ryos17/robosub-ee/research/README.md

# Research

Research work for the RoboSub EE team — exploratory projects that aren't part
of the production vehicle firmware/hardware yet.

- **[`whisper_ivc/`](whisper_ivc/)** — underwater acoustic intervehicle
  communication: streaming hydrophone audio from the vehicle to the Orin and
  transcribing it live with Whisper, as a channel for one sub to "talk" to
  another. Working.

_Last updated: 2026-07-20_
