ryos17/robosub-ee/gen3/PCBs/Battery_Boards/Power_ManagementV3_diode/Power_ManagementV2_side.jpg

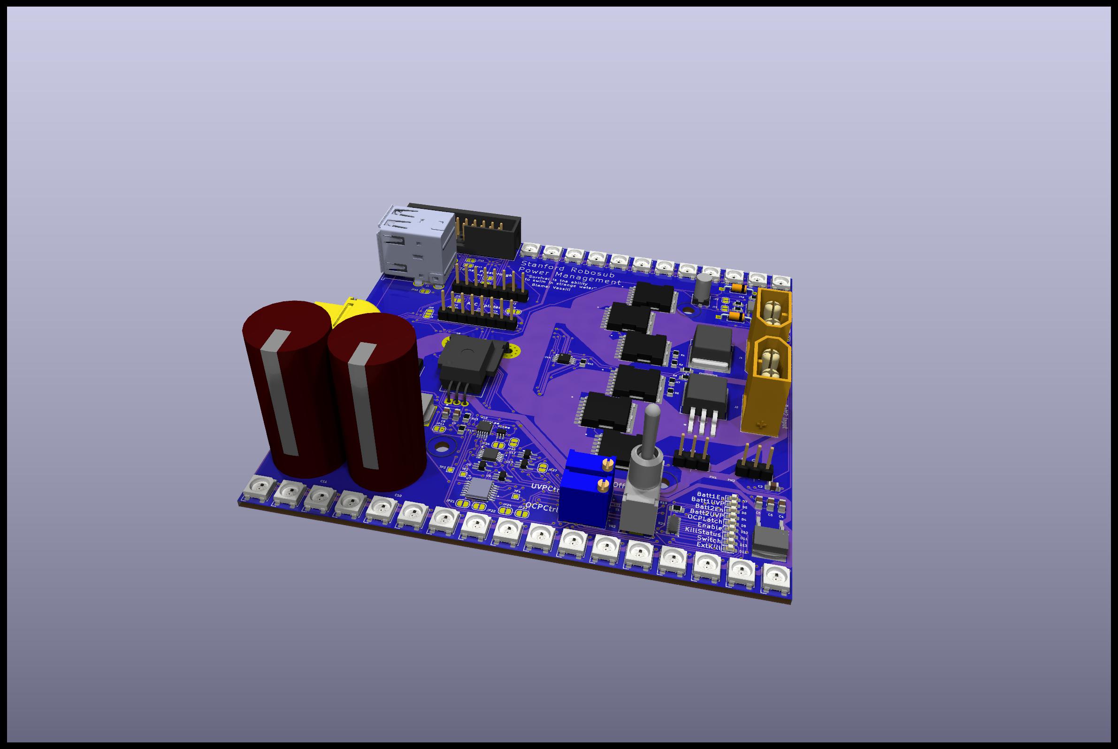
gen3/PCBs/Battery_Boards/Power_ManagementV3_diode/Power_ManagementV2_side.jpg
