ryos17/robosub-ee/misc/current_volatage_reading/current_over_time.png

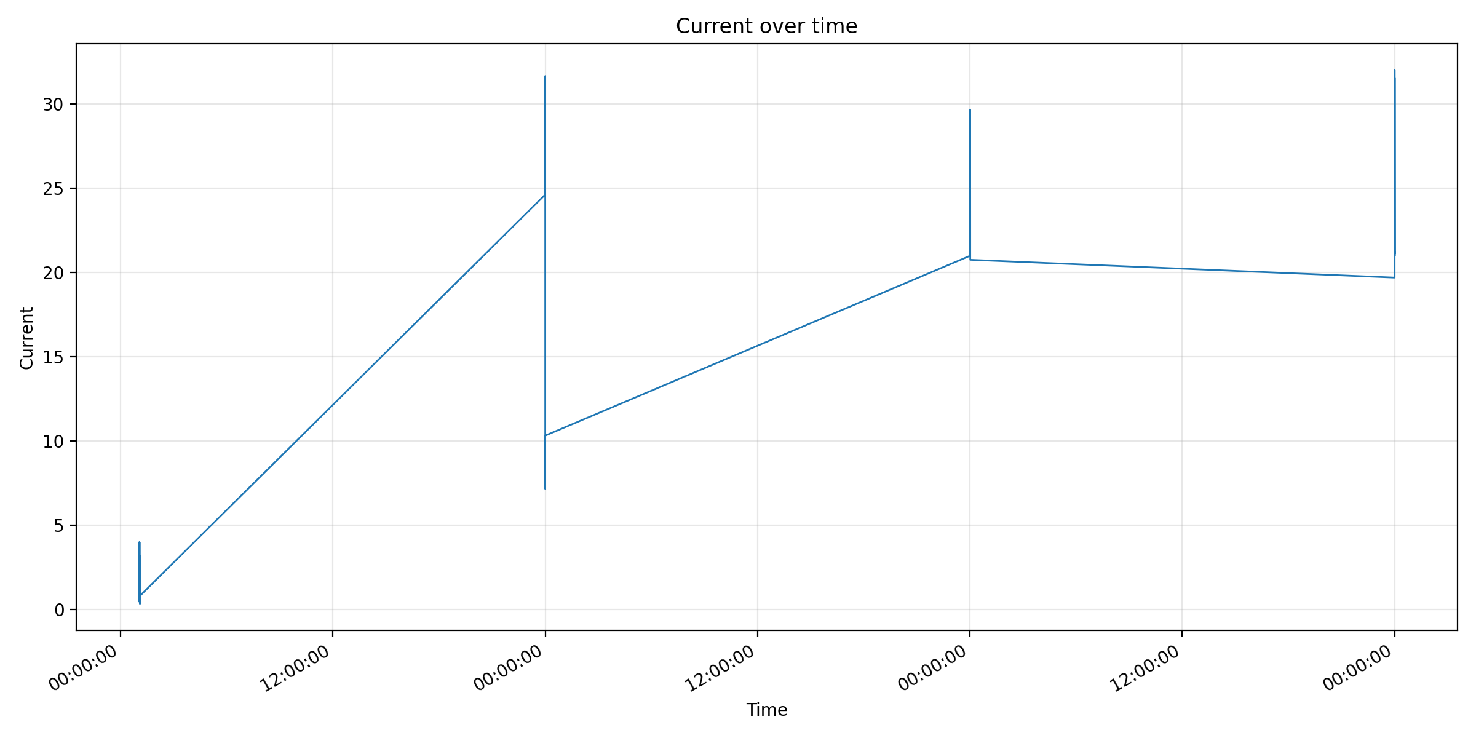
misc/current_volatage_reading/current_over_time.png
