ryos17/robosub-ee/misc/MBARI/MBARI_temperature_profiles.png

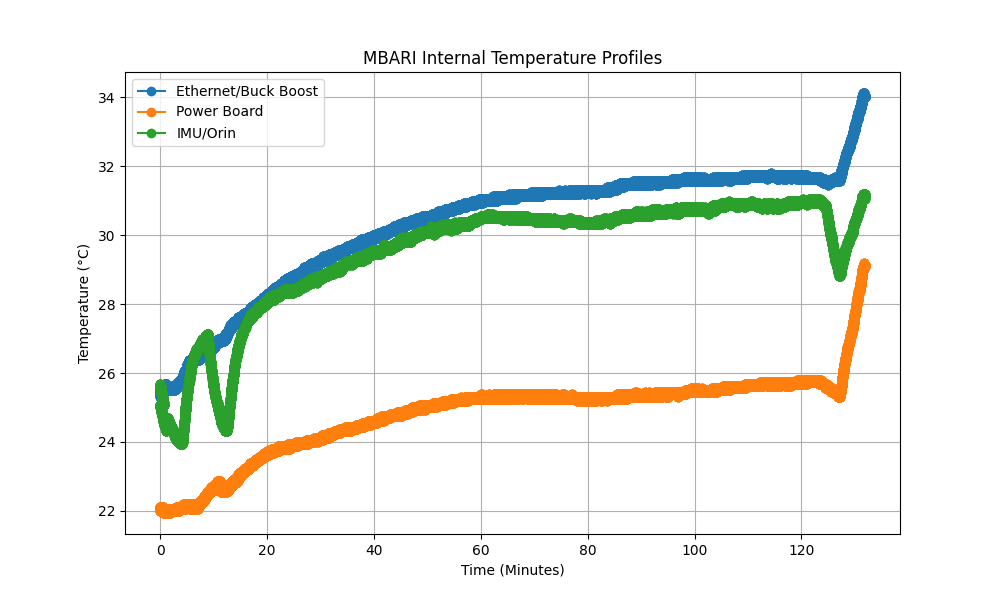
misc/MBARI/MBARI_temperature_profiles.png
