ryos17/robosub-ee/imported_parts/robosub_jlc_parts_log.csv

JLC_Part | Symbol_Name | Footprint | Description
C97627 | MS560702BA03-50 | robosub_footprints:MS560702BA03-50
C80862 | SHT31-DIS-B | robosub_footprints:SHT31-DIS-B
C58069 | L78M05ABDT-TR | robosub_footprints:L78M05ABDT-TR
C5120796 | AMS1117-3_3V_C5120796 | robosub_footprints:AMS1117-3_3V_C5120796
C94847 | MCP9808-E_MS | robosub_footprints:MCP9808-E_MS
C389354 | PMEG2020AEA,115 | robosub_footprints:PMEG2020AEA_115
C112988 | 2SK208-Y(TE85L,F) | robosub_footprints:2SK208-Y(TE85L_F)
C309277 | PJ-609BA | robosub_footprints:PJ-609BA
C5710904 | PTV09A-4015F-B503 | robosub_footprints:PTV09A-4015F-B503
C2876025 | SS-22F22-G060 | robosub_footprints:SS-22F22-G060
C16214 | DC-005_5_5-2_0MM | robosub_footprints:DC-005_5_5-2_0MM
