ryos17/robosub-ee/gen3/PCBs/Battery_Boards/Power_ManagementV3_diode/3D Models/SOS-ASM-LEAK-SENSOR-R1.SLDPRT

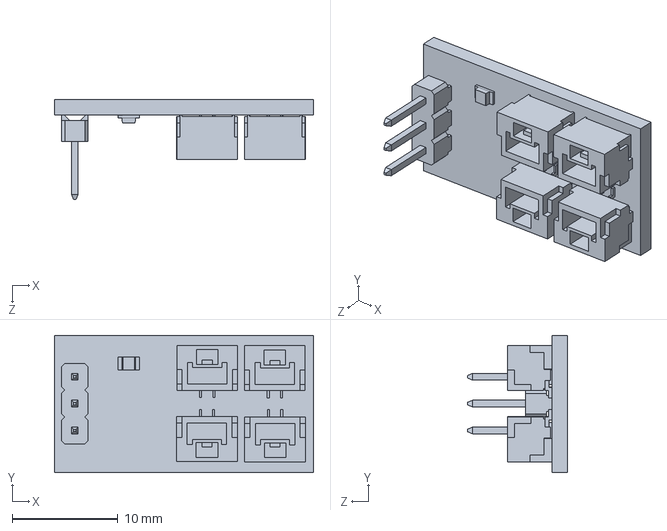
[picture p8: CAD file, 2026-02-21]
gen3/PCBs/Battery_Boards/Power_ManagementV3_diode/3D Models/SOS-ASM-LEAK-SENSOR-R1.SLDPRT
24.5 x 13.0 x 9.50 mm
