ryos17/robosub-ee/gen3/PCBs/Battery_Boards/Power_ManagementV3_diode/3D Models/CAP_UCB_4X7_NCH.step

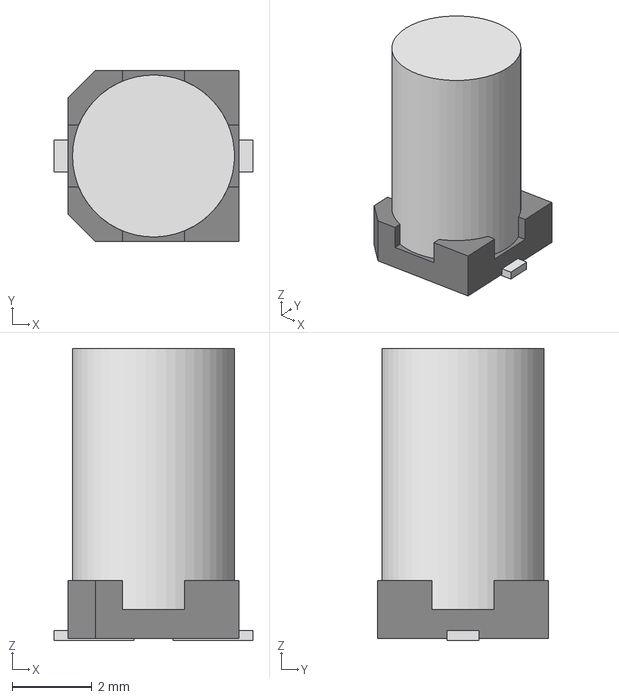
[picture p9: CAD file, 2026-02-21]
gen3/PCBs/Battery_Boards/Power_ManagementV3_diode/3D Models/CAP_UCB_4X7_NCH.step
5.00 x 4.29 x 7.34 mm
