ryos17/robosub-ee/gen3/PCBs/Battery_Boards/Power_ManagementV3_diode/_models/MCP6564_E_ST/TSSOP14_MC_MCH.step

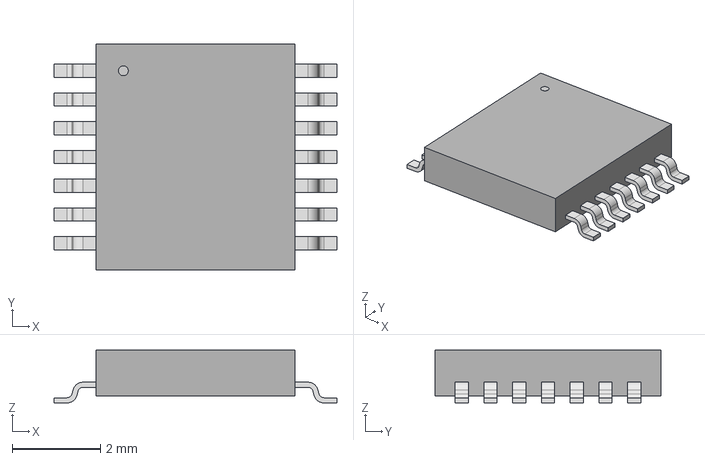
[picture p10: CAD file, 2026-02-21]
gen3/PCBs/Battery_Boards/Power_ManagementV3_diode/_models/MCP6564_E_ST/TSSOP14_MC_MCH.step
6.40 x 5.11 x 1.20 mm
