ryos17/robosub-ee/gen3/PCBs/Battery_Boards/Power_ManagementV3_diode/_models/SN74HC132PWR/SN74HC132PWR.step

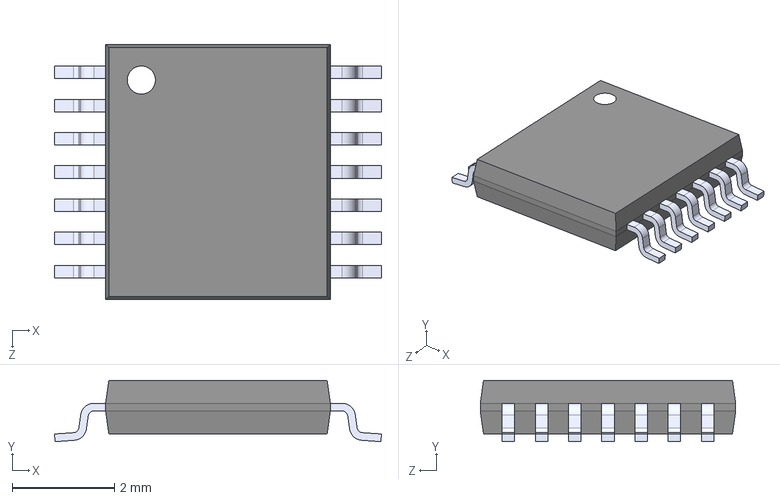
[picture p11: CAD file, 2026-02-21]
gen3/PCBs/Battery_Boards/Power_ManagementV3_diode/_models/SN74HC132PWR/SN74HC132PWR.step
6.40 x 1.20 x 5.00 mm
