ryos17/robosub-ee/gen3/PCBs/Battery_Boards/Power_ManagementV3_diode/_models/TC33X_2_105E/TC33X-2-105E.step

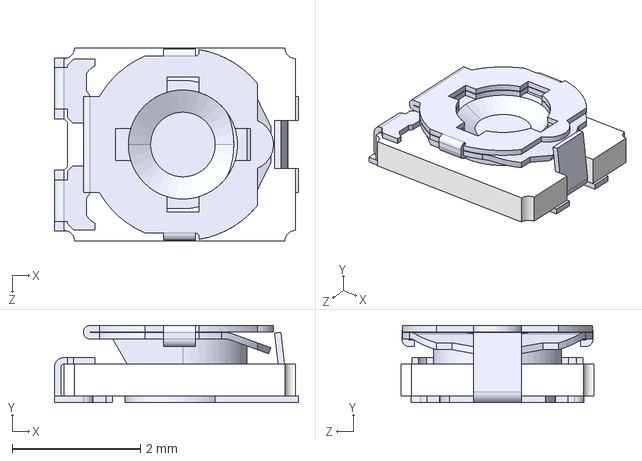
[picture p12: CAD file, 2026-02-21]
gen3/PCBs/Battery_Boards/Power_ManagementV3_diode/_models/TC33X_2_105E/TC33X-2-105E.step
3.80 x 1.20 x 3.00 mm
