ryos17/robosub-ee/gen3/PCBs/Power_Distribution/3D Models/TBL008V-1000-04BE.step

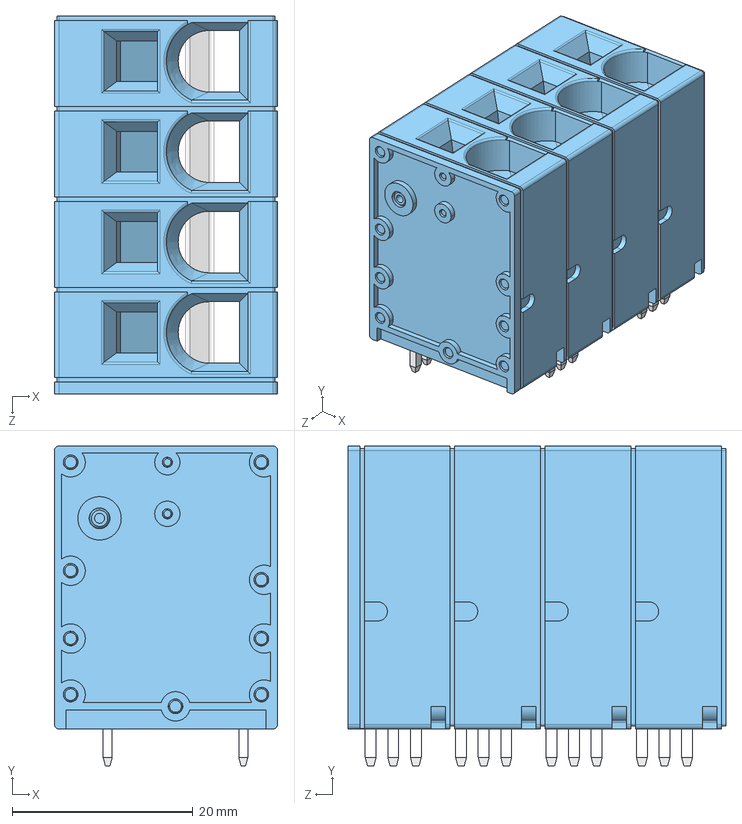
[picture p13: CAD file, 2026-02-25]
gen3/PCBs/Power_Distribution/3D Models/TBL008V-1000-04BE.step
24.7 x 35.4 x 41.8 mm
