ryos17/robosub-ee/imported_parts/robosub_3d_models/DC-005_5_5-2_0MM.step

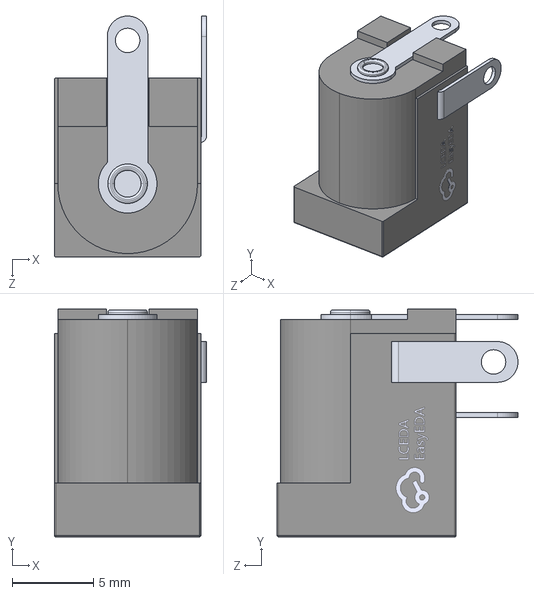
[picture p14: CAD file, 2026-07-27]
imported_parts/robosub_3d_models/DC-005_5_5-2_0MM.step
9.35 x 14.0 x 14.8 mm
