ryos17/robosub-ee/gen3/PCBs/Battery_Boards/Power_ManagementV3_diode/3D Models/URB2405YMD-20WR3.step

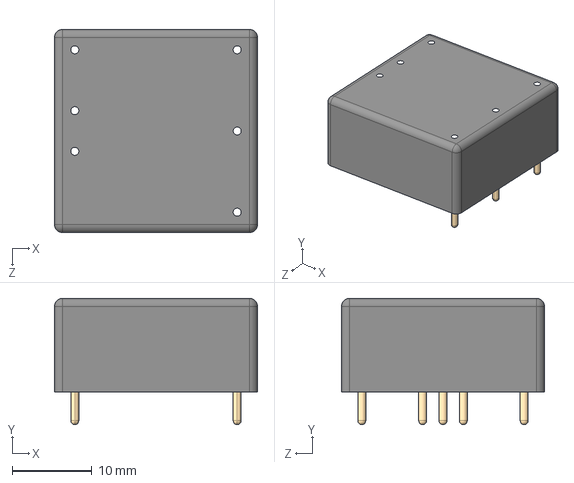
[picture p15: CAD file, 2026-02-21]
gen3/PCBs/Battery_Boards/Power_ManagementV3_diode/3D Models/URB2405YMD-20WR3.step
25.4 x 15.8 x 25.4 mm
