ryos17/robosub-ee/gen3/PCBs/Battery_Boards/Power_ManagementV3_eli/3D Models/ACS713ELCTR-30A-T.stp

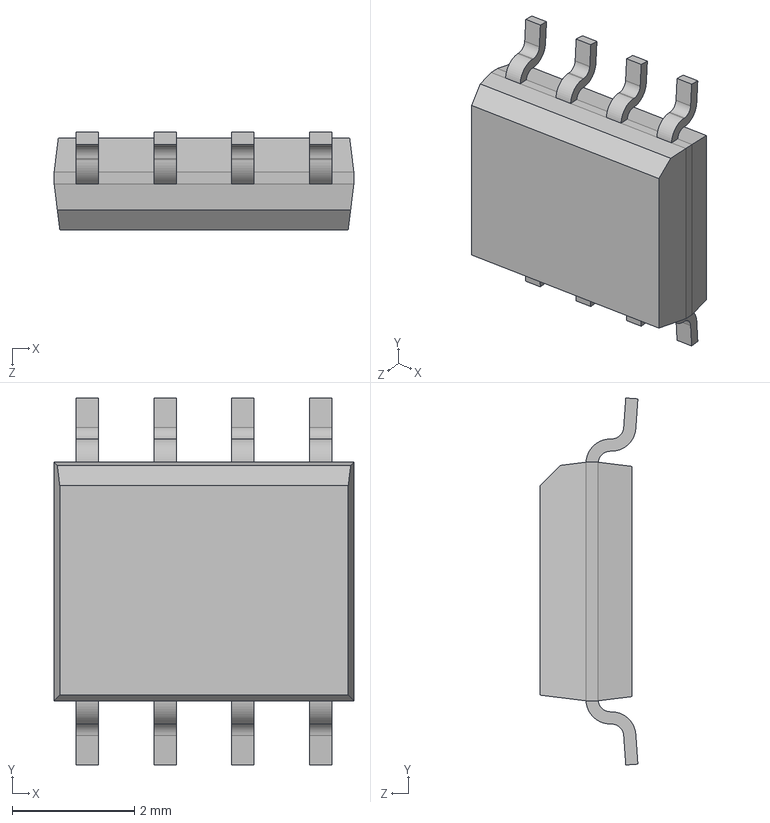
[picture p16: CAD file, 2026-02-21]
gen3/PCBs/Battery_Boards/Power_ManagementV3_eli/3D Models/ACS713ELCTR-30A-T.stp
4.90 x 6.00 x 1.60 mm
