ryos17/robosub-ee/gen3/PCBs/Power_Distribution/3D Models/XT60 FEMALE.STEP

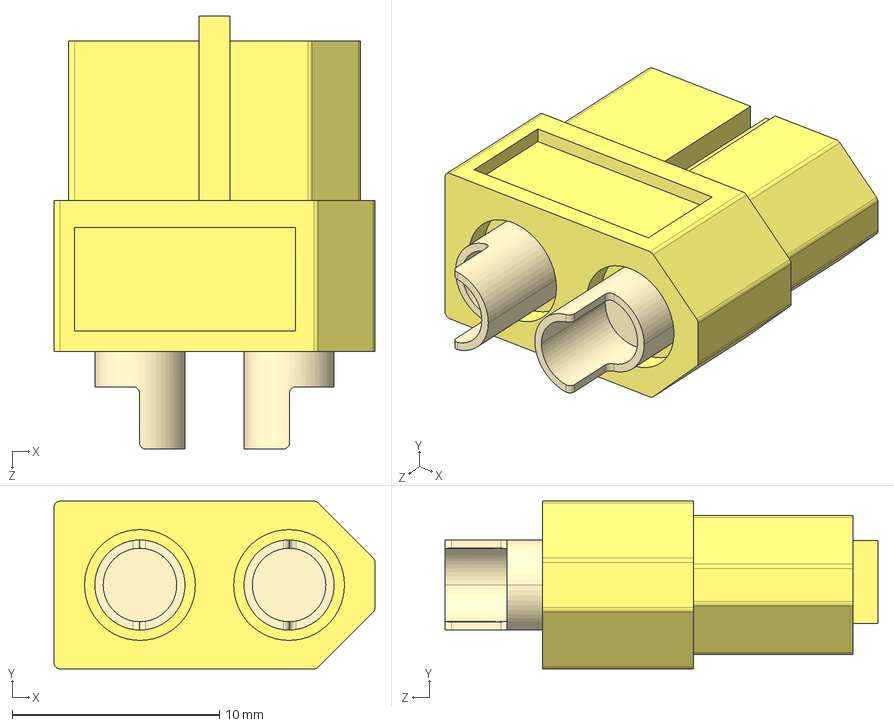
[picture p17: CAD file, 2026-02-21]
gen3/PCBs/Power_Distribution/3D Models/XT60 FEMALE.STEP
15.5 x 8.10 x 20.9 mm
