ryos17/robosub-ee/imported_parts/robosub_3d_models/PTV09A-4015F-B503.step

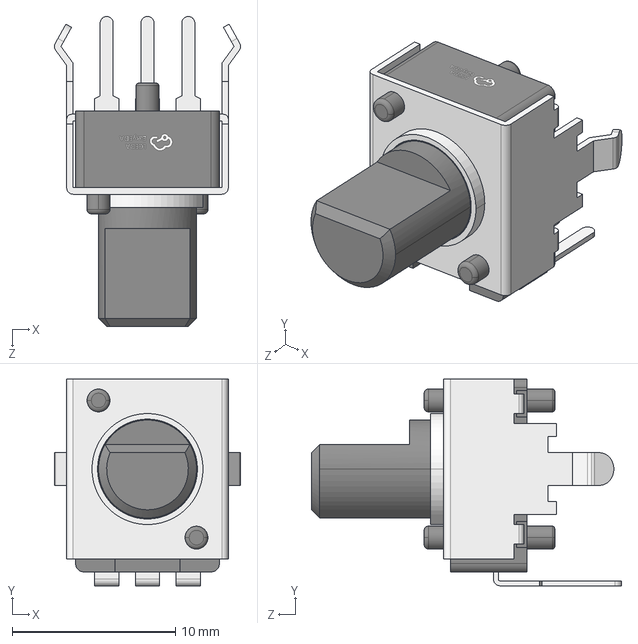
[picture p18: CAD file, 2026-07-27]
imported_parts/robosub_3d_models/PTV09A-4015F-B503.step
11.4 x 12.7 x 19.0 mm
