ryos17/robosub-ee/gen3/PCBs/Battery_Boards/Power_ManagementV3_diode/3D Models/XT60 MALE.STEP

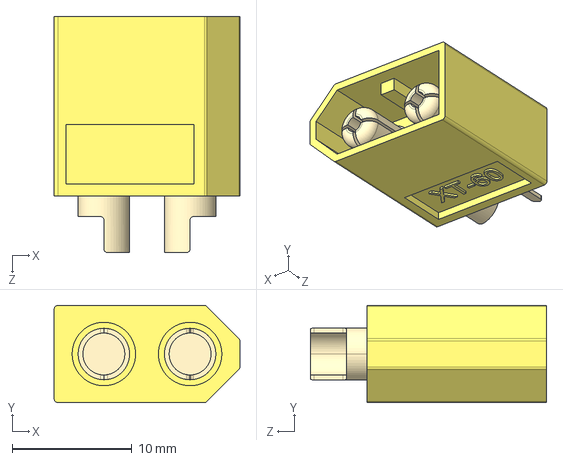
[picture p19: CAD file, 2026-02-21]
gen3/PCBs/Battery_Boards/Power_ManagementV3_diode/3D Models/XT60 MALE.STEP
15.5 x 8.10 x 19.7 mm
