ryos17/robosub-ee/gen3/PCBs/Battery_Boards/Power_ManagementV3_eli/3D Models/CAP_PKPZ_16X31P5_RUB.step

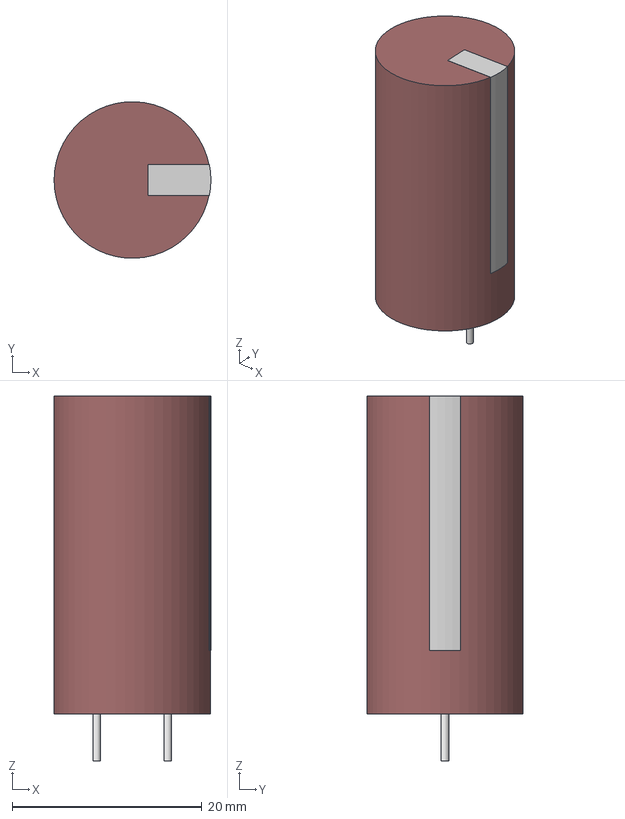
[picture p20: CAD file, 2026-02-21]
gen3/PCBs/Battery_Boards/Power_ManagementV3_eli/3D Models/CAP_PKPZ_16X31P5_RUB.step
16.5 x 16.5 x 38.5 mm
