ryos17/robosub-ee/imported_parts/robosub_3d_models/PJ-609BA.step

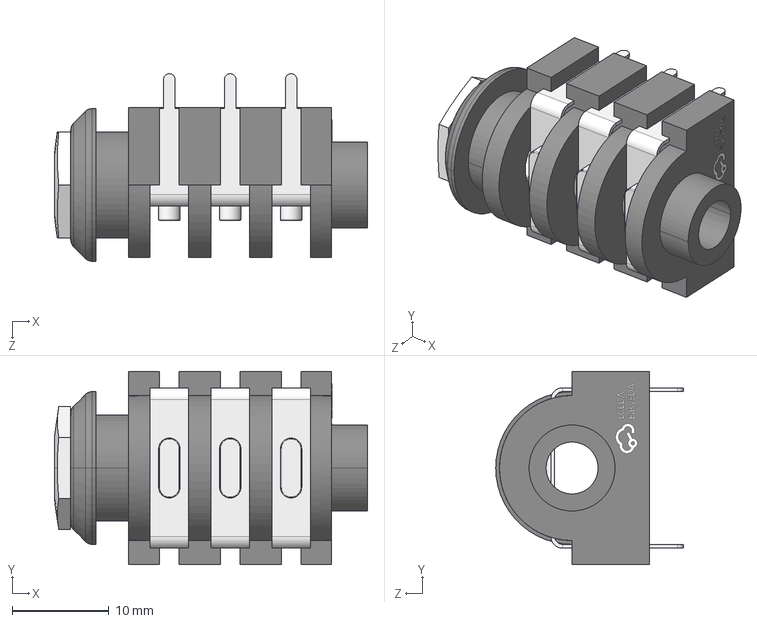
[picture p21: CAD file, 2026-07-27]
imported_parts/robosub_3d_models/PJ-609BA.step
32.4 x 20.0 x 19.4 mm
