ryos17/robosub-ee/gen3/PCBs/Battery_Boards/Power_ManagementV3_diode/3D Models/AU-Y1008-2.STEP

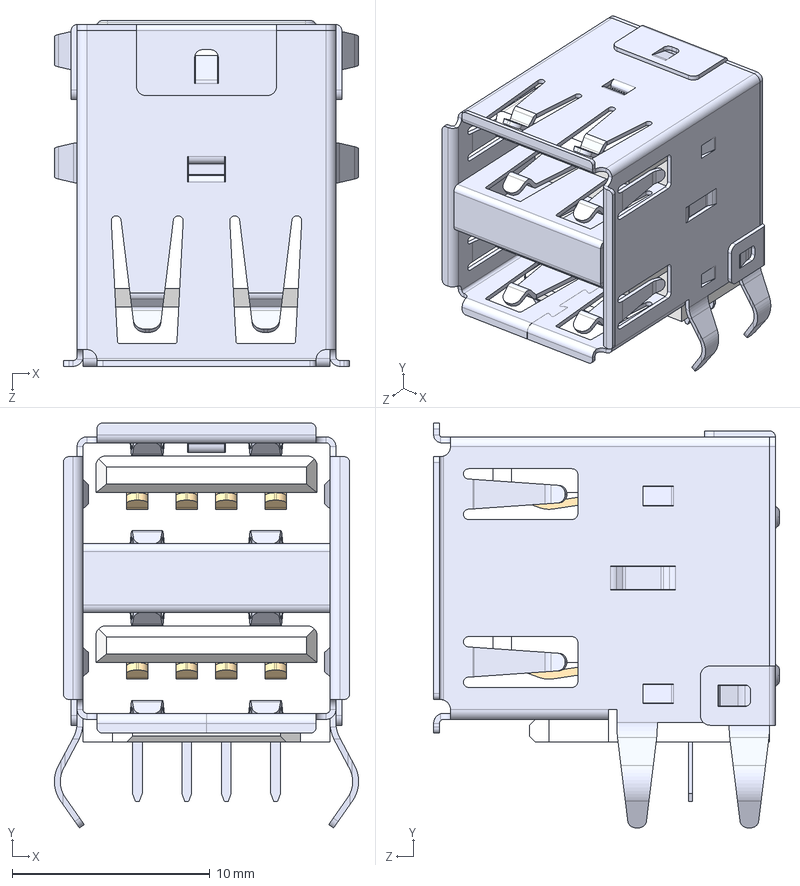
[picture p22: CAD file, 2026-02-21]
gen3/PCBs/Battery_Boards/Power_ManagementV3_diode/3D Models/AU-Y1008-2.STEP
15.4 x 20.5 x 17.5 mm
