ryos17/robosub-ee/gen3/PCBs/Battery_Boards/Power_ManagementV3_eli/3D Models/J1B1211CCD.stp

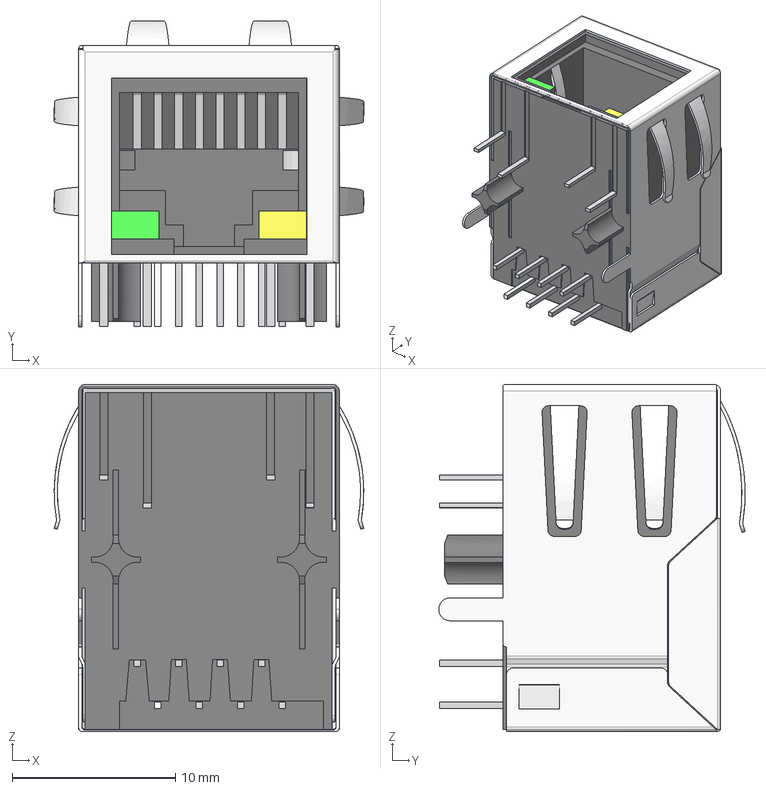
[picture p23: CAD file, 2026-02-21]
gen3/PCBs/Battery_Boards/Power_ManagementV3_eli/3D Models/J1B1211CCD.stp
19.0 x 18.8 x 21.3 mm
