ryos17/robosub-ee/gen3/PCBs/Power_Distribution/3D Models/XT60PW MALE.STEP

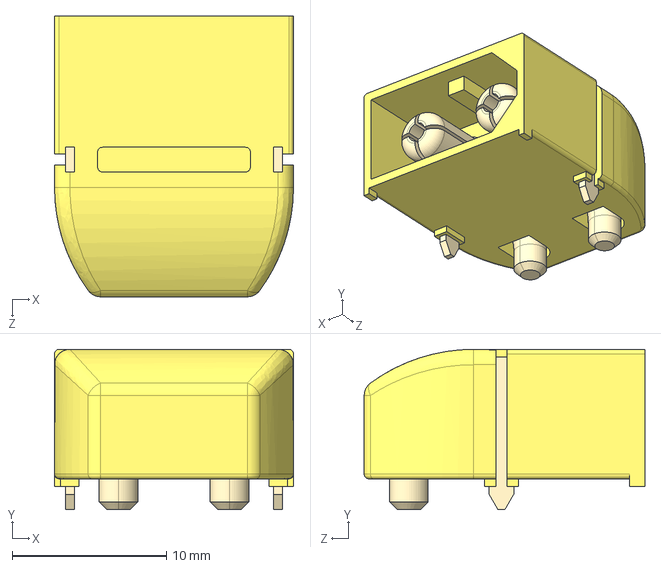
[picture p24: CAD file, 2026-02-21]
gen3/PCBs/Power_Distribution/3D Models/XT60PW MALE.STEP
15.5 x 10.4 x 18.2 mm
