ryos17/robosub-ee/imported_parts/robosub_3d_models/2SK208-Y(TE85L_F).step

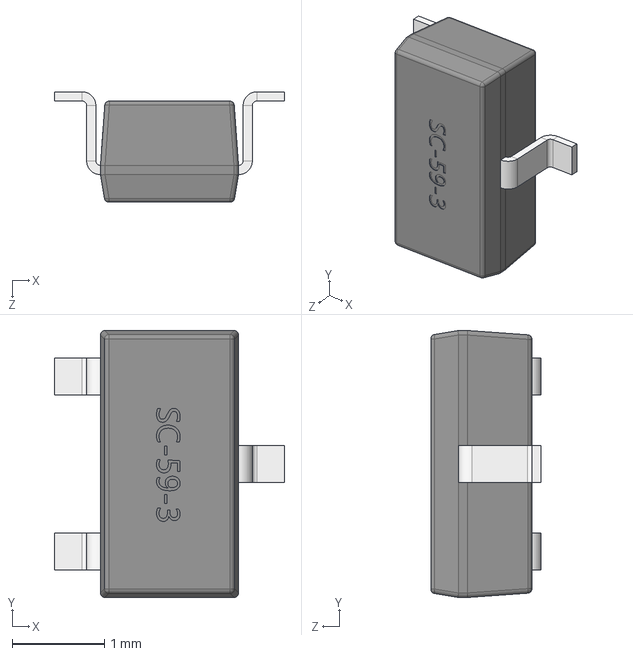
[picture p25: CAD file, 2026-07-26]
imported_parts/robosub_3d_models/2SK208-Y(TE85L_F).step
2.50 x 2.90 x 1.20 mm
