ryos17/robosub-ee/gen3/PCBs/Battery_Boards/Power_ManagementV3_eli/3D Models/pwr163.stp

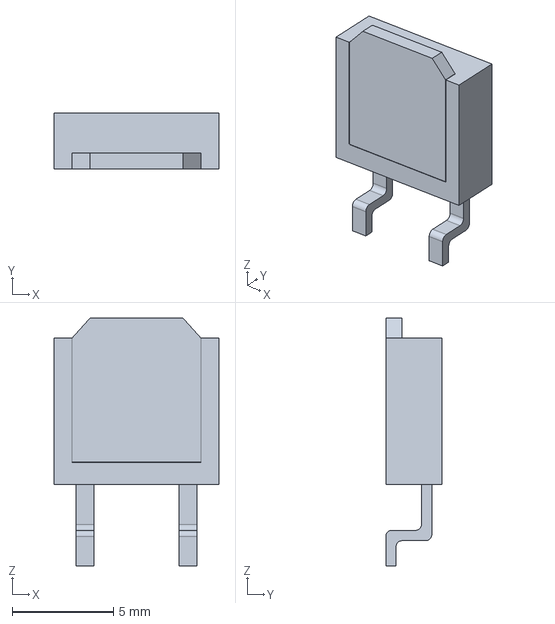
[picture p26: CAD file, 2026-02-21]
gen3/PCBs/Battery_Boards/Power_ManagementV3_eli/3D Models/pwr163.stp
8.13 x 2.79 x 12.2 mm
