ryos17/robosub-ee/imported_parts/robosub_3d_models/BME280.step

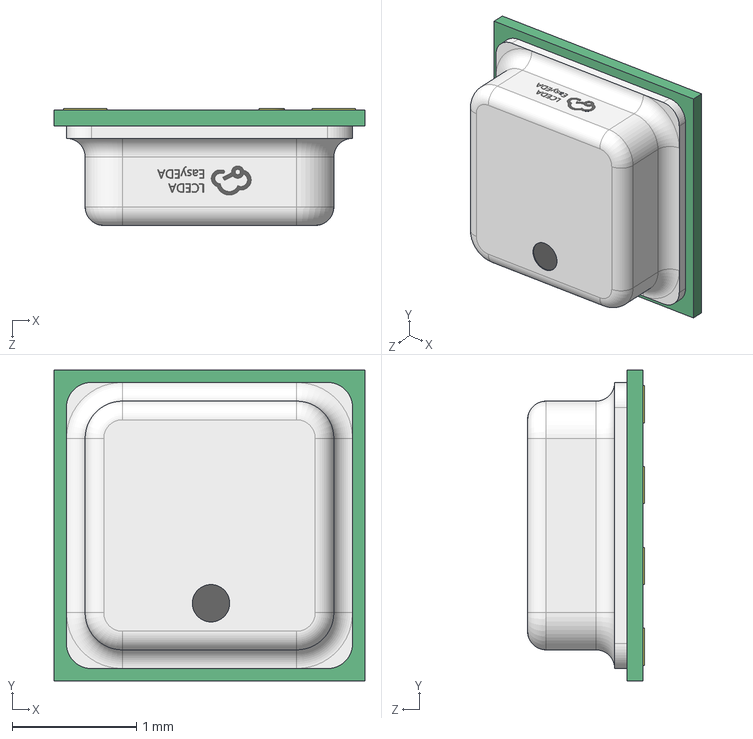
[picture p27: CAD file, 2026-04-22]
imported_parts/robosub_3d_models/BME280.step
2.50 x 2.50 x 0.94 mm
