ryos17/robosub-ee/gen3/PCBs/Battery_Boards/Power_ManagementV3_diode/3D Models/SBH11-PBPC-D10-ST-BK.step

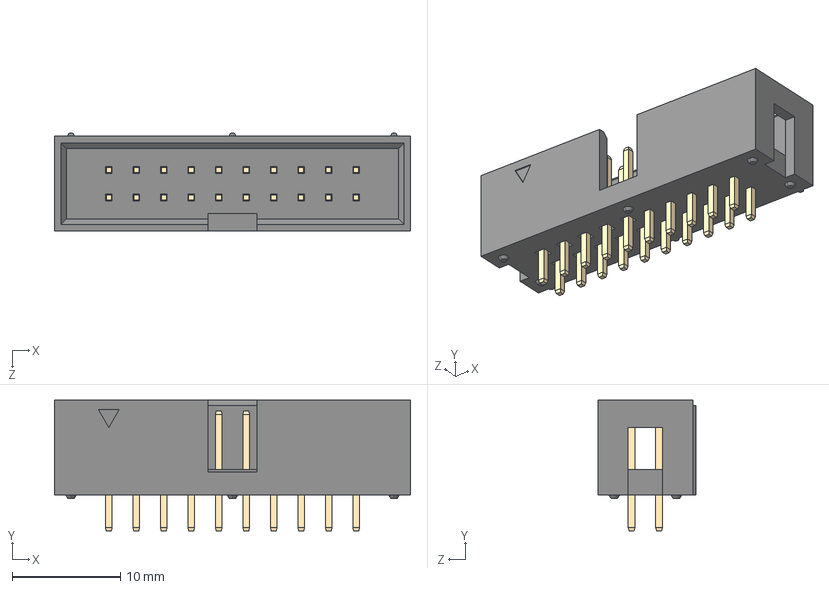
[picture p28: CAD file, 2026-02-21]
gen3/PCBs/Battery_Boards/Power_ManagementV3_diode/3D Models/SBH11-PBPC-D10-ST-BK.step
32.9 x 12.1 x 9.09 mm
