ryos17/robosub-ee/gen3/PCBs/Battery_Boards/Power_ManagementV3_eli/3D Models/ACS758ECB-200B-PFF-T.stp

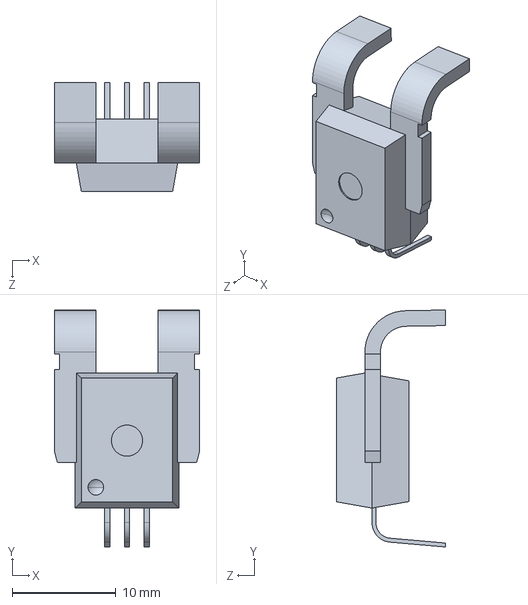
[picture p29: CAD file, 2026-02-21]
gen3/PCBs/Battery_Boards/Power_ManagementV3_eli/3D Models/ACS758ECB-200B-PFF-T.stp
14.0 x 22.8 x 10.5 mm
