ryos17/robosub-ee/imported_parts/robosub_3d_models/SHT31-DIS-B.step

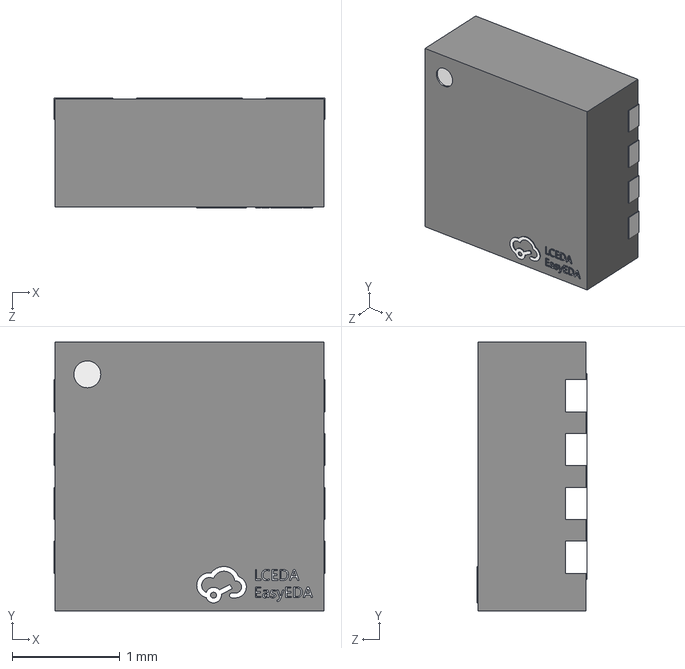
[picture p30: CAD file, 2026-04-22]
imported_parts/robosub_3d_models/SHT31-DIS-B.step
2.52 x 2.50 x 1.02 mm
