ryos17/robosub-ee/gen3/PCBs/Battery_Boards/Power_ManagementV3_eli/3D Models/100SP1T1B4M2QE.step

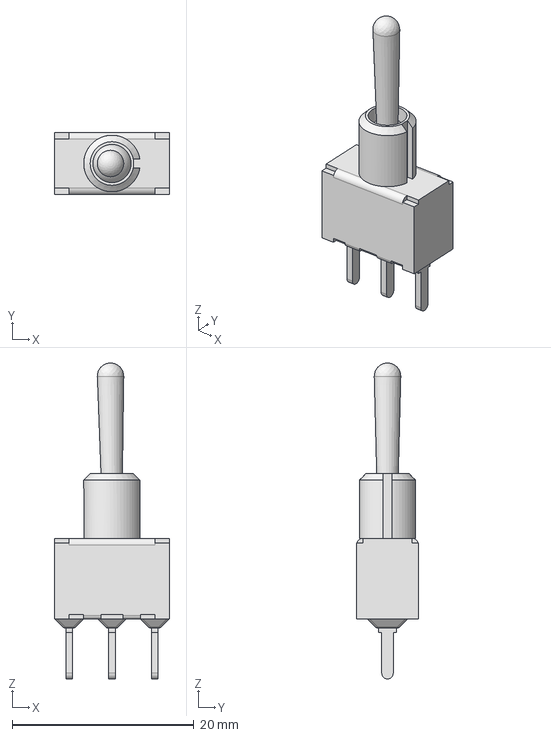
[picture p31: CAD file, 2026-02-21]
gen3/PCBs/Battery_Boards/Power_ManagementV3_eli/3D Models/100SP1T1B4M2QE.step
12.7 x 6.86 x 34.8 mm
