ryos17/robosub-ee/imported_parts/robosub_3d_models/MCP9808-E_MS.step

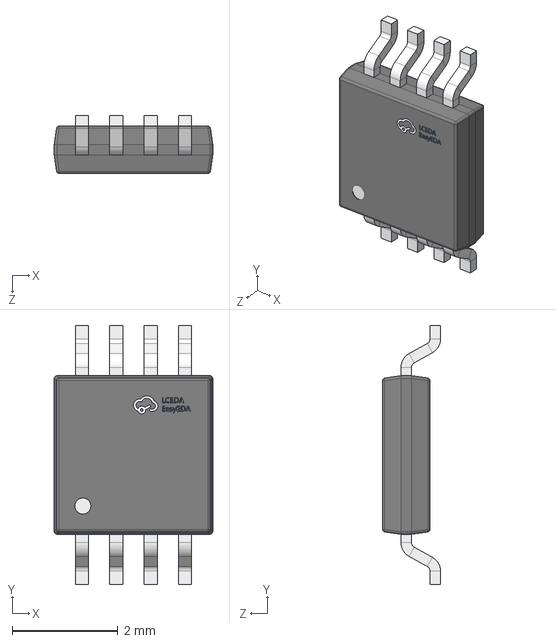
[picture p32: CAD file, 2026-04-22]
imported_parts/robosub_3d_models/MCP9808-E_MS.step
3.00 x 4.90 x 1.10 mm
