ryos17/robosub-ee/gen3/PCBs/Battery_Boards/Power_ManagementV3_eli/3D Models/MCP9808T-E_MS.step

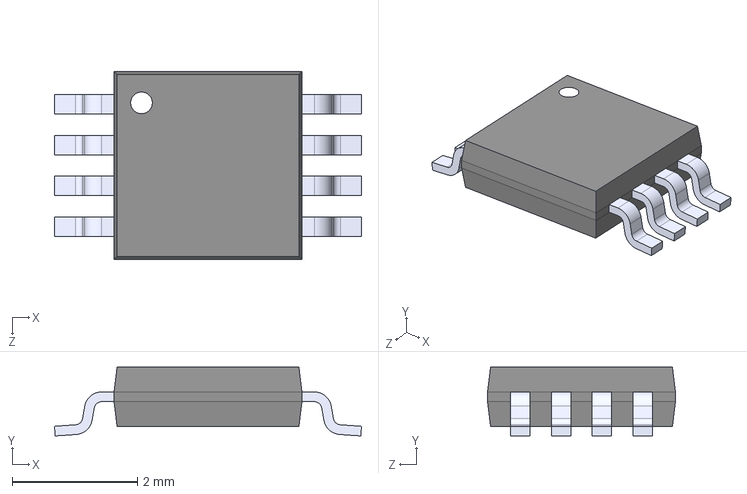
[picture p33: CAD file, 2026-02-21]
gen3/PCBs/Battery_Boards/Power_ManagementV3_eli/3D Models/MCP9808T-E_MS.step
4.90 x 1.10 x 3.00 mm
