ryos17/robosub-ee/imported_parts/robosub_3d_models/AMS1117-3_3V_C5120796.step

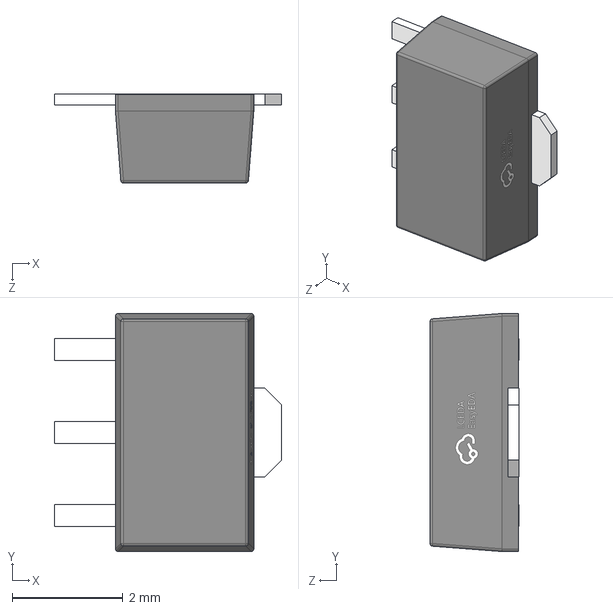
[picture p34: CAD file, 2026-04-22]
imported_parts/robosub_3d_models/AMS1117-3_3V_C5120796.step
4.10 x 4.30 x 1.61 mm
