ryos17/robosub-ee/gen3/PCBs/Battery_Boards/Power_ManagementV3_eli/3D Models/TSSOP14_STM.step

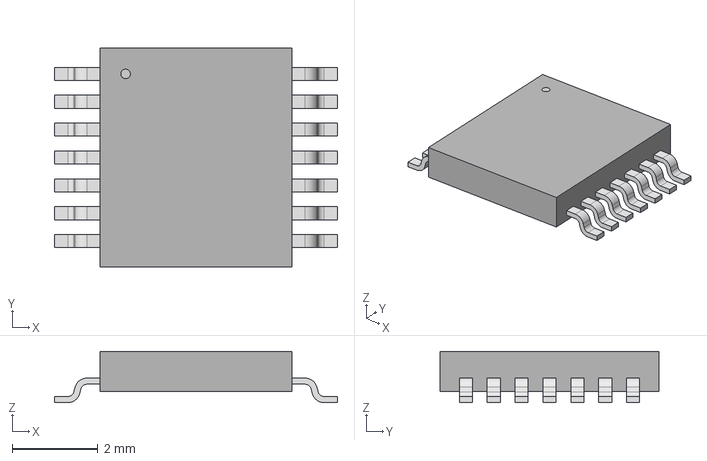
[picture p35: CAD file, 2026-02-21]
gen3/PCBs/Battery_Boards/Power_ManagementV3_eli/3D Models/TSSOP14_STM.step
6.60 x 5.11 x 1.20 mm
