ryos17/robosub-ee/imported_parts/robosub_3d_models/L78M05ABDT-TR.step

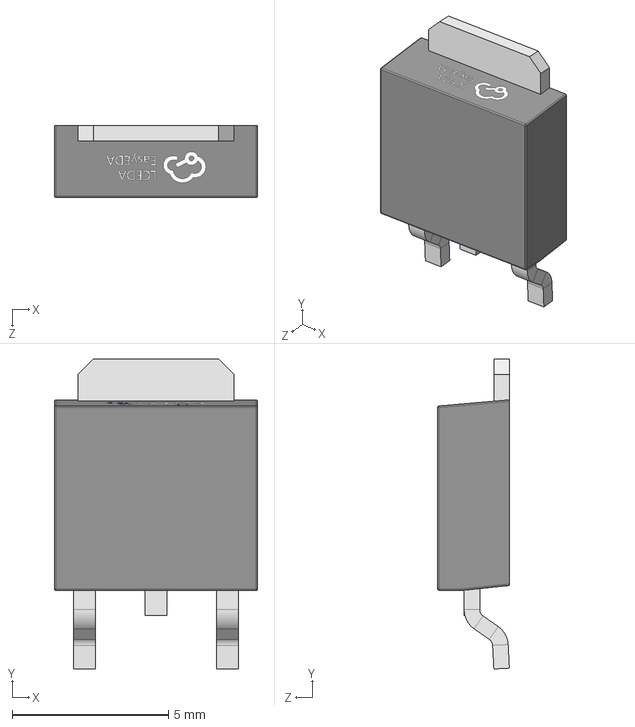
[picture p36: CAD file, 2026-04-22]
imported_parts/robosub_3d_models/L78M05ABDT-TR.step
6.50 x 9.92 x 2.30 mm
