ryos17/robosub-ee/gen3/PCBs/Battery_Boards/Power_ManagementV3_diode/3D Models/3296W-1-103RLF.STEP

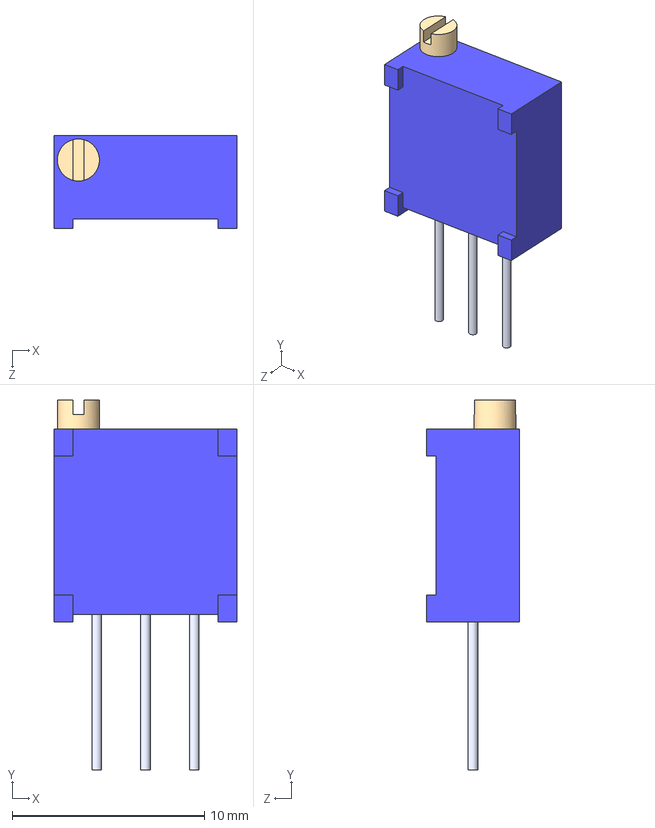
[picture p37: CAD file, 2026-02-21]
gen3/PCBs/Battery_Boards/Power_ManagementV3_diode/3D Models/3296W-1-103RLF.STEP
9.53 x 19.3 x 4.83 mm
