ryos17/robosub-ee/imported_parts/robosub_3d_models/PMEG2020AEA_115.step

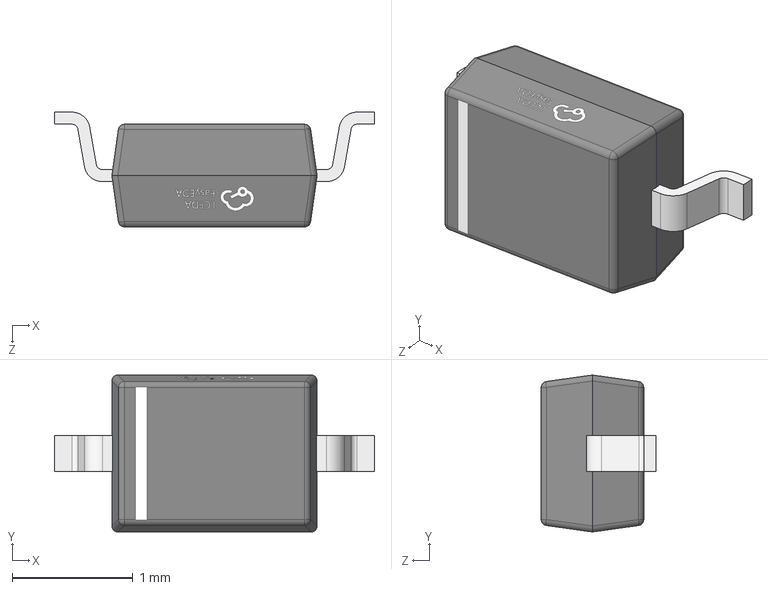
[picture p38: CAD file, 2026-04-22]
imported_parts/robosub_3d_models/PMEG2020AEA_115.step
2.65 x 1.30 x 0.95 mm
