ryos17/robosub-ee/gen3/PCBs/Battery_Boards/Power_ManagementV3_eli/3D Models/XT30PW-F.stp

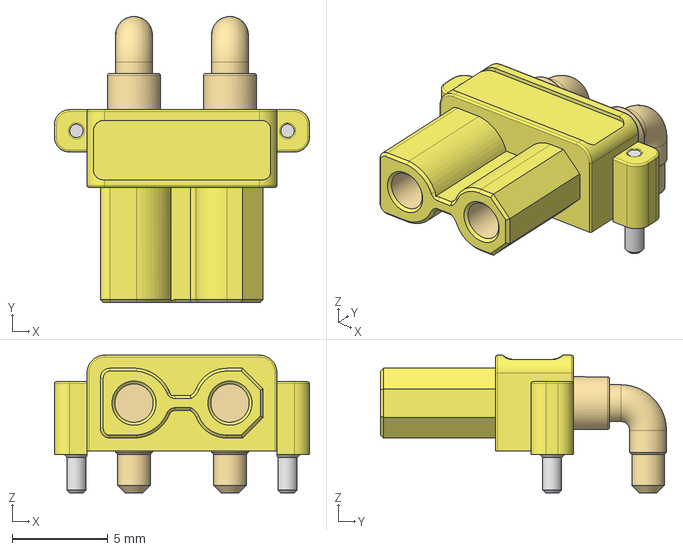
[picture p40: CAD file, 2026-02-21]
gen3/PCBs/Battery_Boards/Power_ManagementV3_eli/3D Models/XT30PW-F.stp
13.3 x 14.9 x 7.18 mm
