ryos17/robosub-ee/gen3/PCBs/Battery_Boards/Power_ManagementV3_diode/3D Models/XT60PW FEMALE.STEP

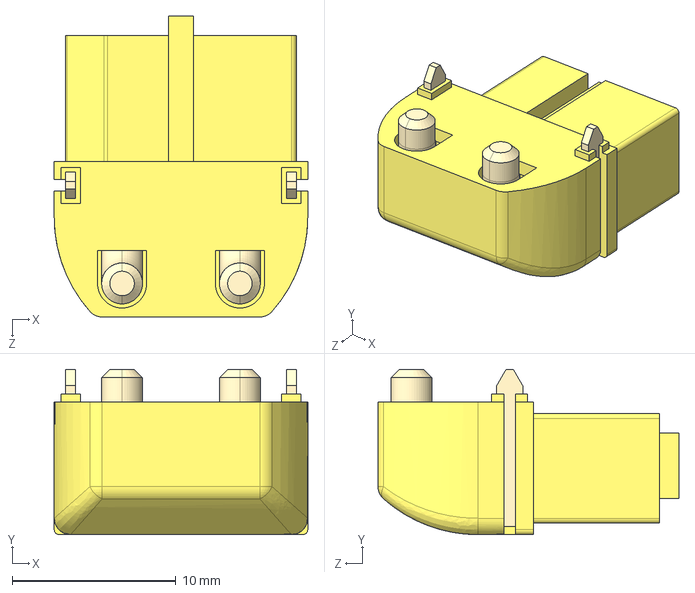
[picture p41: CAD file, 2026-02-21]
gen3/PCBs/Battery_Boards/Power_ManagementV3_diode/3D Models/XT60PW FEMALE.STEP
15.5 x 10.1 x 18.4 mm
