ryos17/robosub-ee/gen3/PCBs/Battery_Boards/Power_ManagementV3_diode/3D Models/MCTL160N15Y-TP.stp

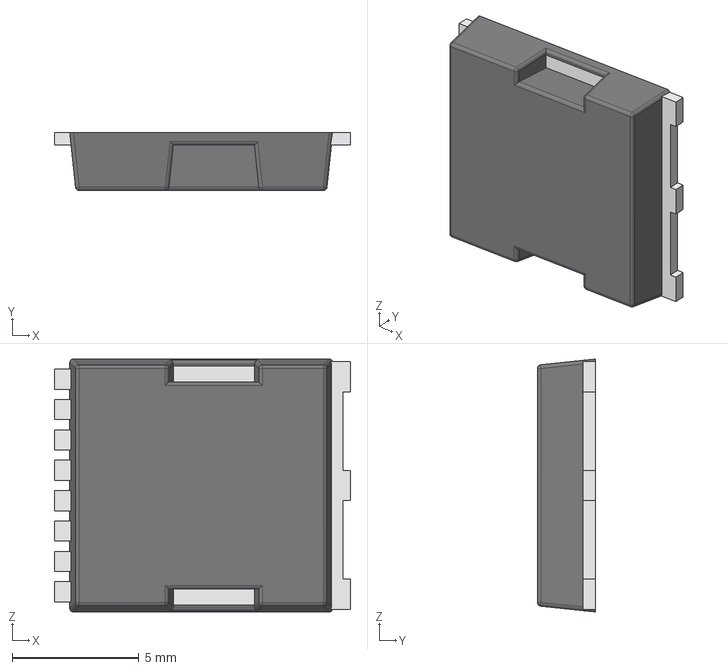
[picture p42: CAD file, 2026-02-21]
gen3/PCBs/Battery_Boards/Power_ManagementV3_diode/3D Models/MCTL160N15Y-TP.stp
11.7 x 2.30 x 10.0 mm
��1
��2
