ryos17/robosub-ee/imported_parts/robosub_3d_models/SBH11-PBPC-D05-ST-BK.step

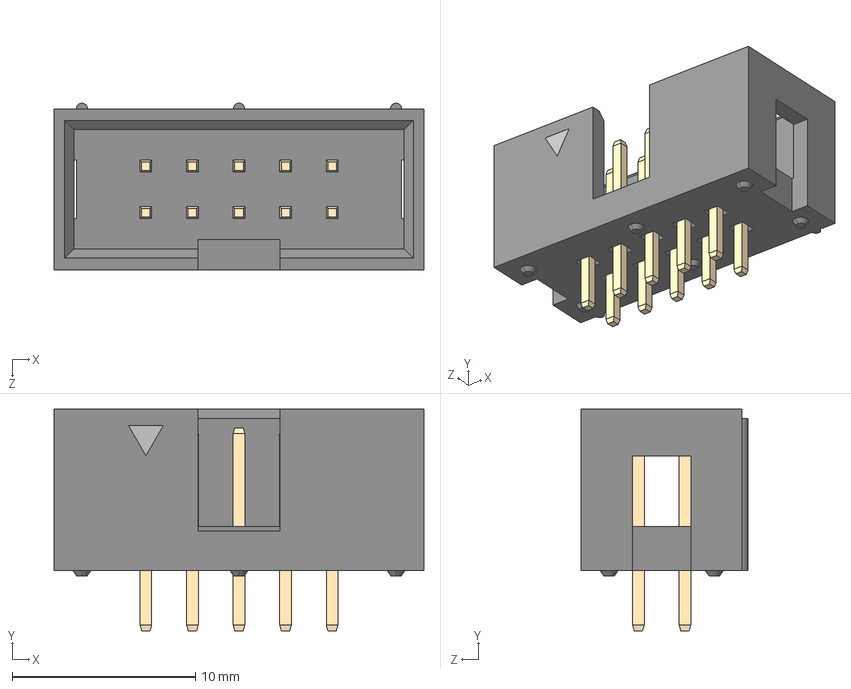
[picture p43: CAD file, 2026-02-22]
imported_parts/robosub_3d_models/SBH11-PBPC-D05-ST-BK.step
20.2 x 12.1 x 9.09 mm
