ryos17/robosub-ee/gen3/PCBs/Battery_Boards/Power_ManagementV3_eli/3D Models/TSSOP14B_z90.stp

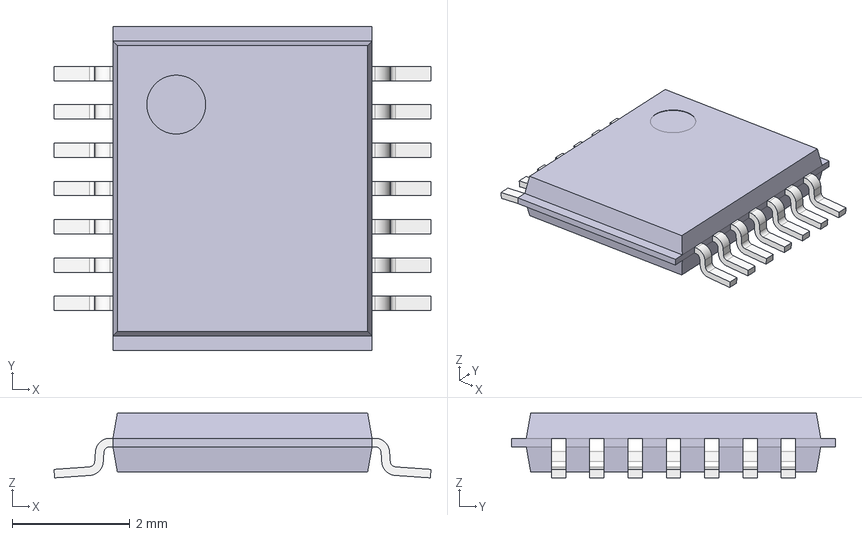
[picture p45: CAD file, 2026-02-21]
gen3/PCBs/Battery_Boards/Power_ManagementV3_eli/3D Models/TSSOP14B_z90.stp
6.40 x 5.50 x 1.10 mm
