ryos17/robosub-ee/gen3/PCBs/Battery_Boards/Power_ManagementV3_eli/3D Models/TO252-3_ROM.step

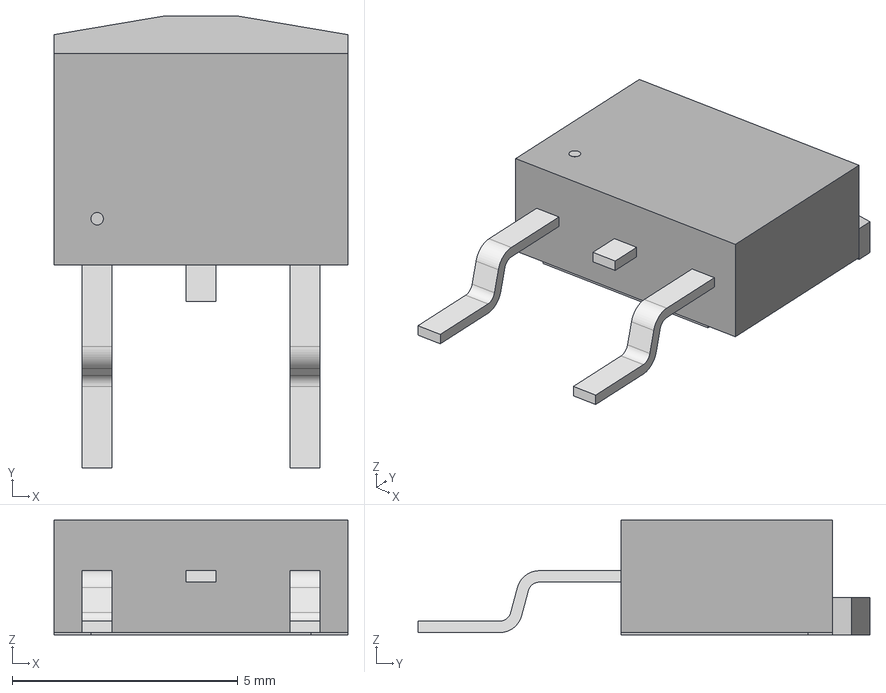
[picture p47: CAD file, 2026-02-21]
gen3/PCBs/Battery_Boards/Power_ManagementV3_eli/3D Models/TO252-3_ROM.step
6.50 x 10.0 x 2.54 mm
