ryos17/robosub-ee/gen3/PCBs/Battery_Boards/Power_ManagementV3_diode/3D Models/K104K15X7RF5TL2_VIS.step

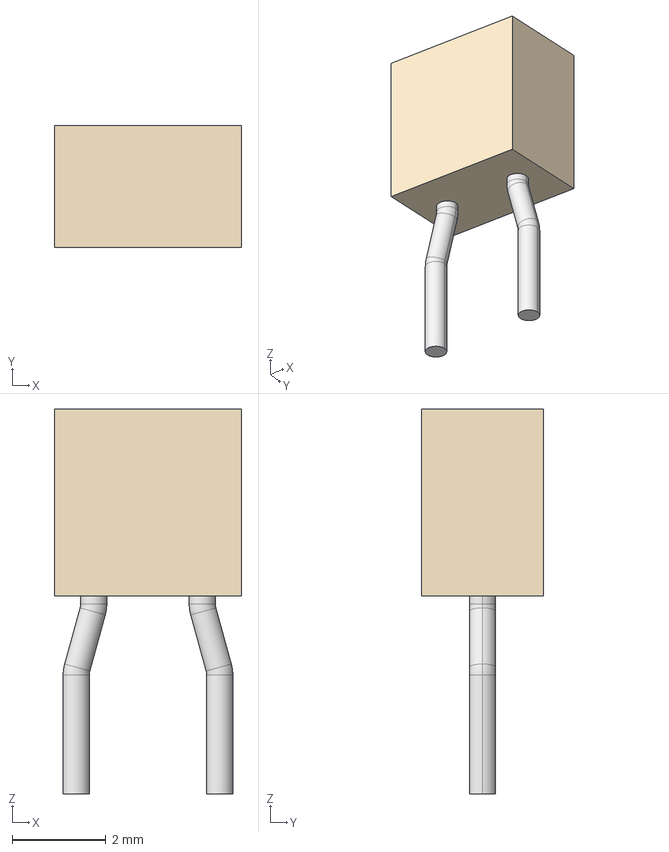
[picture p48: CAD file, 2026-02-21]
gen3/PCBs/Battery_Boards/Power_ManagementV3_diode/3D Models/K104K15X7RF5TL2_VIS.step
3.99 x 2.59 x 8.20 mm
