ryos17/robosub-ee/gen3/PCBs/Battery_Boards/Power_ManagementV3_diode/3D Models/09.03201.02.STEP

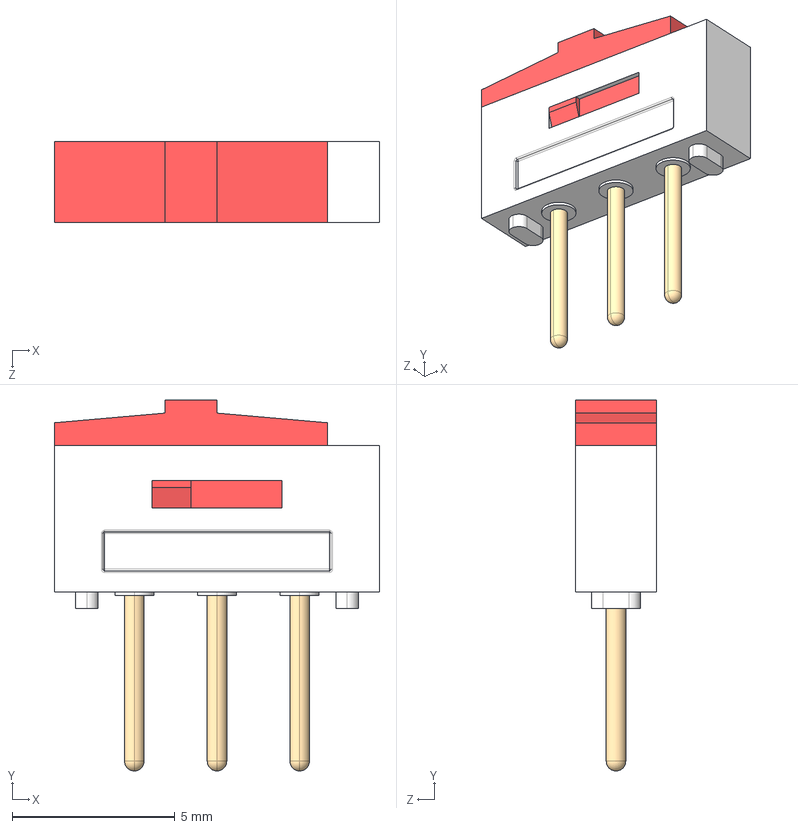
[picture p49: CAD file, 2026-02-21]
gen3/PCBs/Battery_Boards/Power_ManagementV3_diode/3D Models/09.03201.02.STEP
10.0 x 11.4 x 2.50 mm
