ryos17/robosub-ee/gen3/PCBs/Battery_Boards/Power_ManagementV3_diode/3D Models/D2PAK-2 L7805.step

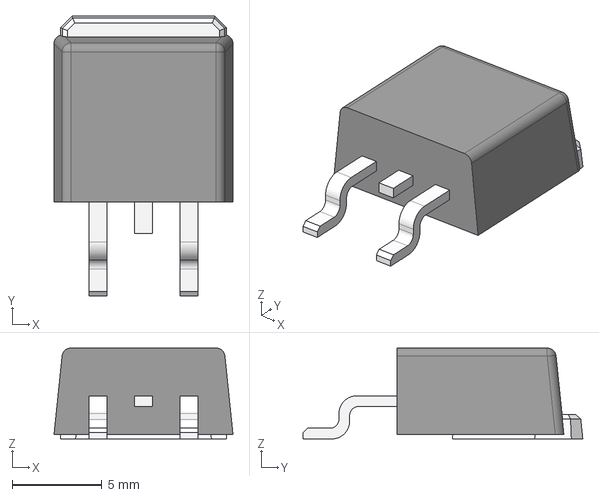
[picture p52: CAD file, 2026-02-21]
gen3/PCBs/Battery_Boards/Power_ManagementV3_diode/3D Models/D2PAK-2 L7805.step
10.0 x 15.6 x 5.08 mm
