ryos17/robosub-ee/gen3/PCBs/Battery_Boards/Power_ManagementV3_eli/3D Models/D2PAK-3.step

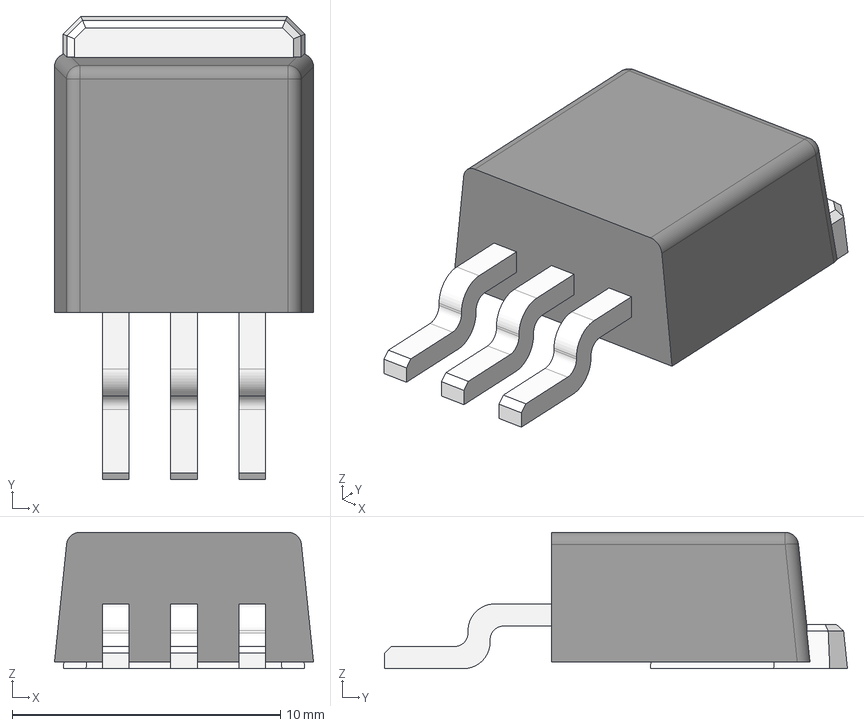
[picture p53: CAD file, 2026-02-21]
gen3/PCBs/Battery_Boards/Power_ManagementV3_eli/3D Models/D2PAK-3.step
9.65 x 17.3 x 5.08 mm
