ryos17/robosub-ee/gen3/PCBs/Battery_Boards/Power_ManagementV3_diode/3D Models/Diode DO-35.step

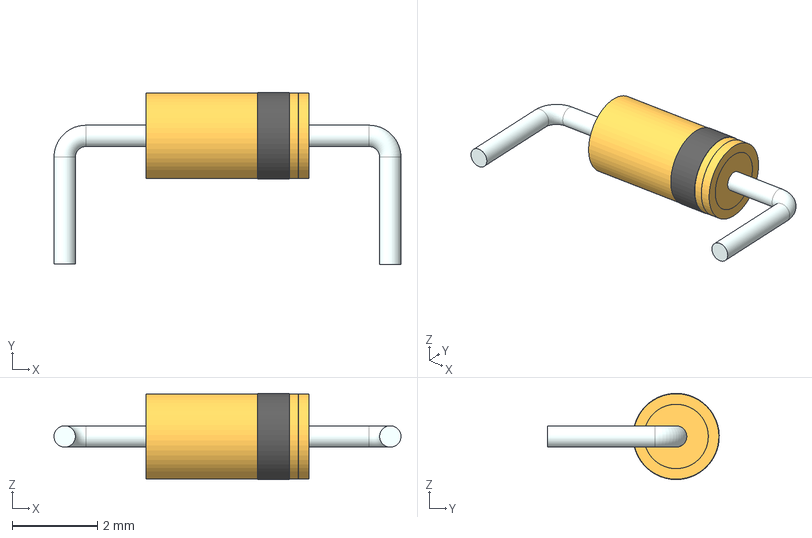
[picture p54: CAD file, 2026-02-21]
gen3/PCBs/Battery_Boards/Power_ManagementV3_diode/3D Models/Diode DO-35.step
8.12 x 4.01 x 2.02 mm
Circle
DWire
