ryos17/robosub-ee/gen3/PCBs/Battery_Boards/Power_ManagementV3_eli/3D Models/YC248-JR-07100RL.stp

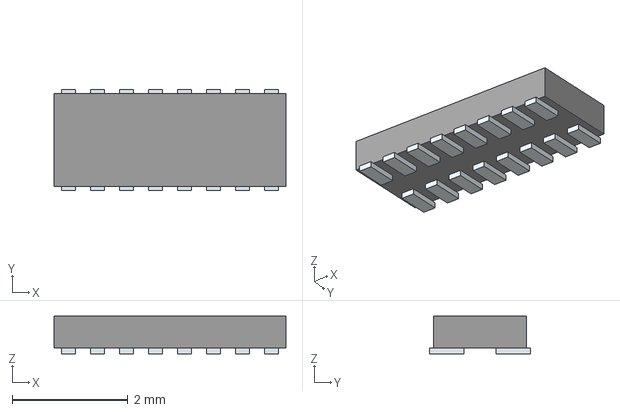
[picture p55: CAD file, 2026-02-21]
gen3/PCBs/Battery_Boards/Power_ManagementV3_eli/3D Models/YC248-JR-07100RL.stp
4.00 x 1.74 x 0.65 mm
Pins
