ryos17/robosub-ee/(list of files, cad)

Other CAD files:
gen3/PCBs/Power_Distribution/3D Models/XT60 MALE.STEP
gen3/PCBs/Battery_Boards/Power_ManagementV3_diode/3D Models/XT60PW MALE.STEP
gen3/PCBs/Battery_Boards/Power_ManagementV3_diode/3D Models/XT60 FEMALE.STEP
gen3/PCBs/Battery_Boards/Power_ManagementV3_eli/3D Models/XT60 FEMALE.STEP
gen3/PCBs/Battery_Boards/Power_ManagementV3_eli/3D Models/XT60PW MALE.STEP
gen1/PCBs/Power_Distribution_Board/EDA/1135333/1135333.step
gen1/PCBs/Power_Distribution_Board/EDA/AUIR3241STR/AUIR3241STR.step
gen1/PCBs/Power_Distribution_Board/EDA/INA300AIDSQT/INA300AIDSQT.step
gen1/PCBs/Power_Distribution_Board/EDA/SN74LVC1G97DBVR/SN74LVC1G97DBVR.step
gen1/PCBs/Power_Distribution_Board/EDA/UMPS_10_05_5_L_V_S_W_TR/UMPS-10-05.5-L-V-S-W-TR.step
gen2/PCBs/Battery_hot_swap/3D_Models/PRT-10474--3DModel-STEP-56544.STEP
gen2/PCBs/Battery_hot_swap/3D_Models/SB5100-T.step
gen2/PCBs/Power_Management/3D Models/ACS758ECB-200B-PFF-T.stp
gen2/PCBs/Power_Management/3D Models/CAP_UCB_4X7_NCH.step
gen2/PCBs/Power_Management/3D Models/G5V_1.step
gen2/PCBs/Power_Management/3D Models/MCTL160N15Y-TP.stp
gen2/PCBs/Power_Management/V1/Gen2_V1_Power_Management.step
gen3/PCBs/Battery_Boards/Power_ManagementV3_diode/3D Models/1017503.step
gen3/PCBs/Battery_Boards/Power_ManagementV3_diode/3D Models/1986660.step
gen3/PCBs/Battery_Boards/Power_ManagementV3_diode/3D Models/430450201.stp
gen3/PCBs/Battery_Boards/Power_ManagementV3_diode/3D Models/430450228.stp
gen3/PCBs/Battery_Boards/Power_ManagementV3_diode/3D Models/430450422.stp
gen3/PCBs/Battery_Boards/Power_ManagementV3_diode/3D Models/430450426.stp
gen3/PCBs/Battery_Boards/Power_ManagementV3_diode/3D Models/430450821.stp
gen3/PCBs/Battery_Boards/Power_ManagementV3_diode/3D Models/430451027.stp
gen3/PCBs/Battery_Boards/Power_ManagementV3_diode/3D Models/Diode DO-35.FCStd
gen3/PCBs/Battery_Boards/Power_ManagementV3_diode/3D Models/Diode DO-35.stl
gen3/PCBs/Battery_Boards/Power_ManagementV3_diode/3D Models/LMV982MM_NOPB.stp
gen3/PCBs/Battery_Boards/Power_ManagementV3_diode/3D Models/MCP23008-E_P.step
gen3/PCBs/Battery_Boards/Power_ManagementV3_diode/3D Models/SOS-ASM-LEAK-SENSOR-R1.STL
gen3/PCBs/Battery_Boards/Power_ManagementV3_eli/3D Models/1017503.step
gen3/PCBs/Battery_Boards/Power_ManagementV3_eli/3D Models/1986660.step
gen3/PCBs/Battery_Boards/Power_ManagementV3_eli/3D Models/430450201.stp
gen3/PCBs/Battery_Boards/Power_ManagementV3_eli/3D Models/430450228.stp
gen3/PCBs/Battery_Boards/Power_ManagementV3_eli/3D Models/430450422.stp
gen3/PCBs/Battery_Boards/Power_ManagementV3_eli/3D Models/430450426.stp
gen3/PCBs/Battery_Boards/Power_ManagementV3_eli/3D Models/430450821.stp
gen3/PCBs/Battery_Boards/Power_ManagementV3_eli/3D Models/430451027.stp
gen3/PCBs/Battery_Boards/Power_ManagementV3_eli/3D Models/Diode DO-35.FCStd
gen3/PCBs/Battery_Boards/Power_ManagementV3_eli/3D Models/Diode DO-35.stl
gen3/PCBs/Battery_Boards/Power_ManagementV3_eli/3D Models/LMV982MM_NOPB.stp
gen3/PCBs/Battery_Boards/Power_ManagementV3_eli/3D Models/MCP23008-E_P.step
gen3/PCBs/Battery_Boards/Power_ManagementV3_eli/3D Models/SOS-ASM-LEAK-SENSOR-R1.STL
imported_parts/robosub_3d_models/430450212.stp
imported_parts/robosub_3d_models/430450412.stp
imported_parts/robosub_3d_models/430450612.stp
imported_parts/robosub_3d_models/MS560702BA03-50.step
