ryos17/robosub-ee/misc/MBARI/Test_Data/pre_water_test1.txt

1472,22.75,21.94,21.94
1541,22.75,21.94,21.94
1592,22.75,21.94,21.94
1642,22.75,21.94,21.94
1693,22.75,21.94,21.94
1743,22.75,21.94,21.94
1794,22.75,21.94,21.94
1844,22.75,21.94,21.94
1895,22.75,21.94,21.94
1945,22.75,21.94,21.94
1996,22.75,21.94,21.94
2046,22.75,21.94,21.94
2097,22.75,21.94,21.94
2147,22.75,21.94,21.94
2198,22.75,22.00,21.94
2248,22.75,22.00,21.94
2299,22.75,22.00,21.94
2349,22.75,22.00,21.94
2400,22.75,22.00,21.94
2450,22.81,21.94,21.94
2500,22.81,21.94,21.94
2551,22.81,21.94,21.94
2601,22.81,21.94,21.94
2652,22.81,21.94,21.94
2701,22.75,22.00,21.94
2752,22.75,22.00,21.94
2807,22.75,22.00,21.94
2858,22.75,22.00,21.94
2908,22.75,22.00,21.94
2958,22.75,21.94,21.94
3008,22.75,21.94,21.94
3058,22.75,21.94,21.94
3108,22.75,21.94,21.94
3159,22.75,21.94,21.94
3209,22.75,21.94,21.94
3259,22.75,21.94,21.94
3309,22.75,21.94,21.94
3359,22.75,21.94,21.94
3410,22.81,21.94,21.94
3460,22.81,22.00,21.94
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
