ryos17/robosub-ee/misc/MBARI/Test_Data/testing.txt

2515,25.31,24.94,25.12
2584,25.31,24.94,25.12
2634,25.31,24.94,25.12
2687,25.31,24.94,25.12
2737,25.31,24.94,25.12
2788,25.31,24.94,25.12
2838,25.31,24.94,25.12
2890,25.31,24.94,25.12
2941,25.31,24.94,25.12
2991,25.31,24.94,25.12
3042,25.31,24.88,25.12
3093,25.31,24.88,25.12
3143,25.31,24.88,25.12
3194,25.31,24.88,25.12
3245,25.31,24.88,25.12
3295,25.25,24.88,25.12
3346,25.25,24.88,25.12
3396,25.25,24.88,25.12
3447,25.25,24.88,25.12
3498,25.25,24.88,25.12
3548,25.31,24.94,25.12
3599,25.31,24.94,25.12
3649,25.31,24.94,25.19
3700,25.31,24.94,25.19
3750,25.31,24.94,25.19
3800,25.31,24.94,25.19
3851,25.31,24.94,25.19
3906,25.31,24.94,25.12
3957,25.31,24.94,25.12
4008,25.25,24.94,25.12
4058,25.25,24.88,25.12
4108,25.25,24.88,25.12
4159,25.25,24.88,25.12
4209,25.25,24.88,25.12
4260,25.25,24.88,25.12
4310,25.25,24.88,25.12
4360,25.25,24.88,25.12
4410,25.25,24.88,25.12
4461,25.25,24.88,25.12
4511,25.31,24.88,25.12
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
