ryos17/robosub-ee/gen1/PCBs/Power_Distribution_Board/Robosub_Power.kicad_pcb

## KiCad design gen1/PCBs/Power_Distribution_Board/Robosub_Power.kicad_pcb (2026-02-21, an earlier design)

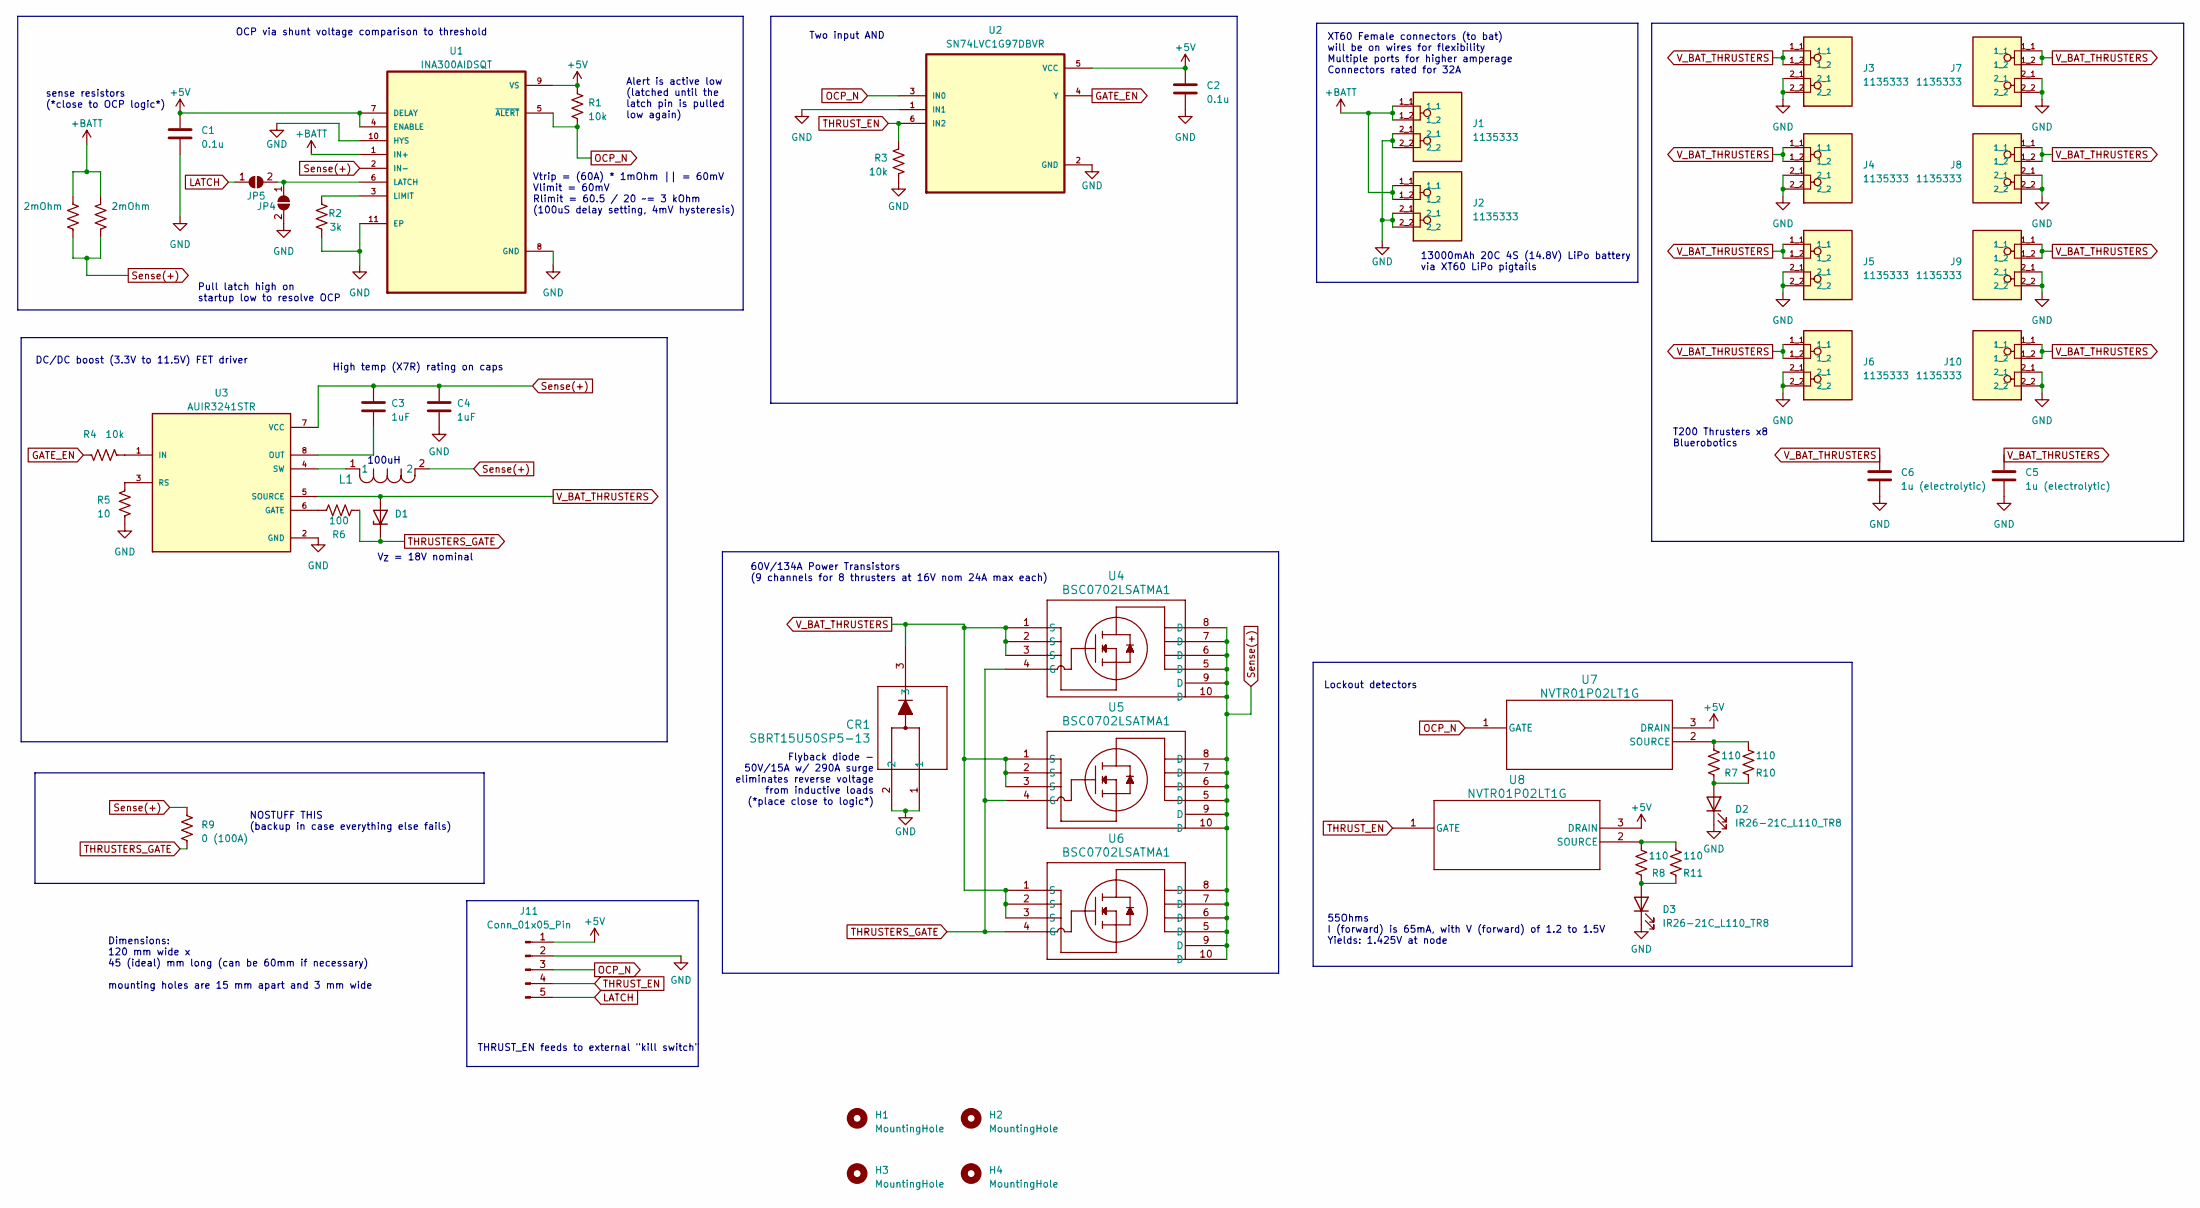
[picture p56: schematic Robosub_Power.kicad_sch, Main]

Parts:
C1, C2: 0.1u; C_0805_2012Metric_Pad1.18x1.45mm_HandSolder
C3, C4: 1uF; C_1812_4532Metric_Pad1.57x3.40mm_HandSolder
C5, C6: 1u (electrolytic); UCB1V0R1MCL1GS
CR1: SBRT15U50SP5-13; POWERDI5_DIO
D1: 1SMA5931BT3; D_SMA
D2, D3: IR26-21C_L110_TR8; LED_1206_3216Metric
H1, H2, H3, H4: MountingHole; MountingHole_3.2mm_M3
J1, J2, J3, J4, J5, J6, J7, J8, J9, J10: 1135333; PHOENIX_1135333
J11: Conn_01x05_Pin; PinHeader_1x05_P2.54mm_Vertical
JP4, JP5: SolderJumper_2_Open; SolderJumper-2_P1.3mm_Open_Pad1.0x1.5mm
L1: 74477420; IND_5848-WE-PD2_WRE
R1, R3, R4: 10k; R_0805_2012Metric_Pad1.20x1.40mm_HandSolder
R2: 3k; R_0805_2012Metric_Pad1.20x1.40mm_HandSolder
R5: 10; R_0805_2012Metric_Pad1.20x1.40mm_HandSolder
R6: 100; R_0805_2012Metric_Pad1.20x1.40mm_HandSolder
R7, R8, R10, R11: 110; R_0805_2012Metric_Pad1.20x1.40mm_HandSolder
R9: 0 (100A); R_2512_6332Metric_Pad1.40x3.35mm_HandSolder
U1: INA300AIDSQT; SON40P200X200X80-11N
U2: SN74LVC1G97DBVR; SOT95P280X145-6N
U3: AUIR3241STR; SOIC127P600X175-8N_AUIR3241STR
U4, U5, U6: BSC0702LSATMA1
U7, U8: NVTR01P02LT1G; SOT-23-3_1P4X3P040_ONS
WSLP59312L000FEA_1, WSLP59312L000FEA_2: 2mOhm; RES_WSLP5931_.002OHM_VIS

Connections:
+5V: C1.1, C2.1, J11.1, R1.1, U1.4 (ENABLE), U1.7 (DELAY), U1.9 (VS), U2.5 (VCC), U7.3 (DRAIN), U8.3 (DRAIN)
+BATT: J1.1_1, J1.1_2, J2.1_1, J2.1_2, U1.1 (IN+), WSLP59312L000FEA_1.2, WSLP59312L000FEA_2.2
GATE_EN: R4.1, U2.4 (Y)
GND: C1.2, C2.2, C4.2, C5.2, C6.2, CR1.1, CR1.2, D2.1 (K), D3.1 (K), J1.2_1, J1.2_2, J2.2_1, J2.2_2, J3.2_1, J3.2_2, J4.2_1, J4.2_2, J5.2_1, J5.2_2, J6.2_1, J6.2_2, J7.2_1, J7.2_2, J8.2_1, J8.2_2, J9.2_1, J9.2_2, J10.2_1, J10.2_2, J11.2, JP4.2 (B), R2.2, R3.2, R5.2, U1.8 (GND), U1.10 (HYS), U1.11 (EP), U2.1 (IN1), U2.2 (GND), U3.2 (GND)
LATCH: J11.5, JP5.1 (A)
unnamed: D2.2 (A), R7.1, R10.1
unnamed: D3.2 (A), R8.1, R11.1
unnamed: JP4.1 (A), JP5.2 (B), U1.6 (LATCH)
unnamed: R2.1, U1.3 (LIMIT)
unnamed: R6.1, U3.6 (GATE)
unnamed: R4.2, U3.1 (IN)
unnamed: C3.2, U3.8 (OUT)
unnamed: R5.1, U3.3 (RS)
unnamed: L1.1, U3.4 (SW)
unnamed: R7.2, R10.2, U7.2 (SOURCE)
unnamed: R8.2, R11.2, U8.2 (SOURCE)
OCP_N: J11.3, R1.2, U1.5 (~ALERT), U2.3 (IN0), U7.1 (GATE)
Sense(+): C3.1, C4.1, L1.2, R9.1, U1.2 (IN-), U3.7 (VCC), U4.5 (D), U4.6 (D), U4.7 (D), U4.8 (D), U4.9 (D), U4.10 (D), U5.5 (D), U5.6 (D), U5.7 (D), U5.8 (D), U5.9 (D), U5.10 (D), U6.5 (D), U6.6 (D), U6.7 (D), U6.8 (D), U6.9 (D), U6.10 (D), WSLP59312L000FEA_1.1, WSLP59312L000FEA_2.1
THRUSTERS_GATE: D1.1 (K), R6.2, R9.2, U4.4 (G), U5.4 (G), U6.4 (G)
THRUST_EN: J11.4, R3.1, U2.6 (IN2), U8.1 (GATE)
V_BAT_THRUSTERS: C5.1, C6.1, CR1.3, D1.2 (A), J3.1_1, J3.1_2, J4.1_1, J4.1_2, J5.1_1, J5.1_2, J6.1_1, J6.1_2, J7.1_1, J7.1_2, J8.1_1, J8.1_2, J9.1_1, J9.1_2, J10.1_1, J10.1_2, U3.5 (SOURCE), U4.1 (S), U4.2 (S), U4.3 (S), U5.1 (S), U5.2 (S), U5.3 (S), U6.1 (S), U6.2 (S), U6.3 (S)

Notes on the sheet:
THRUST_EN feeds to external "kill switch"
Two input AND
Lockout detectors
Dimensions: 120 mm wide x 45 (ideal) mm long (can be 60mm if necessary) mounting holes are 15 mm apart and 3 mm wide
High temp (X7R) rating on caps
13000mAh 20C 4S (14.8V) LiPo battery via XT60 LiPo pigtails
Vtrip = (60A) * 1mOhm || = 60mV Vlimit = 60mV Rlimit = 60.5 / 20 ~= 3 kOhm (100uS delay setting, 4mV hysteresis)
Alert is active low (latched until the latch pin is pulled low again)
DC/DC boost (3.3V to 11.5V) FET driver
55Ohms I (forward) is 65mA, with V (forward) of 1.2 to 1.5V Yields: 1.425V at node
XT60 Female connectors (to bat) will be on wires for flexibility Multiple ports for higher amperage Connectors rated for 32A
Flyback diode - 50V/15A w/ 290A surge eliminates reverse voltage from inductive loads (*place close to logic*)
60V/134A Power Transistors (9 channels for 8 thrusters at 16V nom 24A max each)
V_{Z} = 18V nominal
100uH
NOSTUFF THIS (backup in case everything else fails)
T200 Thrusters x8 Bluerobotics
OCP via shunt voltage comparison to threshold
Pull latch high on startup low to resolve OCP
sense resistors (*close to OCP logic*)

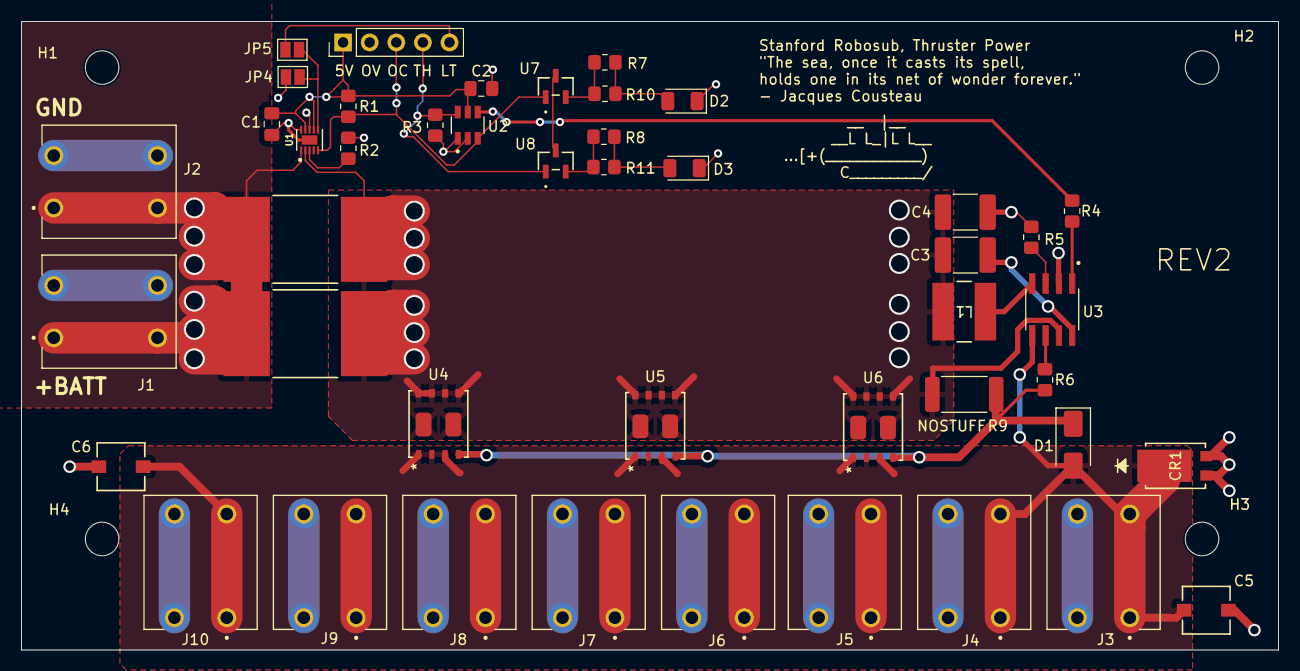
[picture p57: board Robosub_Power.kicad_pcb from above]

Board: 2 copper layers, 120.0 x 60.0 mm, 49 parts (0 on the bottom side), 21 nets.
