ryos17/robosub-ee/gen1/PCBs/Teensy_Board/robosub_teensy.kicad_pcb

## KiCad design gen1/PCBs/Teensy_Board/robosub_teensy.kicad_pcb (2026-02-21, an earlier design)

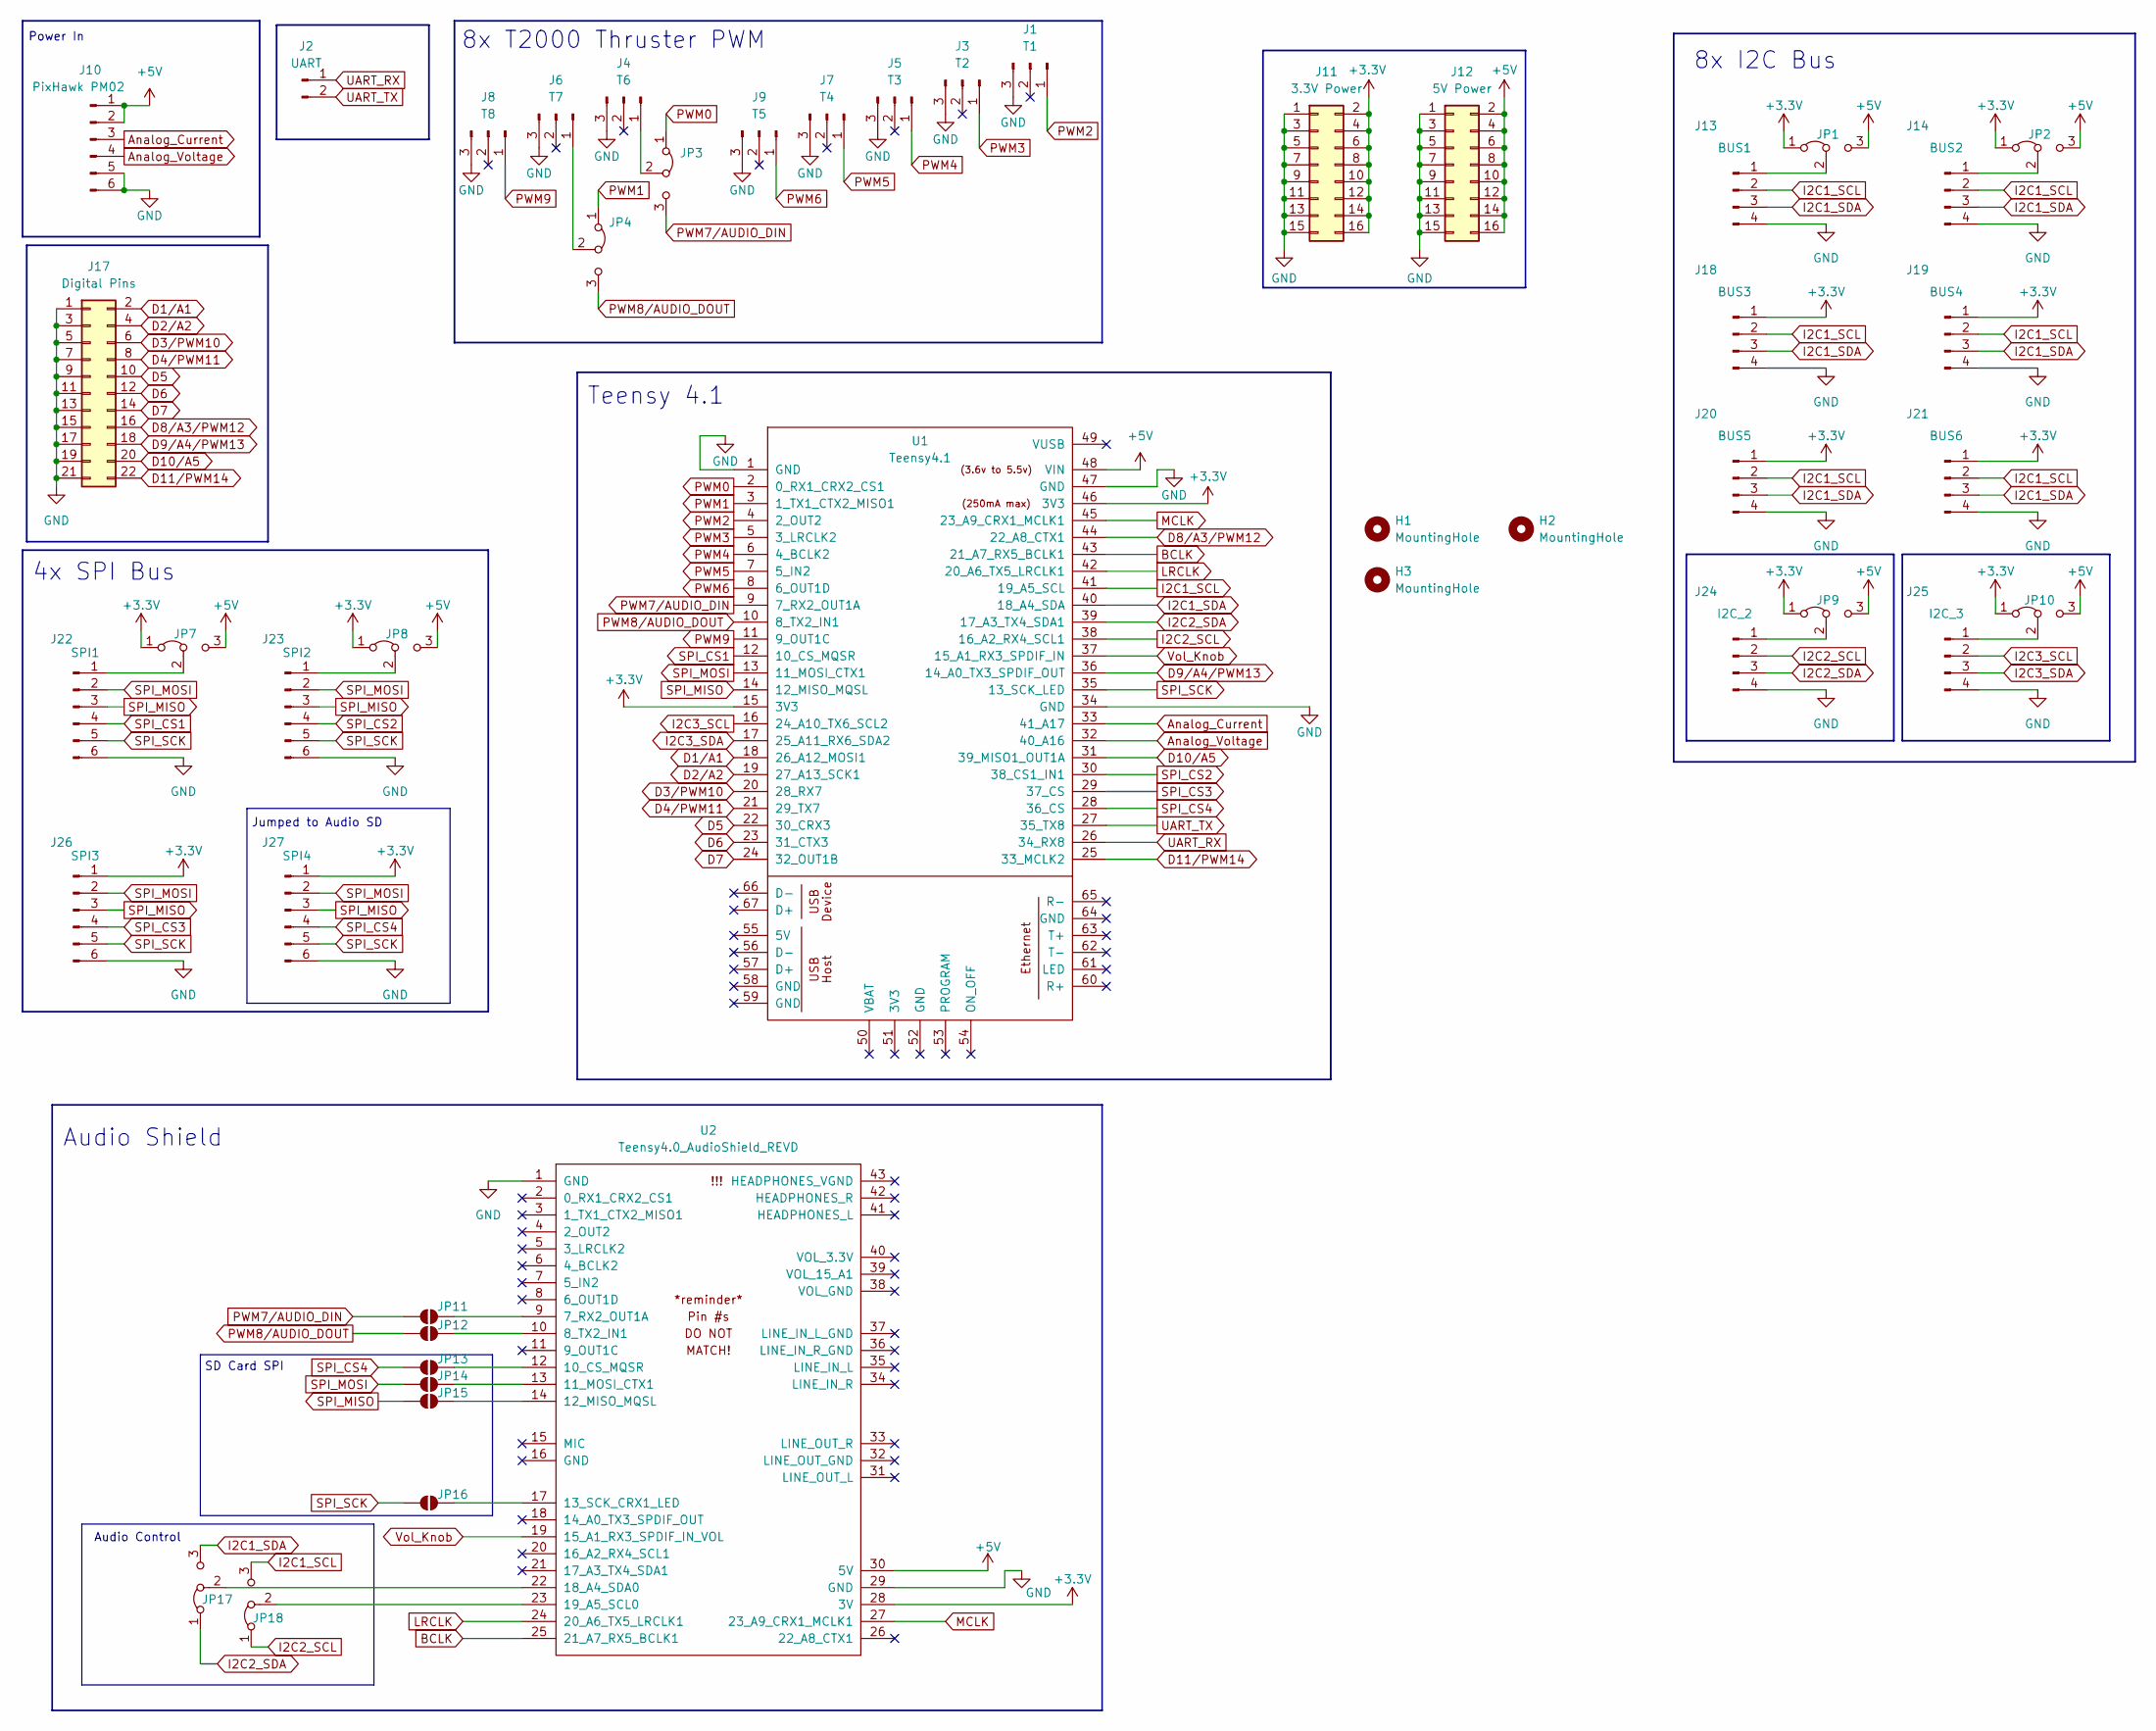
[picture p58: schematic robosub_teensy.kicad_sch, Teensy Adapter Board]

Parts:
H1, H2, H3: MountingHole; MountingHole_3.2mm_M3
J1: T1; PinSocket_1x03_P2.54mm_Vertical
J2: UART; PinSocket_1x02_P2.54mm_Vertical
J3: T2; PinSocket_1x03_P2.54mm_Vertical
J4: T6; PinSocket_1x03_P2.54mm_Vertical
J5: T3; PinSocket_1x03_P2.54mm_Vertical
J6: T7; PinSocket_1x03_P2.54mm_Vertical
J7: T4; PinSocket_1x03_P2.54mm_Vertical
J8: T8; PinSocket_1x03_P2.54mm_Vertical
J9: T5; PinSocket_1x03_P2.54mm_Vertical
J10: PixHawk PM02; PinSocket_1x06_P2.54mm_Vertical
J11: 3.3V Power; PinSocket_2x08_P2.54mm_Vertical
J12: 5V Power; PinSocket_2x08_P2.54mm_Vertical
J13: BUS1; PinSocket_1x04_P2.54mm_Vertical
J14: BUS2; PinSocket_1x04_P2.54mm_Vertical
J17: Digital Pins; PinSocket_2x11_P2.54mm_Vertical
J18: BUS3; PinSocket_1x04_P2.54mm_Vertical
J19: BUS4; PinSocket_1x04_P2.54mm_Vertical
J20: BUS5; PinSocket_1x04_P2.54mm_Vertical
J21: BUS6; PinSocket_1x04_P2.54mm_Vertical
J22: SPI1; PinSocket_1x06_P2.54mm_Vertical
J23: SPI2; PinSocket_1x06_P2.54mm_Vertical
J24: I2C_2; PinSocket_1x04_P2.54mm_Vertical
J25: I2C_3; PinSocket_1x04_P2.54mm_Vertical
J26: SPI3; PinSocket_1x06_P2.54mm_Vertical
J27: SPI4; PinSocket_1x06_P2.54mm_Vertical
JP1: BUS1_PWR; PinSocket_1x03_P2.54mm_Vertical
JP2: BUS2_PWR; PinSocket_1x03_P2.54mm_Vertical
JP3: T6_Sel; PinSocket_1x03_P2.54mm_Vertical
JP4: T7_Sel; PinSocket_1x03_P2.54mm_Vertical
JP7: SPI1_PWR; PinSocket_1x03_P2.54mm_Vertical
JP8: SPI2_PWR; PinSocket_1x03_P2.54mm_Vertical
JP9: I2C2_PWR; PinSocket_1x03_P2.54mm_Vertical
JP10: I2C3_PWR; PinSocket_1x03_P2.54mm_Vertical
JP11: AUDIO_DIN; SolderJumper-2_P1.3mm_Open_Pad1.0x1.5mm
JP12: AUDIO_DOUT; SolderJumper-2_P1.3mm_Open_Pad1.0x1.5mm
JP13: AUDIO_CS; SolderJumper-2_P1.3mm_Open_Pad1.0x1.5mm
JP14: AUDIO_MOSI; SolderJumper-2_P1.3mm_Open_Pad1.0x1.5mm
JP15: AUDIO_MISO; SolderJumper-2_P1.3mm_Open_Pad1.0x1.5mm
JP16: AUDIO_SCK; SolderJumper-2_P1.3mm_Open_Pad1.0x1.5mm
JP17: SDA_Sel; PinSocket_1x03_P2.54mm_Vertical
JP18: SCL_Sel; PinSocket_1x03_P2.54mm_Vertical
U1: Teensy4.1; Teensy41
U2: Teensy4.0_AudioShield_REVD; 4.0audioshield

Connections:
+3.3V: J11.2, J11.4, J11.6, J11.8, J11.10, J11.12, J11.14, J11.16, J18.1, J19.1, J20.1, J21.1, J26.1, J27.1, JP1.1 (A), JP2.1 (A), JP7.1 (A), JP8.1 (A), JP9.1 (A), JP10.1 (A), U1.15 (3V3), U1.46 (3V3), U2.28 (3V)
+5V: J10.1, J10.2, J12.2, J12.4, J12.6, J12.8, J12.10, J12.12, J12.14, J12.16, JP1.3 (B), JP2.3 (B), JP7.3 (B), JP8.3 (B), JP9.3 (B), JP10.3 (B), U1.48 (VIN), U2.30 (5V)
Analog_Current: J10.3, U1.33 (41_A17)
Analog_Voltage: J10.4, U1.32 (40_A16)
BCLK: U1.43 (21_A7_RX5_BCLK1), U2.25 (21_A7_RX5_BCLK1)
D1/A1: J17.2, U1.18 (26_A12_MOSI1)
D2/A2: J17.4, U1.19 (27_A13_SCK1)
D3/PWM10: J17.6, U1.20 (28_RX7)
D4/PWM11: J17.8, U1.21 (29_TX7)
D5: J17.10, U1.22 (30_CRX3)
D6: J17.12, U1.23 (31_CTX3)
D7: J17.14, U1.24 (32_OUT1B)
D8/A3/PWM12: J17.16, U1.44 (22_A8_CTX1)
D9/A4/PWM13: J17.18, U1.36 (14_A0_TX3_SPDIF_OUT)
D10/A5: J17.20, U1.31 (39_MISO1_OUT1A)
D11/PWM14: J17.22, U1.25 (33_MCLK2)
GND: J1.3, J3.3, J4.3, J5.3, J6.3, J7.3, J8.3, J9.3, J10.5, J10.6, J11.1, J11.3, J11.5, J11.7, J11.9, J11.11, J11.13, J11.15, J12.1, J12.3, J12.5, J12.7, J12.9, J12.11, J12.13, J12.15, J13.4, J14.4, J17.1, J17.3, J17.5, J17.7, J17.9, J17.11, J17.13, J17.15, J17.17, J17.19, J17.21, J18.4, J19.4, J20.4, J21.4, J22.6, J23.6, J24.4, J25.4, J26.6, J27.6, U1.1 (GND), U1.34 (GND), U1.47 (GND), U2.1 (GND), U2.29 (GND)
I2C1_SCL: J13.2, J14.2, J18.2, J19.2, J20.2, J21.2, JP18.3 (B), U1.41 (19_A5_SCL)
I2C1_SDA: J13.3, J14.3, J18.3, J19.3, J20.3, J21.3, JP17.3 (B), U1.40 (18_A4_SDA)
I2C2_SCL: J24.2, JP18.1 (A), U1.38 (16_A2_RX4_SCL1)
I2C2_SDA: J24.3, JP17.1 (A), U1.39 (17_A3_TX4_SDA1)
I2C3_SCL: J25.2, U1.16 (24_A10_TX6_SCL2)
I2C3_SDA: J25.3, U1.17 (25_A11_RX6_SDA2)
LRCLK: U1.42 (20_A6_TX5_LRCLK1), U2.24 (20_A6_TX5_LRCLK1)
MCLK: U1.45 (23_A9_CRX1_MCLK1), U2.27 (23_A9_CRX1_MCLK1)
unnamed: J4.1, JP3.2 (C)
unnamed: J6.1, JP4.2 (C)
unnamed: J13.1, JP1.2 (C)
unnamed: J14.1, JP2.2 (C)
unnamed: J22.1, JP7.2 (C)
unnamed: J23.1, JP8.2 (C)
unnamed: J24.1, JP9.2 (C)
unnamed: J25.1, JP10.2 (C)
unnamed: JP11.2 (B), U2.9 (7_RX2_OUT1A)
unnamed: JP12.2 (B), U2.10 (8_TX2_IN1)
unnamed: JP13.2 (B), U2.12 (10_CS_MQSR)
unnamed: JP14.2 (B), U2.13 (11_MOSI_CTX1)
unnamed: JP15.2 (B), U2.14 (12_MISO_MQSL)
unnamed: JP16.2 (B), U2.17 (13_SCK_CRX1_LED)
unnamed: JP17.2 (C), U2.22 (18_A4_SDA0)
unnamed: JP18.2 (C), U2.23 (19_A5_SCL0)
PWM0: JP3.1 (A), U1.2 (0_RX1_CRX2_CS1)
PWM1: JP4.1 (A), U1.3 (1_TX1_CTX2_MISO1)
PWM2: J1.1, U1.4 (2_OUT2)
PWM3: J3.1, U1.5 (3_LRCLK2)
PWM4: J5.1, U1.6 (4_BCLK2)
PWM5: J7.1, U1.7 (5_IN2)
PWM6: J9.1, U1.8 (6_OUT1D)
PWM7/AUDIO_DIN: JP3.3 (B), JP11.1 (A), U1.9 (7_RX2_OUT1A)
PWM8/AUDIO_DOUT: JP4.3 (B), JP12.1 (A), U1.10 (8_TX2_IN1)
PWM9: J8.1, U1.11 (9_OUT1C)
SPI_CS1: J22.4, U1.12 (10_CS_MQSR)
SPI_CS2: J23.4, U1.30 (38_CS1_IN1)
SPI_CS3: J26.4, U1.29 (37_CS)
SPI_CS4: J27.4, JP13.1 (A), U1.28 (36_CS)
SPI_MISO: J22.3, J23.3, J26.3, J27.3, JP15.1 (A), U1.14 (12_MISO_MQSL)
SPI_MOSI: J22.2, J23.2, J26.2, J27.2, JP14.1 (A), U1.13 (11_MOSI_CTX1)
SPI_SCK: J22.5, J23.5, J26.5, J27.5, JP16.1 (A), U1.35 (13_SCK_LED)
UART_RX: J2.1, U1.26 (34_RX8)
UART_TX: J2.2, U1.27 (35_TX8)
Vol_Knob: U1.37 (15_A1_RX3_SPDIF_IN), U2.19 (15_A1_RX3_SPDIF_IN_VOL)

Notes on the sheet:
8x T2000 Thruster PWM
4x SPI Bus
Teensy 4.1
Audio Control
SD Card SPI
Power In
Audio Shield
Jumped to Audio SD
8x I2C Bus

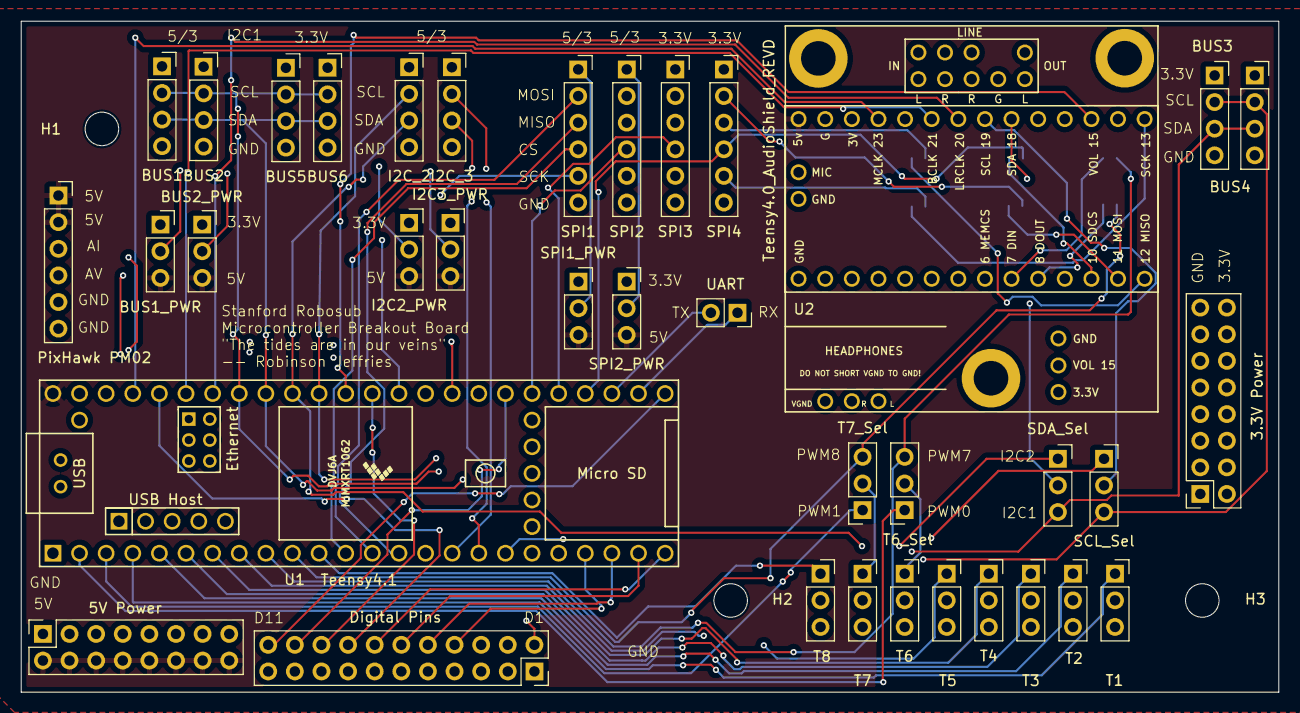
[picture p59: board robosub_teensy.kicad_pcb from above]

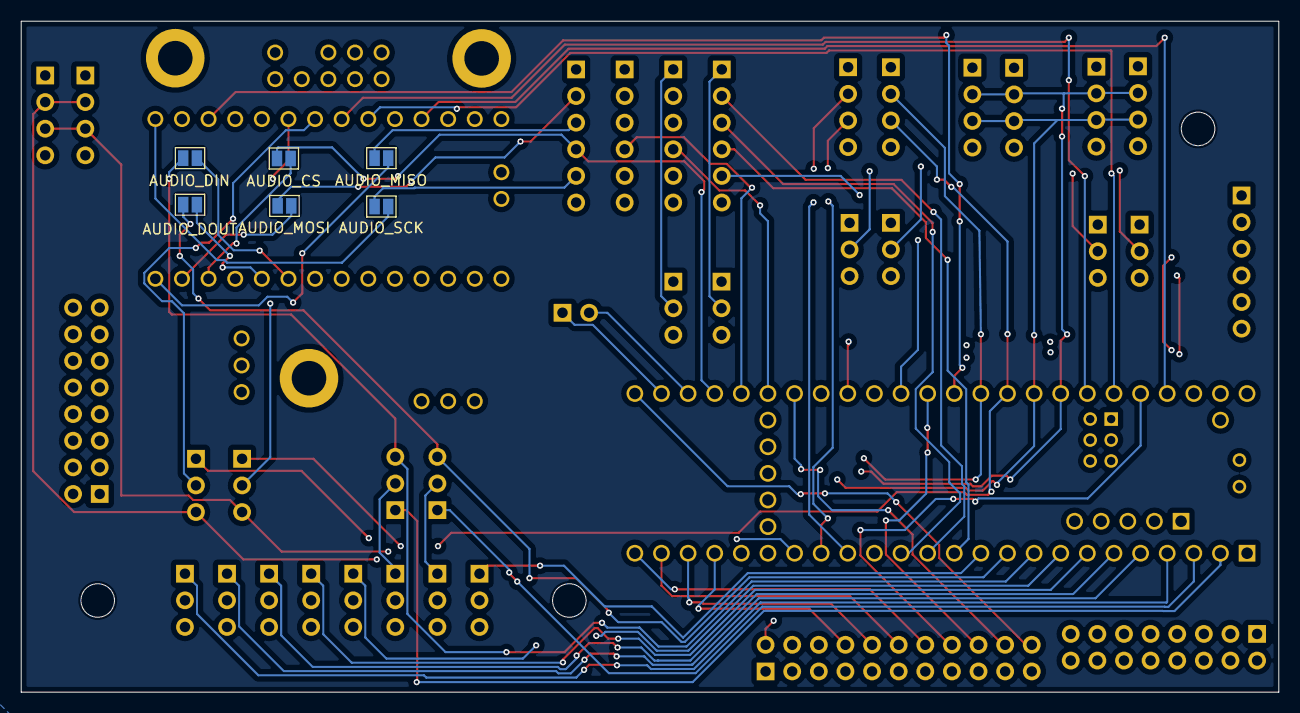
[picture p60: board robosub_teensy.kicad_pcb from below]

Board: 4 copper layers, 120.0 x 64.0 mm, 46 parts (6 on the bottom side), 61 nets.
