ryos17/robosub-ee/gen3/PCBs/Power_Distribution/Power_Distribution.kicad_pcb

## KiCad design gen3/PCBs/Power_Distribution/Power_Distribution.kicad_pcb (2026-05-20)

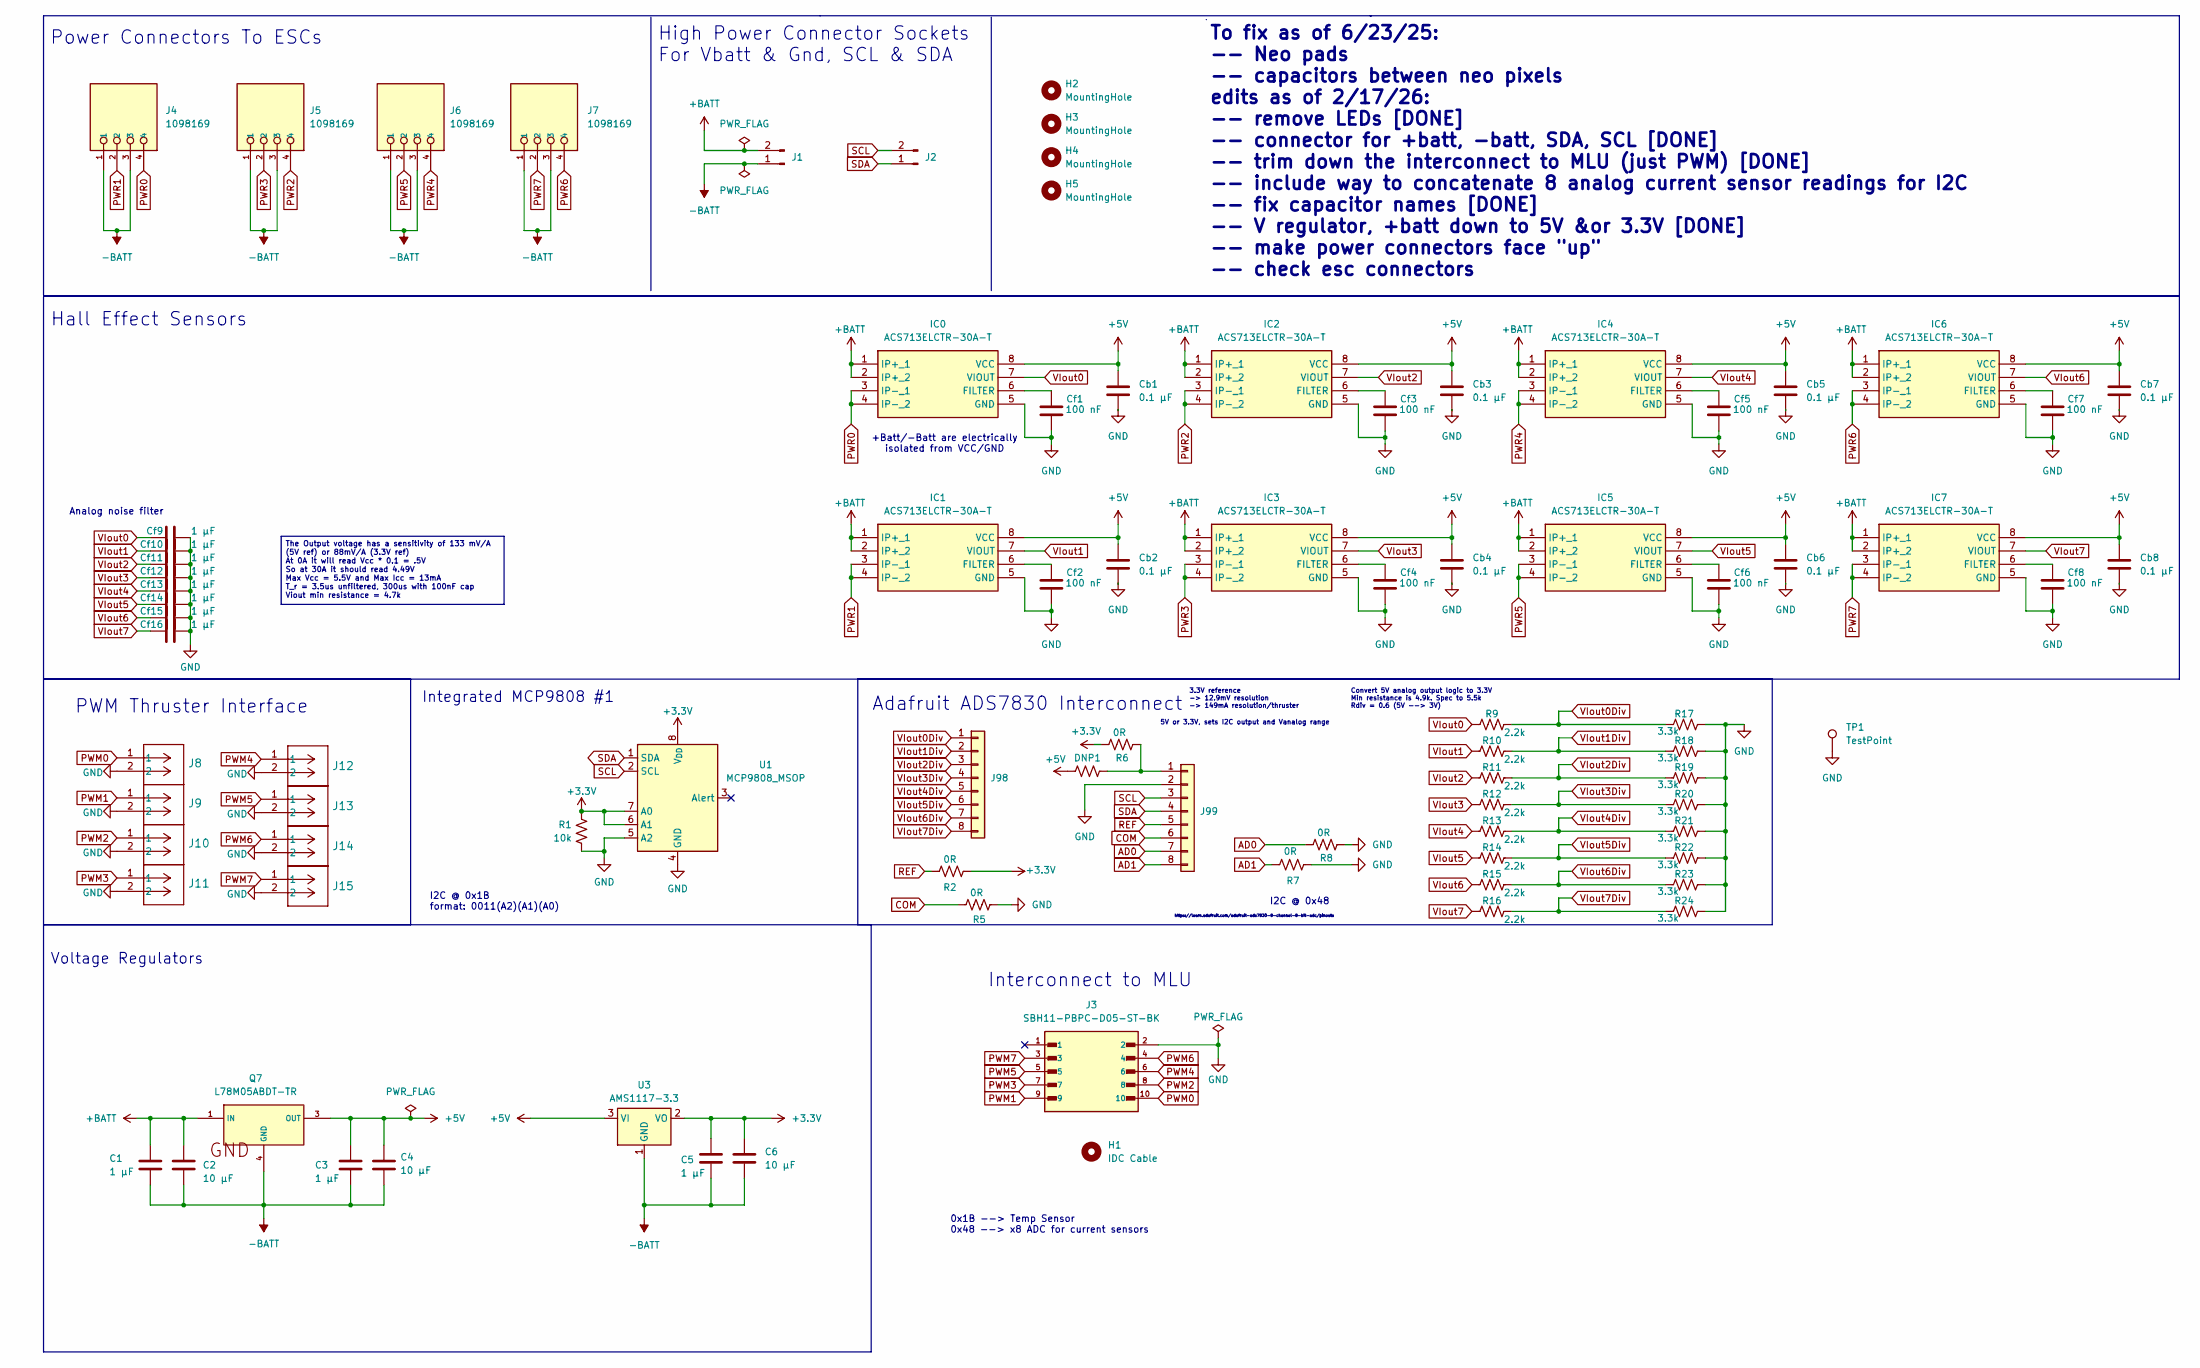
[picture p61: schematic Power_Distribution.kicad_sch, Power distribution board]

Parts:
C1, C3, C5: 1 µF; C_0805_2012Metric
C2, C4, C6: 10 µF; C_0805_2012Metric
Cb1, Cb2, Cb3, Cb4, Cb5, Cb6, Cb7, Cb8: 0.1 µF; C_0805_2012Metric_Pad1.18x1.45mm_HandSolder
Cf1, Cf2, Cf3, Cf4, Cf5, Cf6, Cf7, Cf8: 100 nF; C_0805_2012Metric_Pad1.18x1.45mm_HandSolder
Cf9, Cf10, Cf11, Cf12, Cf13, Cf14, Cf15, Cf16: 1 µF; C_0805_2012Metric_Pad1.18x1.45mm_HandSolder
DNP1: 0; R_0805_2012Metric
H1: IDC Cable
H2, H3, H4, H5: MountingHole; MountingHole_4.3mm_M4
IC0, IC1, IC2, IC3, IC4, IC5, IC6, IC7: ACS713ELCTR-30A-T; ACS711ELCTR25ABT; Manufacturer_Part_Number ACS713ELCTR-30A-T
J1: Conn_01x02_Pin; AMASS_XT60IPW-M_1x03_P7.20mm_Horizontal
J2: Conn_01x02_Pin; AMASS_XT30PW-F_1x02_P2.50mm_Horizontal
J3: SBH11-PBPC-D05-ST-BK; SULLINS_SBH11-PBPC-D05-ST-BK; PARTREV J
J4, J5, J6, J7: 1098169; PHOENIX_1098169
J8, J9, J10, J11, J12, J13, J14, J15: 430450212; Molex_Micro-Fit_3.0_43045-0212_2x01_P3.00mm_Vertical
J98, J99: Conn_01x08; PinHeader_1x08_P2.54mm_Vertical
Q7: L78M05ABDT-TR; TO-252-2_L6.5-W6.1-P4.58-LS10.0-TL; LCSC C58069
R1: 10k; R_0805_2012Metric_Pad1.20x1.40mm_HandSolder
R2, R5, R6, R7, R8: 0R; R_0805_2012Metric_Pad1.20x1.40mm_HandSolder
R9, R10, R11, R12, R13, R14, R15, R16: 2.2k; R_0805_2012Metric
R17, R18, R19, R20, R21, R22, R23, R24: 3.3k; R_0805_2012Metric
TP1: TestPoint; TestPoint_Keystone_5019_Miniature
U1: MCP9808_MSOP; MSOP-8_3x3mm_P0.65mm
U3: AMS1117-3.3; SOT-223-3_TabPin2

Connections:
+3.3V: C5.1, C6.1, R1.1, R2.2, R6.1, U1.6 (A1), U1.7 (A0), U1.8 (V_{DD}), U3.2 (VO)
+5V: C3.1, C4.1, Cb1.1, Cb2.1, Cb3.1, Cb4.1, Cb5.1, Cb6.1, Cb7.1, Cb8.1, DNP1.1, IC0.8 (VCC), IC1.8 (VCC), IC2.8 (VCC), IC3.8 (VCC), IC4.8 (VCC), IC5.8 (VCC), IC6.8 (VCC), IC7.8 (VCC), Q7.3 (OUT), U3.3 (VI)
+BATT: C1.1, C2.1, IC0.1 (IP+_1), IC0.2 (IP+_2), IC1.1 (IP+_1), IC1.2 (IP+_2), IC2.1 (IP+_1), IC2.2 (IP+_2), IC3.1 (IP+_1), IC3.2 (IP+_2), IC4.1 (IP+_1), IC4.2 (IP+_2), IC5.1 (IP+_1), IC5.2 (IP+_2), IC6.1 (IP+_1), IC6.2 (IP+_2), IC7.1 (IP+_1), IC7.2 (IP+_2), J1.2, Q7.1 (IN)
-BATT: C1.2, C2.2, C3.2, C4.2, C5.2, C6.2, J1.1, J4.1, J4.3, J5.1, J5.3, J6.1, J6.3, J7.1, J7.3, Q7.4 (GND), U3.1 (GND)
AD0: J99.7, R8.1
AD1: J99.8, R7.1
COM: J99.6, R5.1
GND: Cb1.2, Cb2.2, Cb3.2, Cb4.2, Cb5.2, Cb6.2, Cb7.2, Cb8.2, Cf1.2, Cf2.2, Cf3.2, Cf4.2, Cf5.2, Cf6.2, Cf7.2, Cf8.2, Cf9.2, Cf10.2, Cf11.2, Cf12.2, Cf13.2, Cf14.2, Cf15.2, Cf16.2, IC0.5 (GND), IC1.5 (GND), IC2.5 (GND), IC3.5 (GND), IC4.5 (GND), IC5.5 (GND), IC6.5 (GND), IC7.5 (GND), J3.2, J8.2, J9.2, J10.2, J11.2, J12.2, J13.2, J14.2, J15.2, J99.2, R1.2, R5.2, R7.2, R8.2, R17.2, R18.2, R19.2, R20.2, R21.2, R22.2, R23.2, R24.2, TP1.1, U1.4 (GND), U1.5 (A2)
unnamed: Cf1.1, IC0.6 (FILTER)
unnamed: Cf2.1, IC1.6 (FILTER)
unnamed: Cf3.1, IC2.6 (FILTER)
unnamed: Cf4.1, IC3.6 (FILTER)
unnamed: Cf5.1, IC4.6 (FILTER)
unnamed: Cf6.1, IC5.6 (FILTER)
unnamed: Cf7.1, IC6.6 (FILTER)
unnamed: Cf8.1, IC7.6 (FILTER)
unnamed: DNP1.2, J99.1, R6.2
PWM0: J3.10, J8.1
PWM1: J3.9, J9.1
PWM2: J3.8, J10.1
PWM3: J3.7, J11.1
PWM4: J3.6, J12.1
PWM5: J3.5, J13.1
PWM6: J3.4, J14.1
PWM7: J3.3, J15.1
PWR0: IC0.3 (IP-_1), IC0.4 (IP-_2), J4.4
PWR1: IC1.3 (IP-_1), IC1.4 (IP-_2), J4.2
PWR2: IC2.3 (IP-_1), IC2.4 (IP-_2), J5.4
PWR3: IC3.3 (IP-_1), IC3.4 (IP-_2), J5.2
PWR4: IC4.3 (IP-_1), IC4.4 (IP-_2), J6.4
PWR5: IC5.3 (IP-_1), IC5.4 (IP-_2), J6.2
PWR6: IC6.3 (IP-_1), IC6.4 (IP-_2), J7.4
PWR7: IC7.3 (IP-_1), IC7.4 (IP-_2), J7.2
REF: J99.5, R2.1
SCL: J2.2, J99.3, U1.2 (SCL)
SDA: J2.1, J99.4, U1.1 (SDA)
VIout0: Cf9.1, IC0.7 (VIOUT), R9.1
VIout0Div: J98.1, R9.2, R17.1
VIout1: Cf10.1, IC1.7 (VIOUT), R10.1
VIout1Div: J98.2, R10.2, R18.1
VIout2: Cf11.1, IC2.7 (VIOUT), R11.1
VIout2Div: J98.3, R11.2, R19.1
VIout3: Cf12.1, IC3.7 (VIOUT), R12.1
VIout3Div: J98.4, R12.2, R20.1
VIout4: Cf13.1, IC4.7 (VIOUT), R13.1
VIout4Div: J98.5, R13.2, R21.1
VIout5: Cf14.1, IC5.7 (VIOUT), R14.1
VIout5Div: J98.6, R14.2, R22.1
VIout6: Cf15.1, IC6.7 (VIOUT), R15.1
VIout6Div: J98.7, R15.2, R23.1
VIout7: Cf16.1, IC7.7 (VIOUT), R16.1
VIout7Div: J98.8, R16.2, R24.1

Notes on the sheet:
Interconnect to MLU
Convert 5V analog output logic to 3.3V Min resistance is 4.9k. Spec to 5.5k Rdiv = 0.6 (5V --> 3V)
Analog noise filter
+Batt/-Batt are electrically isolated from VCC/GND
https://learn.adafruit.com/adafruit-ads7830-8-channel-8-bit-adc/pinouts
To fix as of 6/23/25: -- Neo pads -- capacitors between neo pixels edits as of 2/17/26: -- remove LEDs [DONE] -- connector for +batt, -batt, SDA, SCL [DONE] -- trim down the interconnect to MLU (just PWM) [DONE] -- include way to concatenate 8 analog current sensor readings for I2C -- fix capacitor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
I2C @ 0x48
Adafruit ADS7830 Interconnect
5V or 3.3V, sets I2C output and Vanalog range
0x1B --> Temp Sensor 0x48 --> x8 ADC for current sensors
High Power Connector Sockets For Vbatt & Gnd, SCL & SDA
Voltage Regulators
Integrated MCP9808 #1
Power Connectors To ESCs
3.3V reference -> 12.9mV resolution -> 149mA resolution/thruster
PWM Thruster Interface
I2C @ 0x1B format: 0011(A2)(A1)(A0)
Hall Effect Sensors
The Output voltage has a sensitivity of 133 mV/A (5V ref) or 88mV/A (3.3V ref) At 0A it will read Vcc * 0.1 = .5V So at 30A it should read 4.49V Max Vcc = 5.5V and Max Icc = 13mA T_r = 3.5us unfiltered, 300us with 100nF cap Viout min resistance = 4.7k

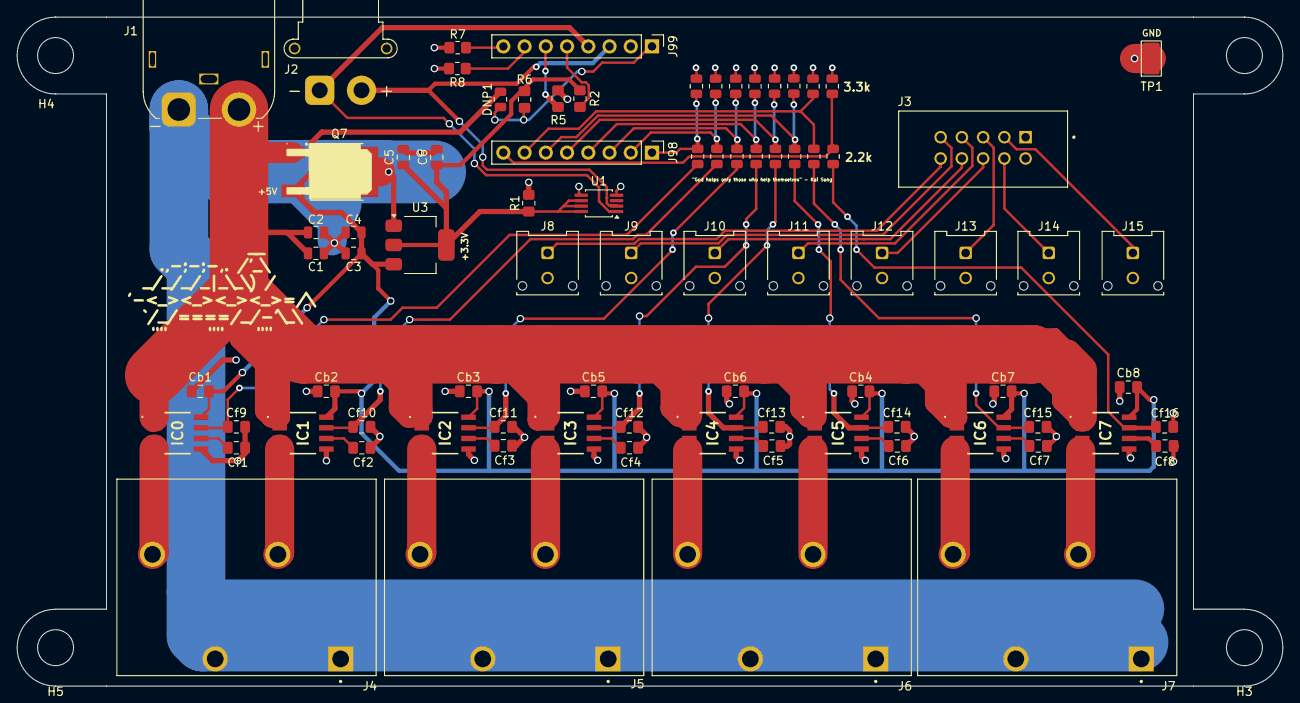
[picture p62: board Power_Distribution.kicad_pcb from above]

Board: 2 copper layers, 151.4 x 80.0 mm, 86 parts (0 on the bottom side), 52 nets.
