ryos17/robosub-ee/gen3/PCBs/Micro_Breakout/Micro_Breakout.kicad_pcb

## KiCad design gen3/PCBs/Micro_Breakout/Micro_Breakout.kicad_pcb (2026-04-29)

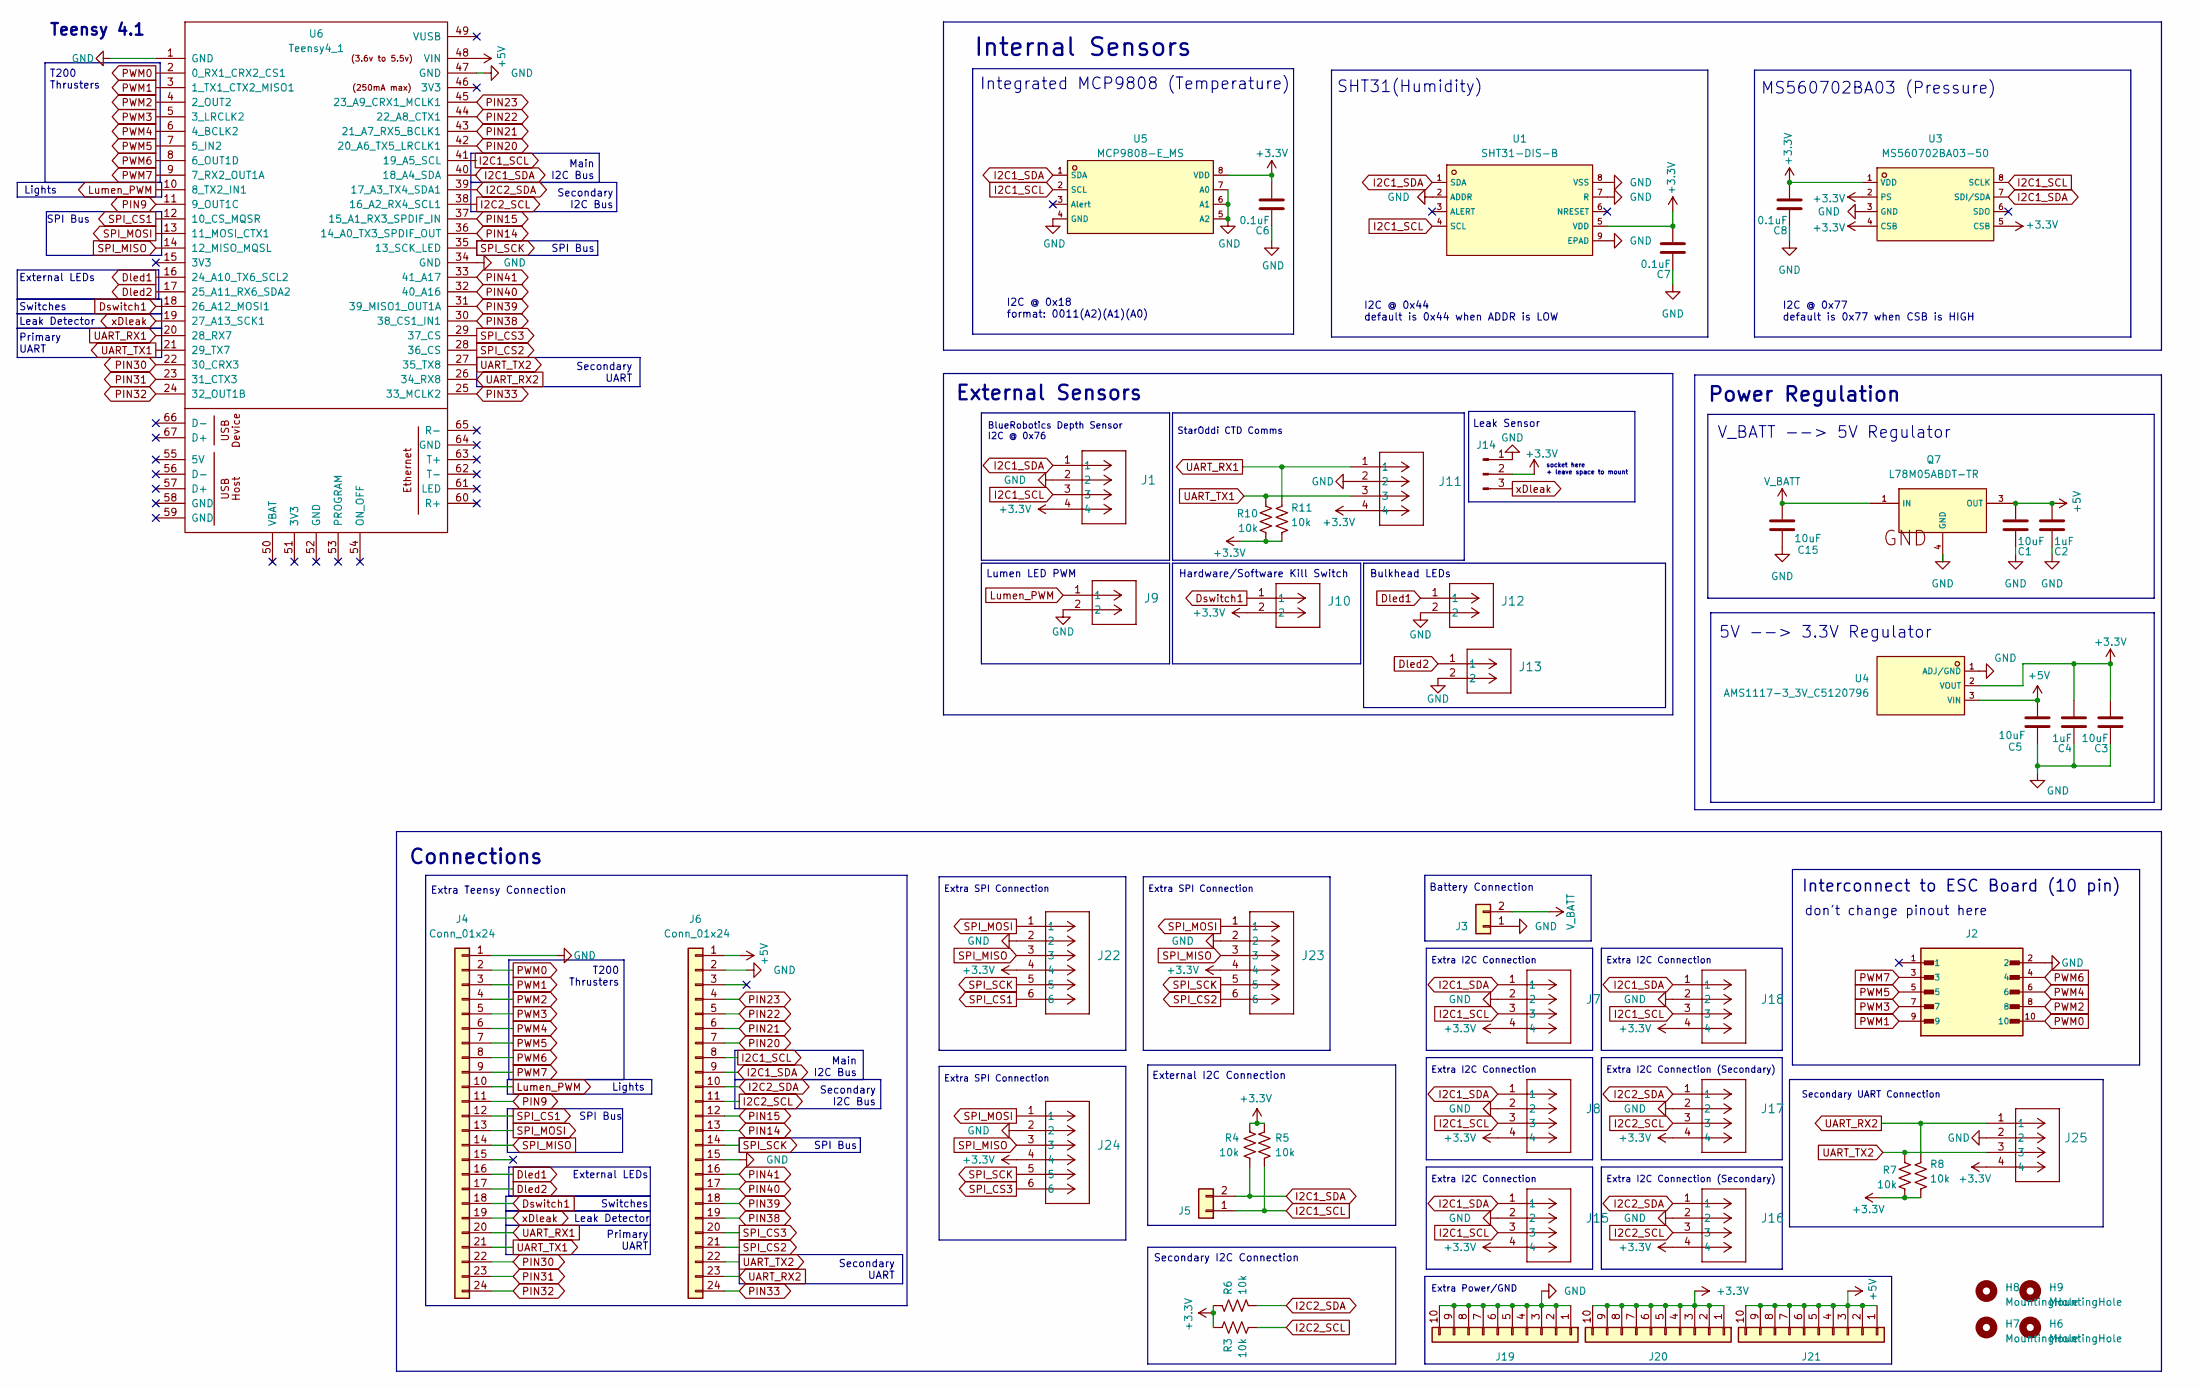
[picture p63: schematic Micro_Breakout.kicad_sch, Main Microcontroller Breakout Board]

Parts:
C1, C3, C5, C15: 10uF; C_0805_2012Metric_Pad1.18x1.45mm_HandSolder
C2, C4: 1uF; C_0805_2012Metric_Pad1.18x1.45mm_HandSolder
C6, C7, C8: 0.1uF; C_0805_2012Metric_Pad1.18x1.45mm_HandSolder
H6, H7, H8, H9: MountingHole; MountingHole_4.3mm_M4
J1: BlueRobotics Depth Sensor; 430450412
J2: Interconnect; SBH11-PBPC-D05-ST-BK; PARTREV J
J3: External Battery; AMASS_XT60PW-F_1x02_P7.20mm_Horizontal
J4, J6: Conn_01x24; PinHeader_1x24_P2.54mm_Vertical
J5: External I2C; AMASS_XT30PW-F_1x02_P2.50mm_Horizontal
J7: Extra I2C #1; 430450412
J8: Extra I2C #2; 430450412
J9: Lumen PWM; 430450212
J10: Kill Switch; 430450212
J11: StarOddi CTD Comms; 430450412
J12: LED1; 430450212
J13: LED2; 430450212
J14: Leak Sensor; PinHeader_1x03_P2.54mm_Vertical
J15: Extra I2C #3; 430450412
J16: Extra I2C #6; 430450412
J17: Extra I2C #5; 430450412
J18: Extra I2C #4; 430450412
J19: GND Line; PinHeader_1x10_P2.54mm_Vertical
J20: 3.3V Line; PinHeader_1x10_P2.54mm_Vertical
J21: 5V Line; PinHeader_1x10_P2.54mm_Vertical
J22: Extra SPI #1; 430450612
J23: Extra SPI #2; 430450612
J24: Extra SPI #3; 430450612
J25: Secondary UART; 430450412
Q7: L78M05ABDT-TR; LCSC C58069
R3, R4, R5, R6, R7, R8, R10, R11: 10k; R_0805_2012Metric_Pad1.20x1.40mm_HandSolder
U1: SHT31-DIS-B; LCSC C80862
U3: MS560702BA03-50; LCSC C97627
U4: AMS1117-3_3V_C5120796; LCSC C5120796
U5: MCP9808-E_MS; LCSC C94847
U6: Teensy4_1

Connections:
+3.3V: C3.1, C4.1, C6.1, C7.1, C8.1, J1.4, J7.4, J8.4, J10.2, J11.4, J14.2, J15.4, J16.4, J17.4, J18.4, J20.1, J20.2, J20.3, J20.4, J20.5, J20.6, J20.7, J20.8, J20.9, J20.10, J22.4, J23.4, J24.4, J25.4, R3.1, R4.1, R5.1, R6.1, R7.2, R8.2, R10.2, R11.2, U1.5 (VDD), U3.1 (VDD), U3.2 (PS), U3.4 (CSB), U3.5 (CSB), U4.2 (VOUT), U5.8 (VDD)
+5V: C1.1, C2.1, C5.1, J6.1, J21.1, J21.2, J21.3, J21.4, J21.5, J21.6, J21.7, J21.8, J21.9, J21.10, Q7.3 (OUT), U4.3 (VIN), U6.48 (VIN)
Dled1: J4.16, J12.1, U6.16 (24_A10_TX6_SCL2)
Dled2: J4.17, J13.1, U6.17 (25_A11_RX6_SDA2)
Dswitch1: J4.18, J10.1, U6.18 (26_A12_MOSI1)
GND: C1.2, C2.2, C3.2, C4.2, C5.2, C6.2, C7.2, C8.2, C15.2, J1.2, J2.2, J3.1, J4.1, J6.2, J6.15, J7.2, J8.2, J9.2, J11.2, J12.2, J13.2, J14.1, J15.2, J16.2, J17.2, J18.2, J19.1, J19.2, J19.3, J19.4, J19.5, J19.6, J19.7, J19.8, J19.9, J19.10, J22.2, J23.2, J24.2, J25.2, Q7.4 (GND), U1.2 (ADDR), U1.7 (R), U1.8 (VSS), U1.9 (EPAD), U3.3 (GND), U4.1 (ADJ/GND), U5.4 (GND), U5.5 (A2), U5.6 (A1), U5.7 (A0), U6.1 (GND), U6.34 (GND), U6.47 (GND)
I2C1_SCL: J1.3, J5.1, J6.8, J7.3, J8.3, J15.3, J18.3, R5.2, U1.4 (SCL), U3.8 (SCLK), U5.2 (SCL), U6.41 (19_A5_SCL)
I2C1_SDA: J1.1, J5.2, J6.9, J7.1, J8.1, J15.1, J18.1, R4.2, U1.1 (SDA), U3.7 (SDI/SDA), U5.1 (SDA), U6.40 (18_A4_SDA)
I2C2_SCL: J6.11, J16.3, J17.3, R3.2, U6.38 (16_A2_RX4_SCL1)
I2C2_SDA: J6.10, J16.1, J17.1, R6.2, U6.39 (17_A3_TX4_SDA1)
Lumen_PWM: J4.10, J9.1, U6.10 (8_TX2_IN1)
PIN9: J4.11, U6.11 (9_OUT1C)
PIN14: J6.13, U6.36 (14_A0_TX3_SPDIF_OUT)
PIN15: J6.12, U6.37 (15_A1_RX3_SPDIF_IN)
PIN20: J6.7, U6.42 (20_A6_TX5_LRCLK1)
PIN21: J6.6, U6.43 (21_A7_RX5_BCLK1)
PIN22: J6.5, U6.44 (22_A8_CTX1)
PIN23: J6.4, U6.45 (23_A9_CRX1_MCLK1)
PIN30: J4.22, U6.22 (30_CRX3)
PIN31: J4.23, U6.23 (31_CTX3)
PIN32: J4.24, U6.24 (32_OUT1B)
PIN33: J6.24, U6.25 (33_MCLK2)
PIN38: J6.19, U6.30 (38_CS1_IN1)
PIN39: J6.18, U6.31 (39_MISO1_OUT1A)
PIN40: J6.17, U6.32 (40_A16)
PIN41: J6.16, U6.33 (41_A17)
PWM0: J2.10, J4.2, U6.2 (0_RX1_CRX2_CS1)
PWM1: J2.9, J4.3, U6.3 (1_TX1_CTX2_MISO1)
PWM2: J2.8, J4.4, U6.4 (2_OUT2)
PWM3: J2.7, J4.5, U6.5 (3_LRCLK2)
PWM4: J2.6, J4.6, U6.6 (4_BCLK2)
PWM5: J2.5, J4.7, U6.7 (5_IN2)
PWM6: J2.4, J4.8, U6.8 (6_OUT1D)
PWM7: J2.3, J4.9, U6.9 (7_RX2_OUT1A)
SPI_CS1: J4.12, J22.6, U6.12 (10_CS_MQSR)
SPI_CS2: J6.21, J23.6, U6.28 (36_CS)
SPI_CS3: J6.20, J24.6, U6.29 (37_CS)
SPI_MISO: J4.14, J22.3, J23.3, J24.3, U6.14 (12_MISO_MQSL)
SPI_MOSI: J4.13, J22.1, J23.1, J24.1, U6.13 (11_MOSI_CTX1)
SPI_SCK: J6.14, J22.5, J23.5, J24.5, U6.35 (13_SCK_LED)
UART_RX1: J4.20, J11.1, R11.1, U6.20 (28_RX7)
UART_RX2: J6.23, J25.1, R8.1, U6.26 (34_RX8)
UART_TX1: J4.21, J11.3, R10.1, U6.21 (29_TX7)
UART_TX2: J6.22, J25.3, R7.1, U6.27 (35_TX8)
V_BATT: C15.1, J3.2, Q7.1 (IN)
xDleak: J4.19, J14.3, U6.19 (27_A13_SCK1)

Notes on the sheet:
Secondary I2C Bus
Hardware/Software Kill Switch
don't change pinout here
Primary UART
External I2C Connection
Power Regulation
Extra SPI Connection
Extra I2C Connection
I2C @ 0x44 default is 0x44 when ADDR is LOW
I2C @ 0x77 default is 0x77 when CSB is HIGH
Switches
Battery Connection
Lumen LED PWM
StarOddi CTD Comms
T200 Thrusters
SHT31(Humidity)
Extra I2C Connection (Secondary)
External LEDs
5V --> 3.3V Regulator
Leak Detector
Secondary UART
Internal Sensors
BlueRobotics Depth Sensor I2C @ 0x76
Bulkhead LEDs
Lights
Main I2C Bus
I2C @ 0x18 format: 0011(A2)(A1)(A0)
socket here + leave space to mount
Interconnect to ESC Board (10 pin)
Secondary I2C Connection
Extra Power/GND
Connections
Teensy 4.1
Leak Sensor
SPI Bus
Secondary UART Connection
External Sensors
Extra Teensy Connection
MS560702BA03 (Pressure)
V_BATT --> 5V Regulator
Integrated MCP9808 (Temperature)

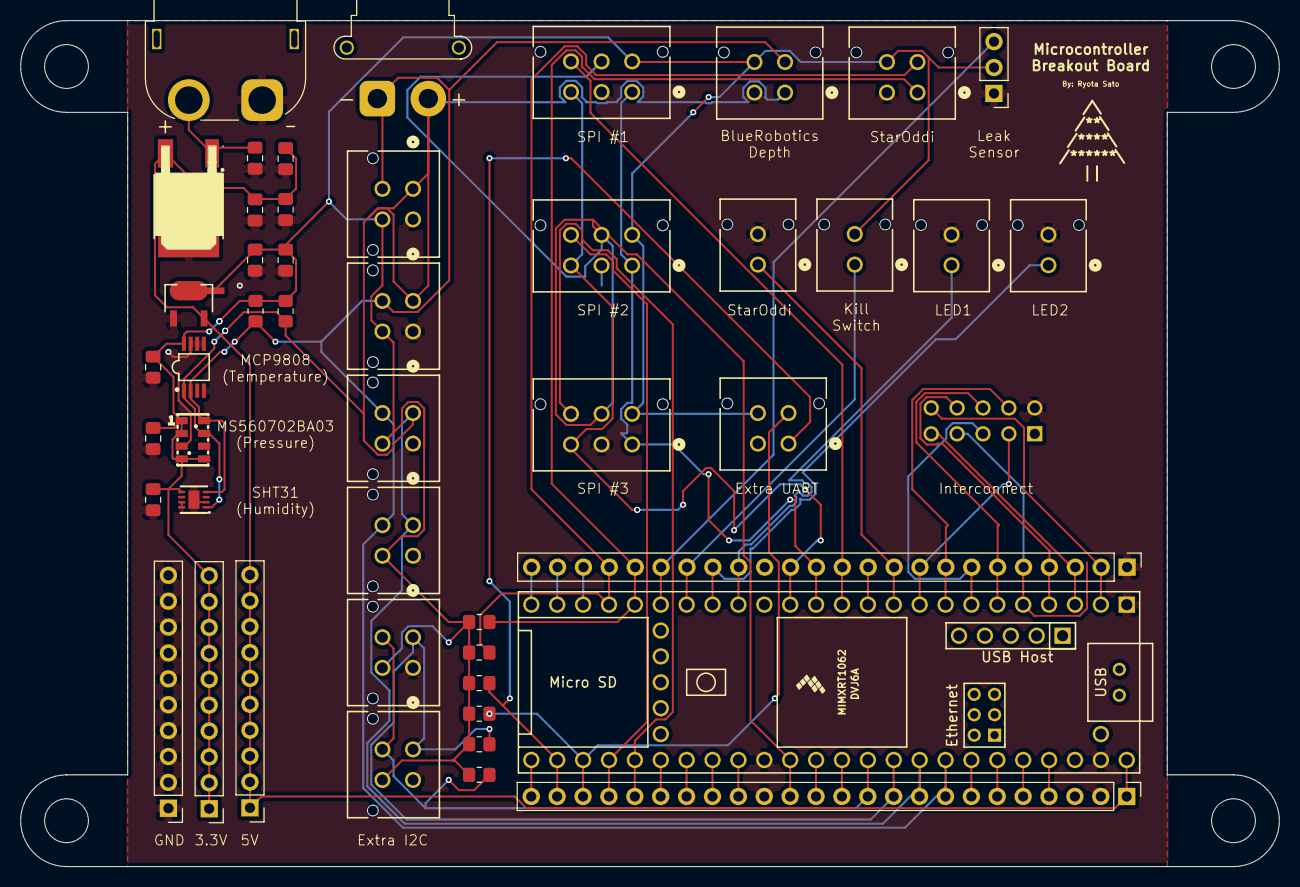
[picture p64: board Micro_Breakout.kicad_pcb from above]

Board: 2 copper layers, 123.5 x 83.0 mm, 52 parts (1 on the bottom side), 46 nets.
