ryos17/robosub-ee/gen3/PCBs/Battery_Boards/Power_ManagementV3_eli/Power_ManagementV3_eli.kicad_pcb

## KiCad design gen3/PCBs/Battery_Boards/Power_ManagementV3_eli/Power_ManagementV3_eli.kicad_pcb (2026-02-27)

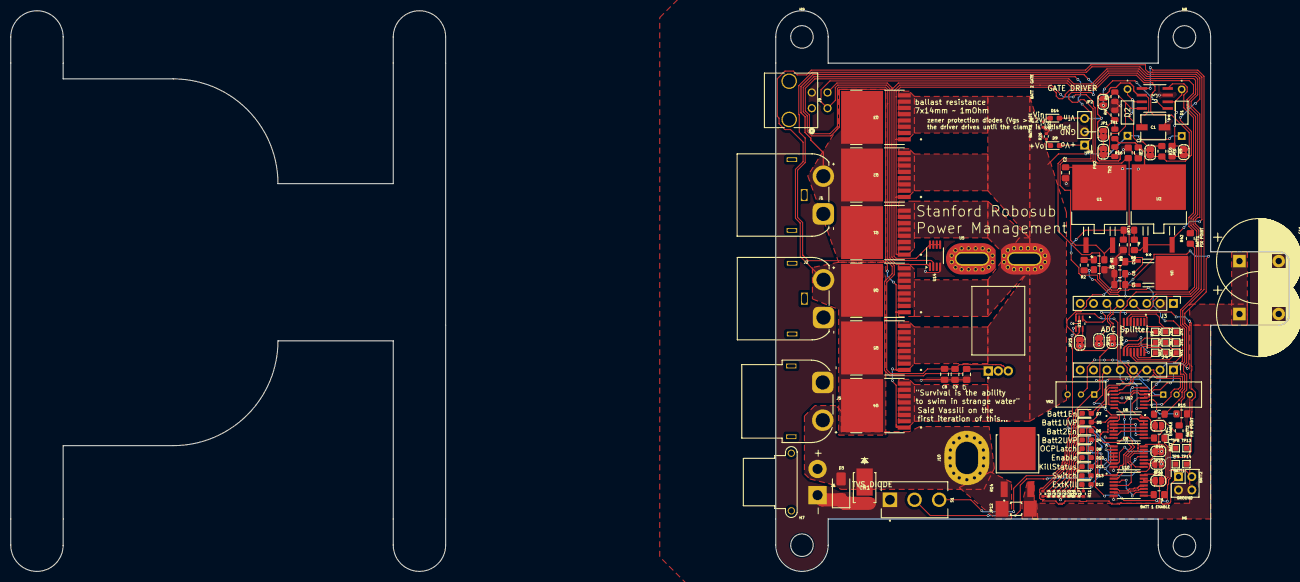
[picture p65: board Power_ManagementV3_eli.kicad_pcb from above]

Board: 2 copper layers, 98.0 x 107.0 mm, 118 parts (0 on the bottom side), 73 nets.

Parts:
2A2, 2B2, 2Y1, 3A2, 3B2, 3Y1, 4A1, 4B1, 4Y1: TestPoint; TestPoint_Pad_1.0x1.0mm
C1: 10uF; CAP_EEE-1CA100SR_PAN
C2, C3, C4, C5: 10uF; C_0805_2012Metric_Pad1.18x1.45mm_HandSolder
C6: 1uF; C_0805_2012Metric_Pad1.18x1.45mm_HandSolder
C7: 0.1u; C_0805_2012Metric_Pad1.18x1.45mm_HandSolder
C8: 100nF; C_0805_2012Metric_Pad1.18x1.45mm_HandSolder
C9: 1µF; C_0805_2012Metric_Pad1.18x1.45mm_HandSolder
C10, C11: 10,000uF; CP_Radial_D16.0mm_P7.50mm
CR1: SBRT15U50SP5-13; POWERDI5_DIO
D1, D2: D_Zener; 1N5242B
D3: TVS; D_SMA
D4, D5, D6, D7, D8, D9, D10, D11, D12, D13, D14: GreenLED; LED_0603_1608Metric_Pad1.05x0.95mm_HandSolder
H6, H7, H8, H9: MountingHole; MountingHole_4.3mm_M4
J1, J2: Conn_01x02_Pin; AMASS_XT60IPW-M_1x03_P7.20mm_Horizontal
J3, J4: Conn_01x08; PinHeader_1x08_P2.54mm_Vertical
J5: Conn_01x02_Pin; AMASS_XT60PW-F_1x02_P7.20mm_Horizontal
J6: Conn_01x02_Pin; AMASS_XT30PW-F_1x02_P2.50mm_Horizontal
J9: Conn_01x04_Pin; CONN_SD-43045-008_04_MOL
J10: via; MountingHole_4.3x6.2mm_M4_Pad_Via
J17: FPGA MOUNT; PinHeader_2x02_P2.54mm_Vertical
JP1, JP3: SolderJumper_2_Bridged; SolderJumper-2_P1.3mm_Bridged2Bar_RoundedPad1.0x1.5mm
JP2: SolderJumper_2_Open; SolderJumper-2_P1.3mm_Open_RoundedPad1.0x1.5mm
JP6, JP7: SolderJumper-2_P1.3mm_Bridged2Bar_RoundedPad1.0x1.5mm
JP10, JP11, JP25, JP27: Jumper_2_Bridged; SolderJumper-2_P1.3mm_Bridged2Bar_RoundedPad1.0x1.5mm
JP12: Jumper_2_Open; KEYSTONE_5102
JP21, JP23, JP26: Jumper_2_Open; SolderJumper-2_P1.3mm_Open_RoundedPad1.0x1.5mm
PM2: LMS78
Q1, Q2, Q3, Q4, Q5, Q6: MCTL160N15Y-TP; TOLL-8L_MCC
R1, R6: 50k; R_0805_2012Metric_Pad1.20x1.40mm_HandSolder
R2, R3, R7, R8, R16: 10k; R_0805_2012Metric_Pad1.20x1.40mm_HandSolder
R4, R5: 100k; R_0805_2012Metric
R9, R10, R42, R43, R44, R45: 0R; R_0805_2012Metric_Pad1.20x1.40mm_HandSolder
R11, R12, R17, R18, R19, R20, R22, R23, R24: 100; R_0402_1005Metric
R13: 2.2k; R_0805_2012Metric_Pad1.20x1.40mm_HandSolder
R14: 0.5 Ohm 25W; TO508P1229X317-3N
R15: 3.9k; R_0805_2012Metric_Pad1.20x1.40mm_HandSolder
R25: 15k; R_0402_1005Metric
R26: 1.5k; R_0402_1005Metric
S1: 100SP1T1B4M2QE; SW_100SP1T1B4M2QE
TH1, TH2: Thermistor_US; R_0805_2012Metric
TP8, TP9, TP13, TP14: TestPoint; TestPoint_Pad_1.0x1.0mm
U1, U2: STPS5045SG-TR; D2PAK_STM
U3: LTC1255CS8-PBF; LTC1255
U4: BA033CC0FP-E2; TO252-3_ROM
U5: ACS758LCB-100U-PFF-T; Allegro_MicroSystems,_LLC-CB-5-PFF-0-0-MFG
U6, U8, U9, U10: SN74HC132PWR; SOP65P640X120-14N
U11: SN74LVC1G373DCKR; SN74LVC
U12: MCP6564-E/ST; TSSOP14_MC_MCH
U14: MCP9808_MSOP; MSOP-8_3x3mm_P0.65mm
VR1, VR2: 3296W-1-103RLF; TRIM_3296W-1-103RLF

Connections:
+3.3V: C5.1, C6.1, JP10.2 (B), JP21.2 (B), JP23.2 (B), R16.1, S1.3, U4.3 (OUT), U6.14 (VCC), U8.14 (VCC), U9.14 (VCC), U10.14 (VCC), U11.5 (VCC), U12.4 (VDD), U14.5 (A2), U14.6 (A1), U14.7 (A0), U14.8 (V_{DD}), VR1.1, VR2.1
+5V: C4.1, C7.2, D9.2 (A), PM2.3, U4.1 (Vcc), U5.1 (VCC)
+BATT: CR1.3, D3.2 (A), J5.2, J6.2, J10.1, JP12.2 (B), R14.1, U5.5 (IP-)
+BATT1: J1.2, Q1.9 (D), Q2.9 (D), Q3.9 (D), R1.2, U1.1 (Input), U1.3 (Input)
+BATT2: J2.2, Q4.9 (D), Q5.9 (D), Q6.9 (D), R6.1, U2.1 (Input), U2.3 (Input)
+BATTHall: D1.2 (A), D2.2 (A), Q1.2 (S), Q1.3 (S), Q1.4 (S), Q1.5 (S), Q1.6 (S), Q1.7 (S), Q1.8 (S), Q2.2 (S), Q2.3 (S), Q2.4 (S), Q2.5 (S), Q2.6 (S), Q2.7 (S), Q2.8 (S), Q3.2 (S), Q3.3 (S), Q3.4 (S), Q3.5 (S), Q3.6 (S), Q3.7 (S), Q3.8 (S), Q4.2 (S), Q4.3 (S), Q4.4 (S), Q4.5 (S), Q4.6 (S), Q4.7 (S), Q4.8 (S), Q5.2 (S), Q5.3 (S), Q5.4 (S), Q5.5 (S), Q5.6 (S), Q5.7 (S), Q5.8 (S), Q6.2 (S), Q6.3 (S), Q6.4 (S), Q6.5 (S), Q6.6 (S), Q6.7 (S), Q6.8 (S), U5.4 (IP+)
+VregDiode: C1.1, C2.1, C3.1, D14.2 (A), JP1.2 (B), JP3.2 (B), PM2.1, TH1.1, TH2.1, U1.2 (Output), U2.2 (Output), U3.6 (VS)
-BATT1: C1.2, C2.2, C3.2, C4.2, C5.2, C6.2, C7.1, C8.2, C9.2, C10.2, C11.2, CR1.1, CR1.2, D3.1 (K), J1.1, J2.1, J3.2, J5.1, J6.1, J9.2, J17.3, J17.4, JP11.2 (B), JP25.1 (A), PM2.2, R3.1, R4.1, R5.1, R8.1, R11.2, R12.1, R15.2, R16.2, R17.2, R18.2, R19.2, R20.2, R22.2, R23.2, R24.2, R25.2, R26.2, S1.1, U3.3 (GND), U4.2 (GND), U5.2 (GND), U6.7 (GND), U8.7 (GND), U9.7 (GND), U10.7 (GND), U11.2 (GND), U12.11 (VSS), U14.4 (GND), VR1.3, VR2.3
/Battery Control Logic/Batt1>UVP: D5.2 (A), U6.1 (1A), U12.8 (OUTC)
/Battery Control Logic/Batt1Disable: U10.5 (2B), U10.11 (4Y)
/Battery Control Logic/Batt2>UVP: D4.2 (A), U10.1 (1A), U12.14 (OUTD)
/Battery Control Logic/OCPReference: J4.4, U12.2 (-INA), VR2.2
/Battery Control Logic/OnboardKillSwitch: D13.2 (A), S1.2, U8.1 (1A)
/Battery Control Logic/UVPReference: J4.3, U12.9 (-INC), U12.13 (-IND), VR1.2
/Battery Control Logic/VBatt1 > VBatt2: U6.4 (2A), U6.5 (2B), U6.11 (4Y)
/Battery Control Logic/VBatt1<VBatt2: U6.12 (4A), U6.13 (4B), U10.4 (2A), U12.7 (OUTB)
/Battery Control Logic/pre_enable1: R44.2, U6.8 (3Y)
/Battery Control Logic/pre_enable2: R45.2, U10.8 (3Y)
/Battery Control Logic/~GateDisable: D10.2 (A), J4.6, U6.2 (1B), U8.11 (4Y), U10.2 (1B)
/Battery Control Logic/~OCP: J4.5, U11.3 (D), U12.1 (OUTA)
/Battery Control Logic/~SystemKill post: JP27.2 (B), U8.10 (3B)
/ENABLE_BATT1: R42.2, U3.4 (IN1)
/ENABLE_BATT2: R43.2, U3.5 (IN2)
Batt1Enable: D7.2 (A), J17.1, JP21.1 (A), R42.1, R44.1, U10.12 (4A), U10.13 (4B)
Batt1Gate: JP6.1 (A), Q1.1 (G), Q2.1 (G), Q3.1 (G), R9.2
Batt1GatePreDiv: D1.1 (K), JP6.2 (B), R9.1, U3.2 (GATE1)
Batt2Enable: D6.2 (A), J17.2, JP23.1 (A), R43.1, R45.1
Batt2Gate: JP7.1 (A), Q4.1 (G), Q5.1 (G), Q6.1 (G), R10.2
Batt2GatePreDiv: D2.1 (K), JP7.2 (B), R10.1, U3.7 (GATE2)
COM: J3.6, JP11.1 (A)
Capacitors: C10.1, C11.1, JP12.1 (A), R14.2
I2C1_SCL: J3.3, J9.4, U14.2 (SCL)
I2C1_SDA: J3.4, J9.3, U14.1 (SDA)
ISample3.3V: R13.2, R15.1, U12.3 (+INA)
ISample5V: C8.1, C9.1, R13.1, U5.3 (VIOUT)
KillSwitch: D12.2 (A), U8.2 (1B)
LETeensy: JP26.1 (A), U11.1 (LE)
unnamed: D7.1 (K), R19.1
unnamed: D9.1 (K), R26.1
unnamed: D14.1 (K), R25.1
unnamed: JP1.1 (A), JP2.1 (A), R4.2, TH1.2, U3.1 (DS1)
unnamed: JP2.2 (B), JP3.1 (A), R5.2, TH2.2, U3.8 (DS2)
unnamed: JP25.2 (B), U11.6 (*OE)
unnamed: R1.1, R2.1
unnamed: R6.2, R7.2
unnamed: U6.3 (1Y), U6.9 (3A)
unnamed: U6.6 (2Y), U6.10 (3B)
unnamed: U8.3 (1Y), U8.4 (2A), U8.5 (2B)
unnamed: U8.8 (3Y), U8.12 (4A), U8.13 (4B)
unnamed: 2A2.1, U9.4 (2A)
unnamed: 2B2.1, U9.5 (2B)
unnamed: 2Y1.1, U9.6 (2Y)
unnamed: 3A2.1, U9.9 (3A)
unnamed: 3B2.1, U9.10 (3B)
unnamed: 3Y1.1, U9.8 (3Y)
unnamed: 4A1.1, U9.12 (4A)
unnamed: 4B1.1, U9.13 (4B)
unnamed: 4Y1.1, U9.11 (4Y)
unnamed: U10.3 (1Y), U10.9 (3A)
unnamed: U10.6 (2Y), U10.10 (3B)
RArray1: D12.1 (K), R11.1
RArray2: D13.1 (K), R12.2
RArray3: D11.1 (K), R17.1
RArray4: D10.1 (K), R18.1
RArray5: D8.1 (K), R20.1
RArray6: D4.1 (K), R22.1
RArray7: D6.1 (K), R23.1
RArray8: D5.1 (K), R24.1
REF: J3.5, JP10.1 (A)
VSampleBatt1: J4.2, R2.2, R3.2, U12.6 (-INB), U12.10 (+INC)
VSampleBatt2: J4.1, R7.1, R8.2, U12.5 (+INB), U12.12 (+IND)
~OCPLatch: D8.2 (A), JP26.2 (B), U8.9 (3A), U11.4 (Q)
~SystemKill: D11.2 (A), JP27.1 (A), U8.6 (2Y)
