ryos17/robosub-ee/gen3/PCBs/to_order/to_order/to_order.kicad_pcb

## KiCad design gen3/PCBs/to_order/to_order/to_order.kicad_pcb (2026-02-27)

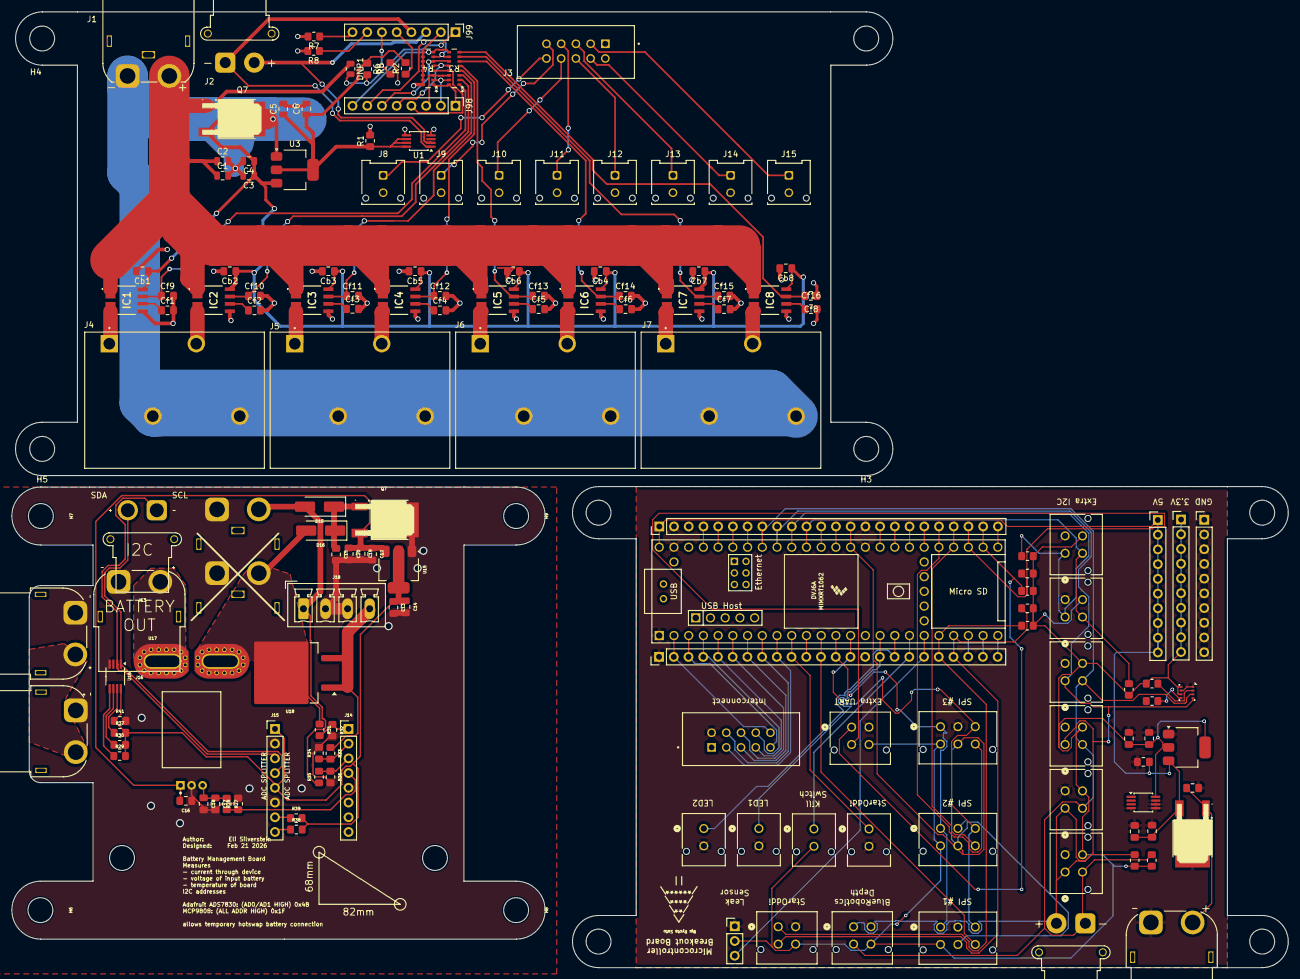
[picture p66: board to_order.kicad_pcb from above]

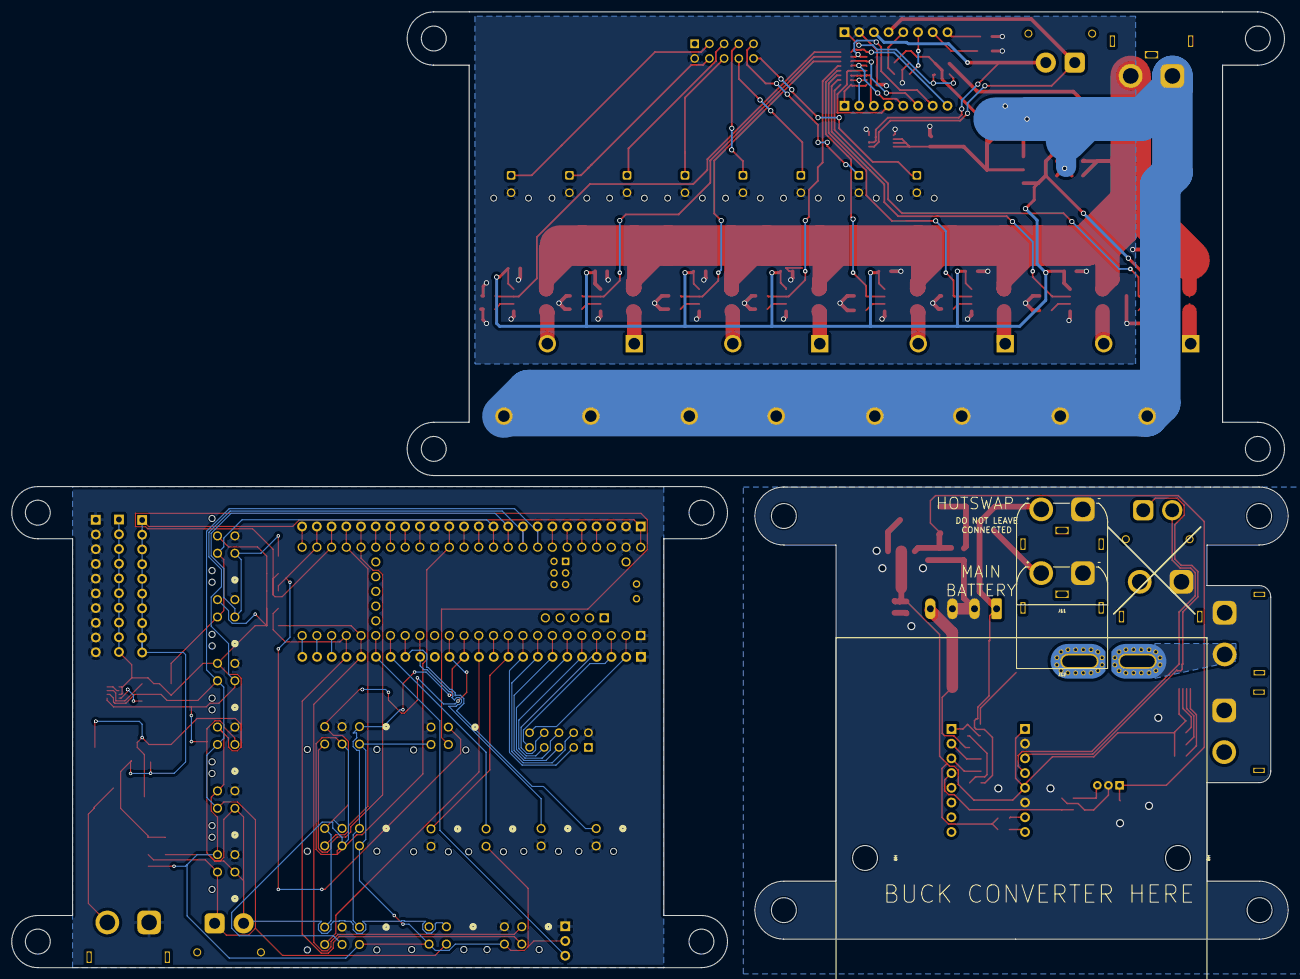
[picture p67: board to_order.kicad_pcb from below]

Board: 2 copper layers, 220.2 x 164.9 mm, 166 parts (4 on the bottom side), 109 nets.

Parts:
C1, C12, C12#2, C13, C13#2, C15, C15#2, C19: 10uF; C_0805_2012Metric_Pad1.18x1.45mm_HandSolder
C1#2, C3, C5: 1 µF; C_0805_2012Metric
C2, C14, C14#2, C20: 1uF; C_0805_2012Metric_Pad1.18x1.45mm_HandSolder
C2#2, C4, C6: 10 µF; C_0805_2012Metric
C16: 0.1uF; C_0805_2012Metric_Pad1.18x1.45mm_HandSolder
C17: 100nF; C_0805_2012Metric_Pad1.18x1.45mm_HandSolder
C18: 1µF; C_0805_2012Metric_Pad1.18x1.45mm_HandSolder
Cb1, Cb2, Cb3, Cb4, Cb5, Cb6, Cb7, Cb8: 0.1 µF; C_0805_2012Metric_Pad1.18x1.45mm_HandSolder
Cf1, Cf2, Cf3, Cf4, Cf5, Cf6, Cf7, Cf8: 100 nF; C_0805_2012Metric_Pad1.18x1.45mm_HandSolder
Cf9, Cf10, Cf11, Cf12, Cf13, Cf14, Cf15, Cf16: 1 µF; C_0805_2012Metric_Pad1.18x1.45mm_HandSolder
D15, D16: SS54; D_SMA_Handsoldering
DNP1: 0; R_0805_2012Metric
H2, H3, H4, H5, H6, H6#2, H7, H7#2, H8, H8#2, H8#3, H8#4, H9, H9#2: MountingHole; MountingHole_4.3mm_M4
IC1, IC2, IC3, IC4, IC5, IC6, IC7, IC8: ACS713ELCTR-30A-T; ACS711ELCTR25ABT
J1, J11#3, J12#3: Conn_01x02_Pin; AMASS_XT60IPW-M_1x03_P7.20mm_Horizontal
J1#2: BlueRobotics Depth Sensor; CONN_SD-43045-005_04_MOL
J2, J13#2: Conn_01x02_Pin; AMASS_XT30PW-F_1x02_P2.50mm_Horizontal
J2#2: Interconnect; SULLINS_SBH11-PBPC-D05-ST-BK
J3: External Battery; AMASS_XT60PW-F_1x02_P7.20mm_Horizontal
J3#2: SBH11-PBPC-D05-ST-BK; SULLINS_SBH11-PBPC-D05-ST-BK
J4, J5#2, J6, J7#2: 1098169; PHOENIX_1098169
J4#2, J6#2: Conn_01x24; PinHeader_1x24_P2.54mm_Vertical
J5: External I2C; AMASS_XT30PW-F_1x02_P2.50mm_Horizontal
J7: Extra I2C #1; CONN_SD-43045-005_04_MOL
J8: 0430450212; Molex_Micro-Fit_3.0_43045-0212_2x01_P3.00mm_Vertical
J8#2: Extra I2C #2; CONN_SD-43045-005_04_MOL
J9: Lumen PWM; CONN_SD-43045-005_02_MOL
J9#2, J10, J11#2, J12#2, J13#3, J14#2, J15: 430450228; Molex_Micro-Fit_3.0_43045-0212_2x01_P3.00mm_Vertical
J10#2: Kill Switch; CONN_SD-43045-005_02_MOL
J11: StarOddi CTD Comms; CONN_SD-43045-005_04_MOL
J12: LED1; CONN_SD-43045-005_02_MOL
J13: LED2; CONN_SD-43045-005_02_MOL
J14: Leak Sensor; PinHeader_1x03_P2.54mm_Vertical
J14#3, J15#2, J98, J99: Conn_01x08; PinHeader_1x08_P2.54mm_Vertical
J15#3: Extra I2C #3; CONN_SD-43045-005_04_MOL
J16: Extra I2C #6; CONN_SD-43045-005_04_MOL
J16#2, J21#2, J22: Conn_01x02_Pin; AMASS_XT60PW-F_1x02_P7.20mm_Horizontal
J17: Extra I2C #5; CONN_SD-43045-005_04_MOL
J18: Extra I2C #4; CONN_SD-43045-005_04_MOL
J18#2: Conn_01x04_Socket; PhoenixContact_MCV_1,5_4-G-3.81_1x04_P3.81mm_Vertical
J19: GND Line; PinHeader_1x10_P2.54mm_Vertical
J20: 3.3V Line; PinHeader_1x10_P2.54mm_Vertical
J21: 5V Line; PinHeader_1x10_P2.54mm_Vertical
J22#2: Extra SPI #1; CONN_SD-43045-005_06_MOL
J23: Extra SPI #2; CONN_SD-43045-005_06_MOL
J24: Extra SPI #3; CONN_SD-43045-005_06_MOL
J25: Secondary UART; CONN_SD-43045-005_04_MOL
Q7, Q7#2, Q7#3: L78M05ABDT-TR; TO-252-2_L6.5-W6.1-P4.58-LS10.0-TL
R1, R2, R3#2, R4#2, R5#2, R6#2, R7, R8, R10, R11, R27, R32, R34, R36, R41: 10k; R_0805_2012Metric_Pad1.20x1.40mm_HandSolder
R1#2, R2#2, R5, R6, R7#2, R8#2, R29, R30, R37, R38, R39: 0R; R_0805_2012Metric_Pad1.20x1.40mm_HandSolder
R3: 2.2k Array; 2506_8x_Resistor_Array
R4: 3.3k Array; 2506_8x_Resistor_Array
R28: 20k; R_0805_2012Metric_Pad1.20x1.40mm_HandSolder
R31, R33, R35: 47k; R_0805_2012Metric_Pad1.20x1.40mm_HandSolder
U1, U2, U16: MCP9808_MSOP; MSOP-8_3x3mm_P0.65mm
U3, U15, U15#2: AMS1117-3.3; SOT-223-3_TabPin2
U4: BME280; Bosch_LGA-8_2.5x2.5mm_P0.65mm_ClockwisePinNumbering
U6: Teensy4.1; Teensy41
U17: ACS758LCB-100U-PFF-T; Allegro_MicroSystems,_LLC-CB-5-PFF-0-0-MFG
U18: SRT60L100DC-R; TO-263-2

Connections:
+3.3V: C5.1, C6.1, C13#2.1, C14#2.1, J1#2.4, J7.4, J8#2.4, J10#2.2, J11.4, J14.2, J15#3.4, J16.4, J17.4, J18.4, J20.1, J20.2, J20.3, J20.4, J20.5, J20.6, J20.7, J20.8, J20.9, J20.10, J22#2.4, J23.4, J24.4, J25.4, R1.1, R2.1, R2#2.2, R3#2.1, R4#2.1, R5#2.1, R6.1, R6#2.1, R7.2, R8.2, R10.2, R11.2, U1.6 (A1), U1.7 (A0), U1.8 (V_{DD}), U2.8 (V_{DD}), U3.2 (VO), U4.6 (VDDIO), U4.8 (VDD), U15.2 (VO)
+3.3V_: C13.1, C14.1, J15#2.1, J15#2.5, R29.2, R30.2, R37.2, R38.2, R39.2, R41.1, U15#2.2 (VO), U16.8 (V_{DD})
+5V: C1.1, C2.1, C3.1, C4.1, C12.1, Cb1.1, Cb2.1, Cb3.1, Cb4.1, Cb5.1, Cb6.1, Cb7.1, Cb8.1, DNP1.1, IC1.8 (VCC), IC2.8 (VCC), IC3.8 (VCC), IC4.8 (VCC), IC5.8 (VCC), IC6.8 (VCC), IC7.8 (VCC), IC8.8 (VCC), J6#2.1, J21.1, J21.2, J21.3, J21.4, J21.5, J21.6, J21.7, J21.8, J21.9, J21.10, Q7#2.3 (OUT), Q7#3.3 (OUT), U3.3 (VI), U6.48 (VIN), U15.3 (VI)
+5V_: C12#2.1, C16.2, C19.1, C20.1, Q7.3 (OUT), U15#2.3 (VI), U17.1 (VCC)
+BATT: C1#2.1, C2#2.1, D16.2 (A), IC1.1 (IP+_1), IC1.2 (IP+_2), IC2.1 (IP+_1), IC2.2 (IP+_2), IC3.1 (IP+_1), IC3.2 (IP+_2), IC4.1 (IP+_1), IC4.2 (IP+_2), IC5.1 (IP+_1), IC5.2 (IP+_2), IC6.1 (IP+_1), IC6.2 (IP+_2), IC7.1 (IP+_1), IC7.2 (IP+_2), IC8.1 (IP+_1), IC8.2 (IP+_2), J1.2, J12#3.2, Q7#3.1 (IN), R31.1, U17.4 (IP+), U18.2 (Output)
+BATT_out: J16#2.2, J21#2.2, J22.2, U17.5 (IP-)
+EXT_LV_SUPPLY: J18#2.4, R33.1, U18.1 (Input), U18.3 (Input)
+TEMP_BATT: D15.2 (A), J11#3.2, J18#2.1, R35.1
-BATT: C1#2.2, C2#2.2, C3.2, C4.2, C5.2, C6.2, J1.1, J4.2, J4.4, J5#2.2, J5#2.4, J6.2, J6.4, J7#2.2, J7#2.4, Q7#3.4 (GND), U3.1 (GND)
/SCL: J13#2.1, J15#2.3, U16.2 (SCL)
/SDA: J13#2.2, J15#2.4, U16.1 (SDA)
AD0: J99.7, R8#2.1
AD1: J99.8, R7#2.1
COM: J99.6, R5.1
Dled1: J4#2.16, J12.1, U6.16 (24_A10_TX6_SCL2)
Dled2: J4#2.17, J13.1, U6.17 (25_A11_RX6_SDA2)
Dswitch1: J4#2.18, J10#2.1, U6.18 (26_A12_MOSI1)
GND: C1.2, C2.2, C12.2, C13#2.2, C14#2.2, C15#2.2, Cb1.2, Cb2.2, Cb3.2, Cb4.2, Cb5.2, Cb6.2, Cb7.2, Cb8.2, Cf1.2, Cf2.2, Cf3.2, Cf4.2, Cf5.2, Cf6.2, Cf7.2, Cf8.2, Cf9.2, Cf10.2, Cf11.2, Cf12.2, Cf13.2, Cf14.2, Cf15.2, Cf16.2, IC1.5 (GND), IC2.5 (GND), IC3.5 (GND), IC4.5 (GND), IC5.5 (GND), IC6.5 (GND), IC7.5 (GND), IC8.5 (GND), J1#2.2, J2#2.2, J3.1, J3#2.2, J4#2.1, J6#2.2, J6#2.15, J7.2, J8.2, J8#2.2, J9.2, J9#2.2, J10.2, J11.2, J11#2.2, J12.2, J12#2.2, J13.2, J13#3.2, J14.1, J14#2.2, J15.2, J15#3.2, J16.2, J17.2, J18.2, J19.1, J19.2, J19.3, J19.4, J19.5, J19.6, J19.7, J19.8, J19.9, J19.10, J22#2.2, J23.2, J24.2, J25.2, J99.2, Q7#2.4 (GND), R1.2, R4.9, R4.10, R4.11, R4.12, R4.13, R4.14, R4.15, R4.16, R5.2, R7#2.2, R8#2.2, U1.4 (GND), U1.5 (A2), U2.4 (GND), U2.5 (A2), U2.6 (A1), U2.7 (A0), U4.1 (GND), U4.7 (GND), U6.1 (GND), U6.34 (GND), U6.47 (GND), U15.1 (GND)
GND_bak: C12#2.2, C13.2, C14.2, C15.2, C16.1, C17.2, C18.2, C19.2, C20.2, J11#3.1, J12#3.1, J15#2.2, J15#2.6, J16#2.1, J18#2.2, J18#2.3, J21#2.1, J22.1, Q7.4 (GND), R28.2, R32.2, R34.2, R36.2, R41.2, U15#2.1 (GND), U16.4 (GND), U17.2 (GND)
I2C1_SCL: J1#2.3, J5.1, J6#2.8, J7.3, J8#2.3, J15#3.3, J18.3, R5#2.2, U4.3 (SDI), U6.41 (19_A5_SCL)
I2C1_SDA: J1#2.1, J5.2, J6#2.9, J7.1, J8#2.1, J15#3.1, J18.1, R4#2.2, U4.4 (SCK), U6.40 (18_A4_SDA)
I2C2_SCL: J6#2.11, J16.3, J17.3, R3#2.2, U6.38 (16_A2_RX4_SCL1)
I2C2_SDA: J6#2.10, J16.1, J17.1, R6#2.2, U6.39 (17_A3_TX4_SDA1)
Lumen_PWM: J4#2.10, J9.1, U6.10 (8_TX2_IN1)
unnamed: C15.1, D15.1 (K), D16.1 (K), Q7.1 (IN)
unnamed: Cf1.1, IC1.6 (FILTER)
unnamed: Cf2.1, IC2.6 (FILTER)
unnamed: Cf3.1, IC3.6 (FILTER)
unnamed: Cf4.1, IC4.6 (FILTER)
unnamed: Cf5.1, IC5.6 (FILTER)
unnamed: Cf6.1, IC6.6 (FILTER)
unnamed: Cf7.1, IC7.6 (FILTER)
unnamed: Cf8.1, IC8.6 (FILTER)
unnamed: J14#3.1, R31.2, R32.1
unnamed: J14#3.2, R33.2, R34.1
unnamed: J14#3.3, R35.2, R36.1
unnamed: J15#2.7, R39.1
unnamed: J15#2.8, R38.1
unnamed: DNP1.2, J99.1, R6.2
unnamed: R2.2, U4.2 (CSB)
unnamed: R1#2.2, U4.5 (SDO)
unnamed: R37.1, U16.7 (A0)
unnamed: R30.1, U16.6 (A1)
unnamed: R29.1, U16.5 (A2)
PIN9: J4#2.11, U6.11 (9_OUT1C)
PIN14: J6#2.13, U6.36 (14_A0_TX3_SPDIF_OUT)
PIN15: J6#2.12, U6.37 (15_A1_RX3_SPDIF_IN)
PIN20: J6#2.7, U6.42 (20_A6_TX5_LRCLK1)
PIN21: J6#2.6, U6.43 (21_A7_RX5_BCLK1)
PIN22: J6#2.5, U6.44 (22_A8_CTX1)
PIN23: J6#2.4, U6.45 (23_A9_CRX1_MCLK1)
PIN30: J4#2.22, U6.22 (30_CRX3)
PIN31: J4#2.23, U6.23 (31_CTX3)
PIN32: J4#2.24, U6.24 (32_OUT1B)
PIN33: J6#2.24, U6.25 (33_MCLK2)
PIN38: J6#2.19, U6.30 (38_CS1_IN1)
PIN39: J6#2.18, U6.31 (39_MISO1_OUT1A)
PIN40: J6#2.17, U6.32 (40_A16)
PIN41: J6#2.16, U6.33 (41_A17)
PWM0: J2#2.10, J4#2.2, U6.2 (0_RX1_CRX2_CS1)
PWM1: J2#2.9, J3#2.10, J4#2.3, J8.1, U6.3 (1_TX1_CTX2_MISO1)
PWM2: J2#2.8, J3#2.9, J4#2.4, J9#2.1, U6.4 (2_OUT2)
PWM3: J2#2.7, J3#2.8, J4#2.5, J10.1, U6.5 (3_LRCLK2)
PWM4: J2#2.6, J3#2.7, J4#2.6, J11#2.1, U6.6 (4_BCLK2)
PWM5: J2#2.5, J3#2.6, J4#2.7, J12#2.1, U6.7 (5_IN2)
PWM6: J2#2.4, J3#2.5, J4#2.8, J13#3.1, U6.8 (6_OUT1D)
PWM7: J2#2.3, J3#2.4, J4#2.9, J14#2.1, U6.9 (7_RX2_OUT1A)
PWM8: J3#2.3, J15.1
PWR1: IC1.3 (IP-_1), IC1.4 (IP-_2), J4.1
PWR2: IC2.3 (IP-_1), IC2.4 (IP-_2), J4.3
PWR3: IC3.3 (IP-_1), IC3.4 (IP-_2), J5#2.1
PWR4: IC4.3 (IP-_1), IC4.4 (IP-_2), J5#2.3
PWR5: IC5.3 (IP-_1), IC5.4 (IP-_2), J6.1
PWR6: IC6.3 (IP-_1), IC6.4 (IP-_2), J6.3
PWR7: IC7.3 (IP-_1), IC7.4 (IP-_2), J7#2.1
PWR8: IC8.3 (IP-_1), IC8.4 (IP-_2), J7#2.3
REF: J99.5, R2#2.1
SCL: J2.2, J99.3, U1.2 (SCL)
SDA: J2.1, J99.4, U1.1 (SDA)
SPI_CS1: J4#2.12, J22#2.6, U6.12 (10_CS_MQSR)
SPI_CS2: J6#2.21, J23.6, U6.28 (36_CS)
SPI_CS3: J6#2.20, J24.6, U6.29 (37_CS)
SPI_MISO: J4#2.14, J22#2.3, J23.3, J24.3, U6.14 (12_MISO_MQSL)
SPI_MOSI: J4#2.13, J22#2.1, J23.1, J24.1, U6.13 (11_MOSI_CTX1)
SPI_SCK: J6#2.14, J22#2.5, J23.5, J24.5, U6.35 (13_SCK_LED)
UART_RX1: J4#2.20, J11.1, R11.1, U6.20 (28_RX7)
UART_RX2: J6#2.23, J25.1, R8.1, U6.26 (34_RX8)
UART_TX1: J4#2.21, J11.3, R10.1, U6.21 (29_TX7)
UART_TX2: J6#2.22, J25.3, R7.1, U6.27 (35_TX8)
VIout1: Cf9.1, IC1.7 (VIOUT), R3.1
VIout1Div: J98.1, R3.16, R4.1
VIout2: Cf10.1, IC2.7 (VIOUT), R3.2
VIout2Div: J98.2, R3.15, R4.2
VIout3: Cf11.1, IC3.7 (VIOUT), R3.3
VIout3Div: J98.3, R3.14, R4.3
VIout4: Cf12.1, IC4.7 (VIOUT), R3.4
VIout4Div: J98.4, R3.13, R4.4
VIout5: Cf13.1, IC5.7 (VIOUT), R3.5
VIout5Div: J98.5, R3.12, R4.5
VIout6: Cf14.1, IC6.7 (VIOUT), R3.6
VIout6Div: J98.6, R3.11, R4.6
VIout7: Cf15.1, IC7.7 (VIOUT), R3.7
VIout7Div: J98.7, R3.10, R4.7
VIout8: Cf16.1, IC8.7 (VIOUT), R3.8
VIout8Div: J98.8, R3.9, R4.8
V_BATT: C15#2.1, J3.2, Q7#2.1 (IN)
current_sensor_3v3: J14#3.4, R27.2, R28.1
current_sensor_5v: C17.1, C18.1, R27.1, U17.3 (VIOUT)
xDleak: J4#2.19, J14.3, U6.19 (27_A13_SCK1)
