ryos17/robosub-ee/gen3/PCBs/Battery_Boards/Power_ManagementV3_diode/Power_ManagementV3_diode.kicad_pcb

## KiCad design gen3/PCBs/Battery_Boards/Power_ManagementV3_diode/Power_ManagementV3_diode.kicad_pcb (2026-02-25)

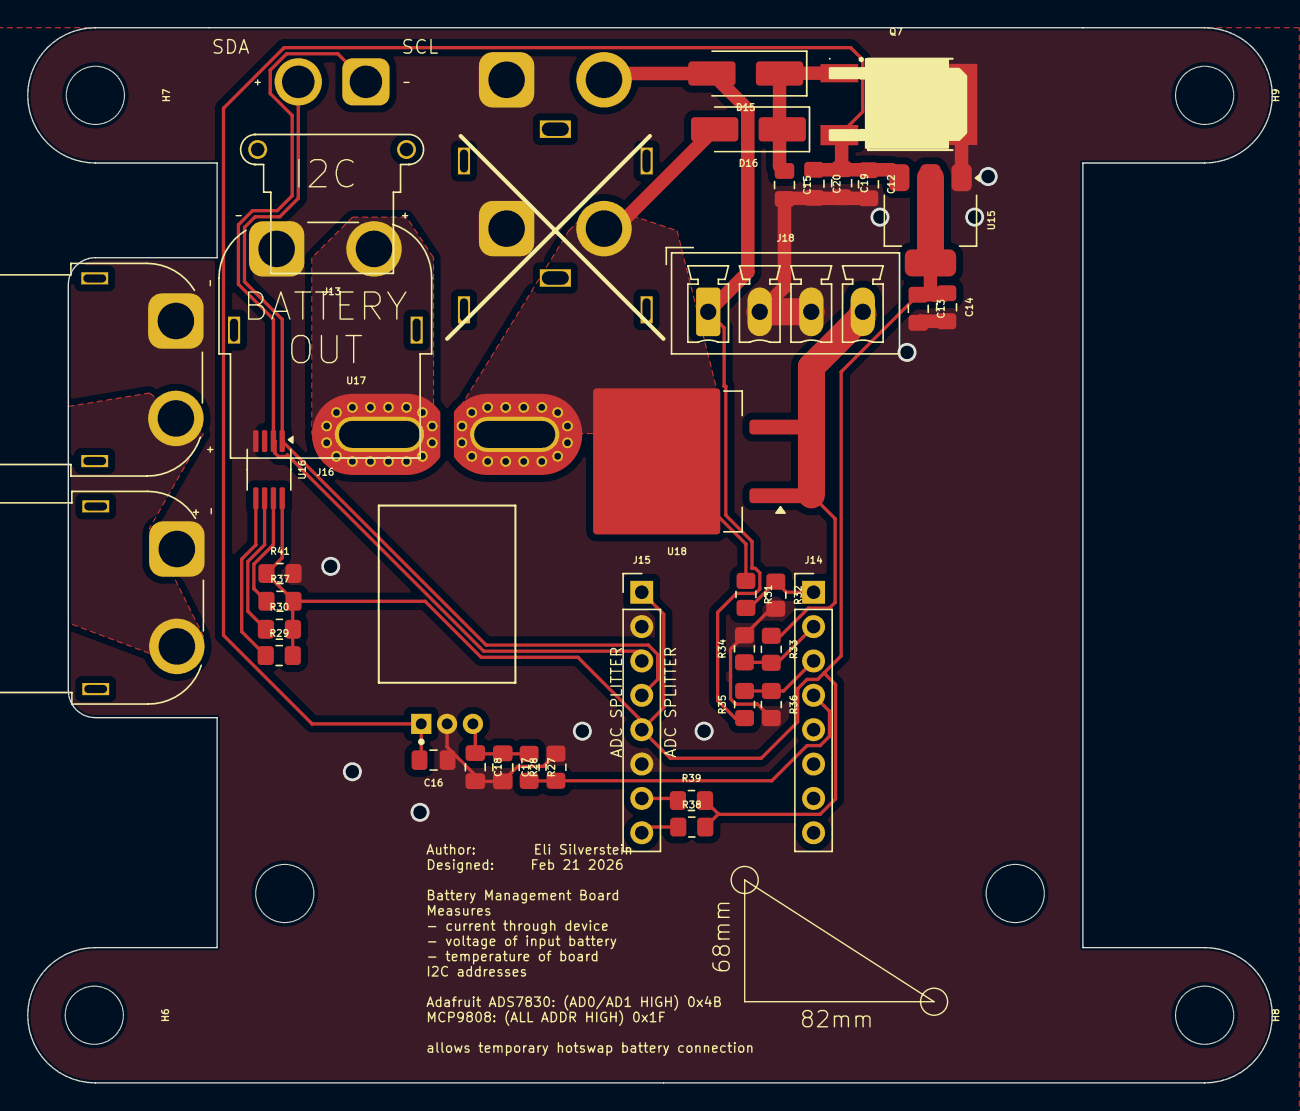
[picture p68: board Power_ManagementV3_diode.kicad_pcb from above]

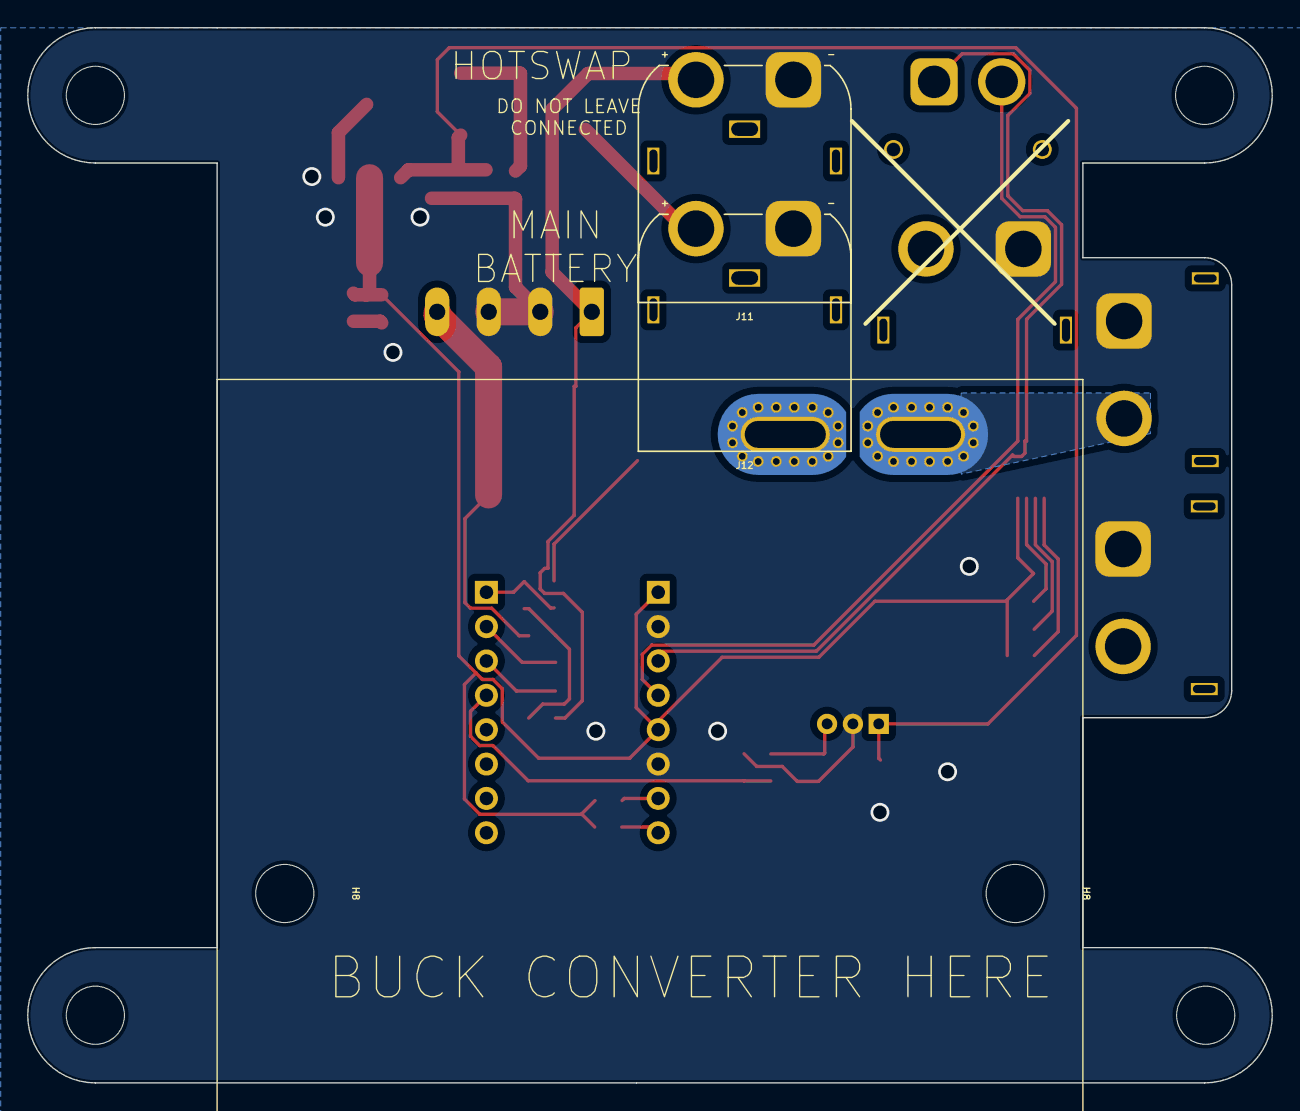
[picture p69: board Power_ManagementV3_diode.kicad_pcb from below]

Board: 2 copper layers, 92.0 x 78.0 mm, 45 parts (4 on the bottom side), 20 nets.

Parts:
C12, C13, C15, C19: 10uF; C_0805_2012Metric_Pad1.18x1.45mm_HandSolder
C14, C20: 1uF; C_0805_2012Metric_Pad1.18x1.45mm_HandSolder
C16: 0.1uF; C_0805_2012Metric_Pad1.18x1.45mm_HandSolder
C17: 100nF; C_0805_2012Metric_Pad1.18x1.45mm_HandSolder
C18: 1µF; C_0805_2012Metric_Pad1.18x1.45mm_HandSolder
D15, D16: SS54; D_SMA_Handsoldering
H6, H7, H8, H8#2, H8#3, H9: MountingHole; MountingHole_4.3mm_M4
J11, J12: Conn_01x02_Pin; AMASS_XT60IPW-M_1x03_P7.20mm_Horizontal
J13: Conn_01x02_Pin; AMASS_XT30PW-F_1x02_P2.50mm_Horizontal
J14, J15: Conn_01x08; PinHeader_1x08_P2.54mm_Vertical
J16, J21, J22: Conn_01x02_Pin; AMASS_XT60PW-F_1x02_P7.20mm_Horizontal
J18: Conn_01x04_Socket; PhoenixContact_MCV_1,5_4-G-3.81_1x04_P3.81mm_Vertical
Q7: L78M05ABDT-TR; TO-252-2_L6.5-W6.1-P4.58-LS10.0-TL
R27, R32, R34, R36, R41: 10k; R_0805_2012Metric_Pad1.20x1.40mm_HandSolder
R28: 20k; R_0805_2012Metric_Pad1.20x1.40mm_HandSolder
R29, R30, R37, R38, R39: 0R; R_0805_2012Metric_Pad1.20x1.40mm_HandSolder
R31, R33, R35: 47k; R_0805_2012Metric_Pad1.20x1.40mm_HandSolder
U15: AMS1117-3.3; SOT-223-3_TabPin2
U16: MCP9808_MSOP; MSOP-8_3x3mm_P0.65mm
U17: ACS758LCB-100U-PFF-T; Allegro_MicroSystems,_LLC-CB-5-PFF-0-0-MFG
U18: SRT60L100DC-R; TO-263-2

Connections:
+3.3V_: C13.1, C14.1, J15.1, J15.5, R29.2, R30.2, R37.2, R38.2, R39.2, R41.1, U15.2 (VO), U16.8 (V_{DD})
+5V_: C12.1, C16.2, C19.1, C20.1, Q7.3 (OUT), U15.3 (VI), U17.1 (VCC)
+BATT: D16.2 (A), J12.2, R31.1, U17.4 (IP+), U18.2 (Output)
+BATT_out: J16.2, J21.2, J22.2, U17.5 (IP-)
+EXT_LV_SUPPLY: J18.4, R33.1, U18.1 (Input), U18.3 (Input)
+TEMP_BATT: D15.2 (A), J11.2, J18.1, R35.1
/SCL: J13.1, J15.3, U16.2 (SCL)
/SDA: J13.2, J15.4, U16.1 (SDA)
GND_bak: C12.2, C13.2, C14.2, C15.2, C16.1, C17.2, C18.2, C19.2, C20.2, J11.1, J12.1, J15.2, J15.6, J16.1, J18.2, J18.3, J21.1, J22.1, Q7.4 (GND), R28.2, R32.2, R34.2, R36.2, R41.2, U15.1 (GND), U16.4 (GND), U17.2 (GND)
unnamed: C15.1, D15.1 (K), D16.1 (K), Q7.1 (IN)
unnamed: J14.1, R31.2, R32.1
unnamed: J14.2, R33.2, R34.1
unnamed: J14.3, R35.2, R36.1
unnamed: J15.7, R39.1
unnamed: J15.8, R38.1
unnamed: R37.1, U16.7 (A0)
unnamed: R30.1, U16.6 (A1)
unnamed: R29.1, U16.5 (A2)
current_sensor_3v3: J14.4, R27.2, R28.1
current_sensor_5v: C17.1, C18.1, R27.1, U17.3 (VIOUT)
