ryos17/robosub-ee/gen2/PCBs/Battery_hot_swap/Battery_hot_swap.kicad_pcb

## KiCad design gen2/PCBs/Battery_hot_swap/Battery_hot_swap.kicad_pcb (2026-02-21, an earlier design)

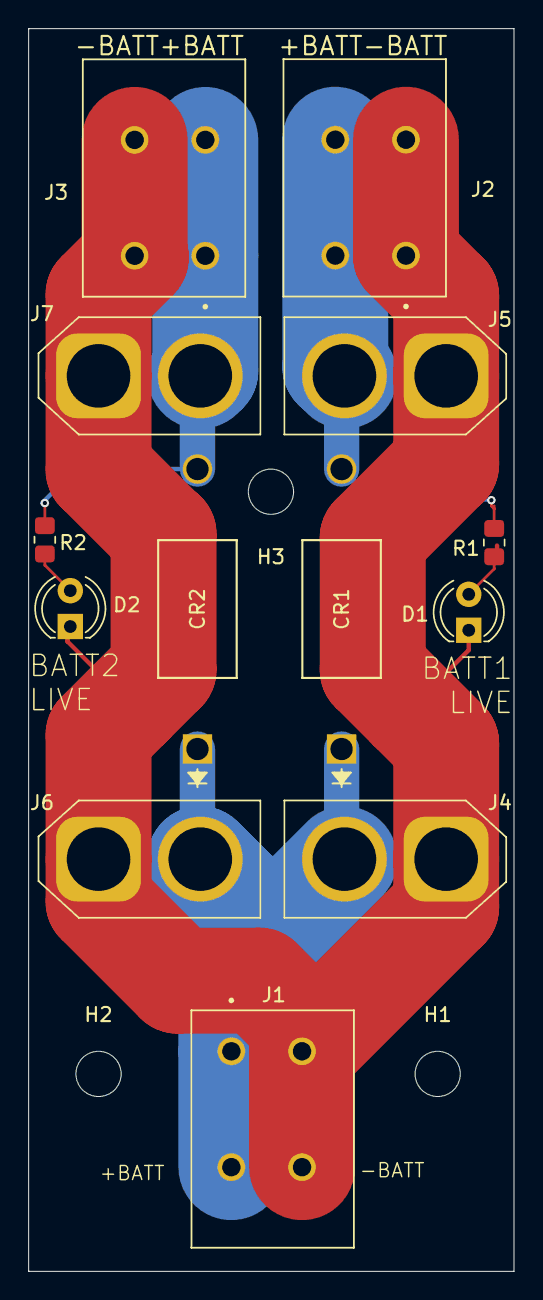
[picture p70: board Battery_hot_swap.kicad_pcb from above]

Board: 2 copper layers, 34.3 x 87.9 mm, 16 parts (0 on the bottom side), 6 nets.

Parts:
CR1, CR2: SB5100-T; DO-201AD_DIO
D1, D2: LED; LED_D4.0mm
H1, H2, H3: MountingHole; MountingHole_3.2mm_M3
J1, J2, J3: 1190297; PHOENIX_1190297
J4, J6: Conn_01x02_Pin; AMASS_XT60-M_1x02_P7.20mm_Vertical
J5, J7: Conn_01x02_Pin; AMASS_XT60-F_1x02_P7.20mm_Vertical
R1, R2: 740; R_0805_2012Metric_Pad1.20x1.40mm_HandSolder

Connections:
+BATT: CR1.1, CR2.1, J1.1_1, J1.1_2, J4.2, J6.2
+BATT1: CR1.2, J2.2_1, J2.2_2, J5.2, R1.1
+BATT2: CR2.2, J3.1_1, J3.1_2, J7.2, R2.1
-BATT: D1.1 (K), D2.1 (K), J1.2_1, J1.2_2, J2.1_1, J2.1_2, J3.2_1, J3.2_2, J4.1, J5.1, J6.1, J7.1
unnamed: D1.2 (A), R1.2
unnamed: D2.2 (A), R2.2
