ryos17/robosub-ee/gen2/PCBs/MLU_Breakout/MLU_Breakout.kicad_pcb

## KiCad design gen2/PCBs/MLU_Breakout/MLU_Breakout.kicad_pcb (2026-02-21, an earlier design)

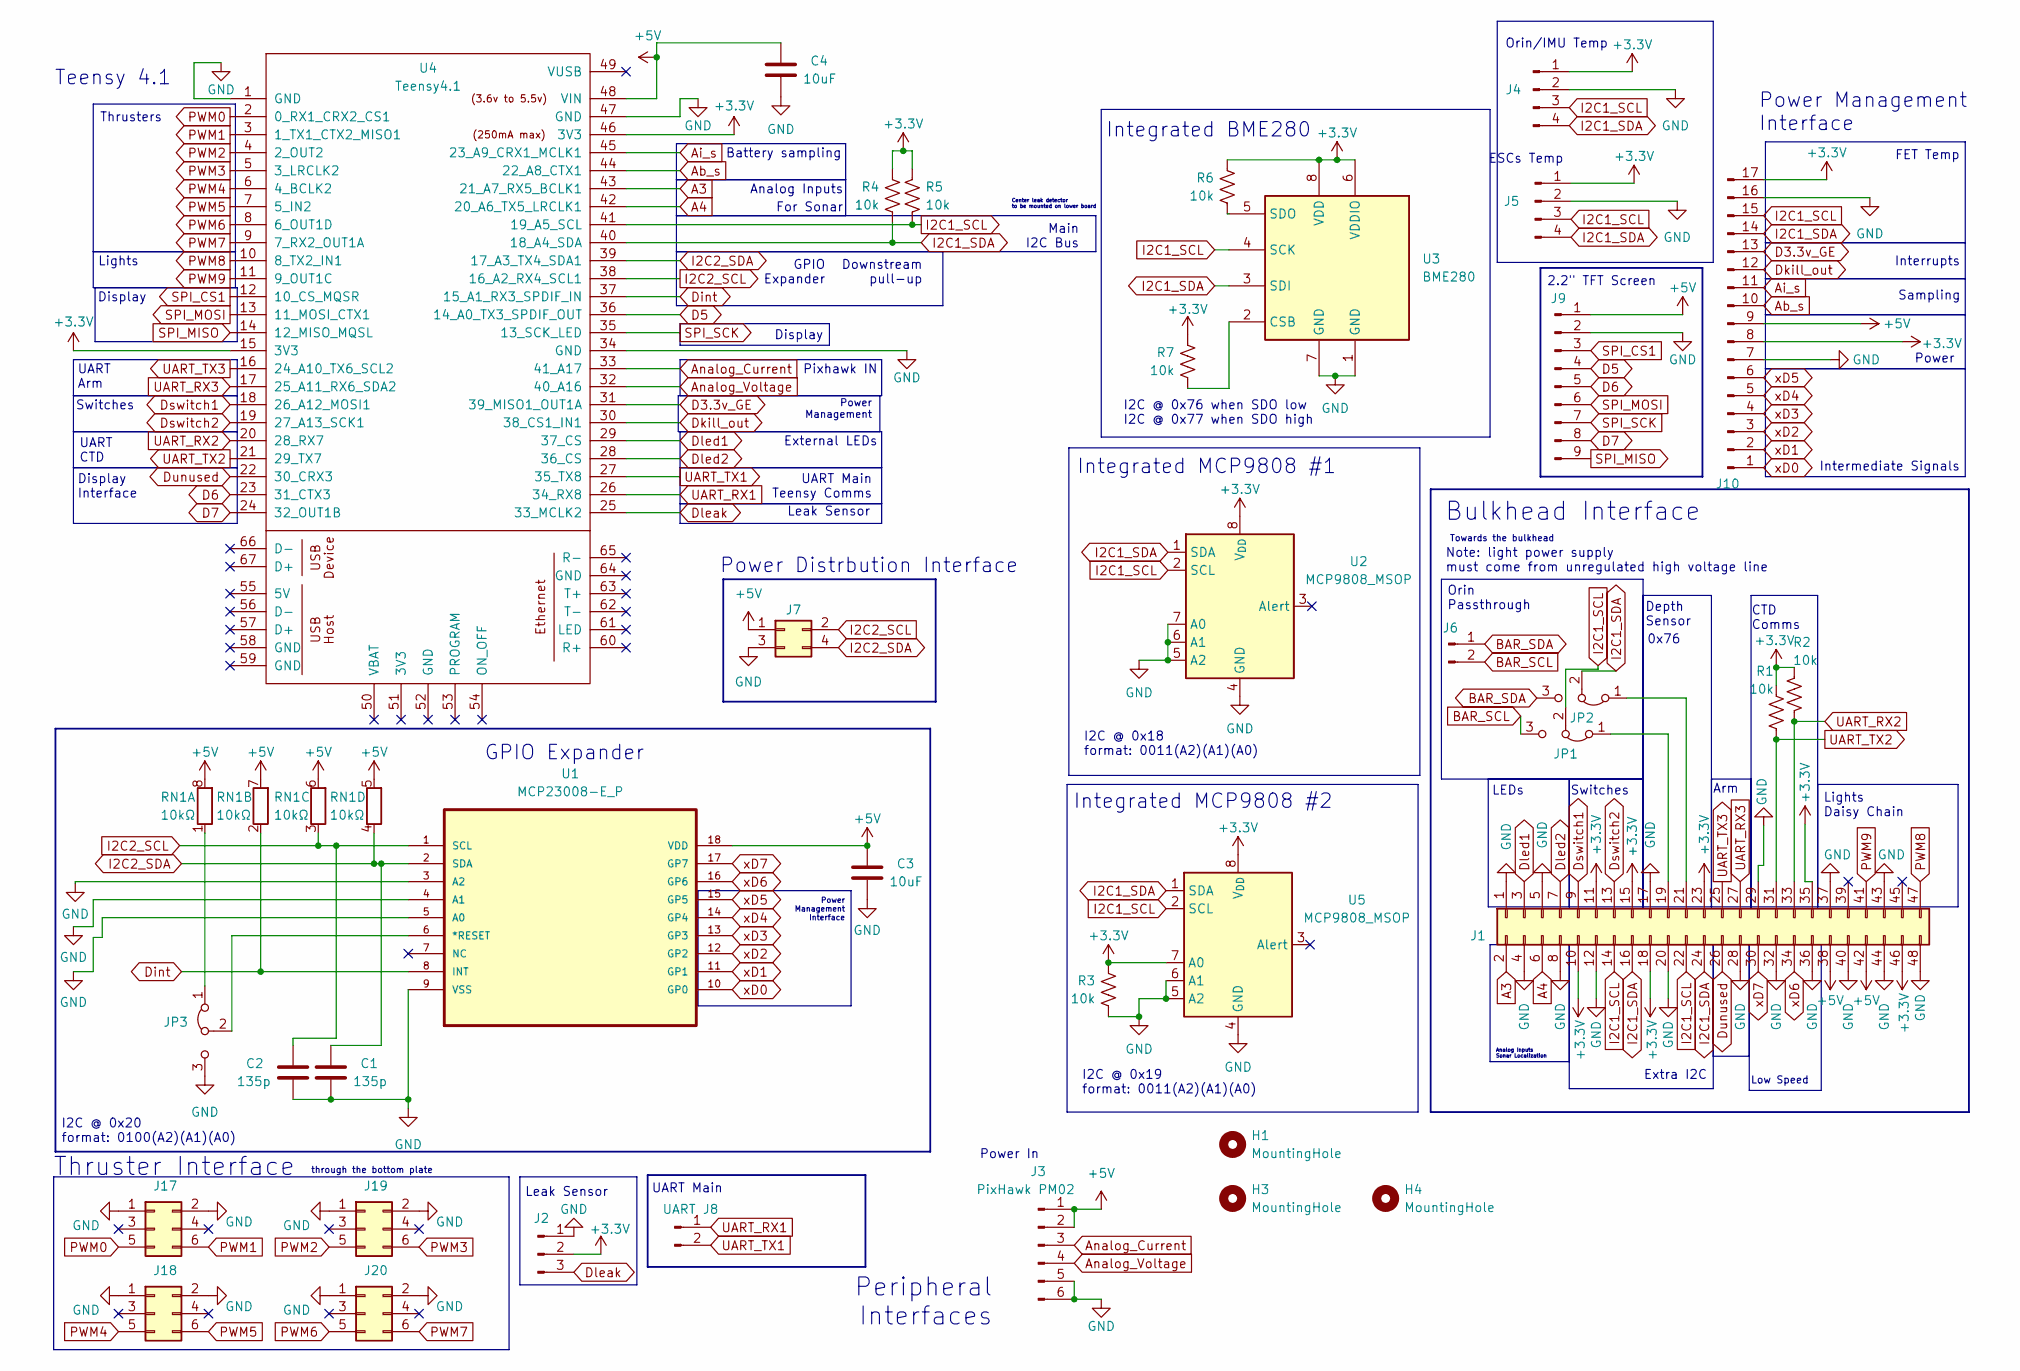
[picture p71: schematic MLU_Breakout.kicad_sch]

Parts:
C1, C2: 135p; C_0603_1608Metric_Pad1.08x0.95mm_HandSolder
C3, C4: 10uF; C_0805_2012Metric_Pad1.18x1.45mm_HandSolder
H1, H3, H4: MountingHole; MountingHole_3.2mm_M3
J1: Conn_02x24_Odd_Even; PinSocket_2x24_P2.54mm_Horizontal
J2: Conn_01x03_Pin; PinHeader_1x03_P2.54mm_Vertical
J3: PixHawk PM02; PinSocket_1x06_P2.54mm_Vertical
J4: BUS1; PinSocket_1x04_P2.54mm_Vertical
J5: BUS2; PinSocket_1x04_P2.54mm_Vertical
J6: Conn_01x02_Pin; PinHeader_1x02_P2.54mm_Vertical
J7: Conn_02x02_Odd_Even; PinHeader_2x02_P2.54mm_Vertical
J8: UART; PinSocket_1x02_P2.54mm_Vertical
J9: Conn_01x09_Pin; PinHeader_1x09_P2.54mm_Vertical
J10: Conn_01x17_Pin; PinHeader_1x17_P2.54mm_Horizontal
J17, J18, J19, J20: Conn_02x03_Odd_Even; PinHeader_2x03_P2.54mm_Vertical
JP1, JP2, JP3: Jumper_3_Bridged12; SolderJumper-3_P1.3mm_Bridged2Bar12_RoundedPad1.0x1.5mm
R1, R2, R3, R4, R5, R6, R7: 10k; R_0805_2012Metric_Pad1.20x1.40mm_HandSolder
RN1: 10kΩ; R_Array_Convex_4x0612; Mfr P/N CAY16-103J4LF
U1: MCP23008-E_P; MCP3008; MPN MCP23008-E/P
U2, U5: MCP9808_MSOP; MSOP-8_3x3mm_P0.65mm
U3: BME280
U4: Teensy4.1; Teensy41

Connections:
+3.3V: J1.10, J1.11, J1.15, J1.18, J1.23, J1.35, J1.46, J2.2, J4.1, J5.1, J10.8, J10.17, R1.1, R2.1, R3.1, R4.1, R5.1, R6.1, R7.1, U2.8 (V_{DD}), U3.6 (VDDIO), U3.8 (VDD), U4.15 (3V3), U4.46 (3V3), U5.7 (A0), U5.8 (V_{DD})
+5V: C3.1, C4.1, J1.38, J1.42, J3.1, J3.2, J7.1, J9.1, J10.9, RN1.5 (R4.2), RN1.6 (R3.2), RN1.7 (R2.2), RN1.8 (R1.2), U1.18 (VDD), U4.48 (VIN)
A3: J1.2, U4.43 (21_A7_RX5_BCLK1)
A4: J1.6, U4.42 (20_A6_TX5_LRCLK1)
Ab_s: J10.10, U4.44 (22_A8_CTX1)
Ai_s: J10.11, U4.45 (23_A9_CRX1_MCLK1)
Analog_Current: J3.3, U4.33 (41_A17)
Analog_Voltage: J3.4, U4.32 (40_A16)
BAR_SCL: J6.2, JP1.3 (B)
BAR_SDA: J6.1, JP2.3 (B)
D3.3v_GE: J10.13, U4.31 (39_MISO1_OUT1A)
D5: J9.4, U4.36 (14_A0_TX3_SPDIF_OUT)
D6: J9.5, U4.23 (31_CTX3)
D7: J9.8, U4.24 (32_OUT1B)
Dint: RN1.2 (R2.1), U1.8 (INT), U4.37 (15_A1_RX3_SPDIF_IN)
Dkill_out: J10.12, U4.30 (38_CS1_IN1)
Dleak: J2.3, U4.25 (33_MCLK2)
Dled1: J1.3, U4.29 (37_CS)
Dled2: J1.7, U4.28 (36_CS)
Dswitch1: J1.9, U4.18 (26_A12_MOSI1)
Dswitch2: J1.13, U4.19 (27_A13_SCK1)
Dunused: J1.26, U4.22 (30_CRX3)
GND: C1.2, C2.2, C3.2, C4.2, J1.1, J1.4, J1.5, J1.8, J1.12, J1.17, J1.20, J1.28, J1.29, J1.32, J1.36, J1.37, J1.40, J1.43, J1.44, J1.48, J2.1, J3.5, J3.6, J4.2, J5.2, J7.3, J9.2, J10.7, J10.16, J17.1, J17.2, J18.1, J18.2, J19.1, J19.2, J20.1, J20.2, JP3.3 (B), R3.2, U1.3 (A2), U1.4 (A1), U1.5 (A0), U1.9 (VSS), U2.4 (GND), U2.5 (A2), U2.6 (A1), U2.7 (A0), U3.1 (GND), U3.7 (GND), U4.1 (GND), U4.34 (GND), U4.47 (GND), U5.4 (GND), U5.5 (A2), U5.6 (A1)
I2C1_SCL: J1.14, J1.22, J4.3, J5.3, J10.15, JP1.2 (C), R5.2, U2.2 (SCL), U3.4 (SCK), U4.41 (19_A5_SCL), U5.2 (SCL)
I2C1_SDA: J1.16, J1.24, J4.4, J5.4, J10.14, JP2.2 (C), R4.2, U2.1 (SDA), U3.3 (SDI), U4.40 (18_A4_SDA), U5.1 (SDA)
I2C2_SCL: C2.1, J7.2, RN1.3 (R3.1), U1.1 (SCL), U4.38 (16_A2_RX4_SCL1)
I2C2_SDA: C1.1, J7.4, RN1.4 (R4.1), U1.2 (SDA), U4.39 (17_A3_TX4_SDA1)
unnamed: J1.19, JP1.1 (A)
unnamed: J1.21, JP2.1 (A)
unnamed: JP3.1 (A), RN1.1 (R1.1)
unnamed: JP3.2 (C), U1.6 (*RESET)
unnamed: R7.2, U3.2 (CSB)
unnamed: R6.2, U3.5 (SDO)
PWM0: J17.5, U4.2 (0_RX1_CRX2_CS1)
PWM1: J17.6, U4.3 (1_TX1_CTX2_MISO1)
PWM2: J19.5, U4.4 (2_OUT2)
PWM3: J19.6, U4.5 (3_LRCLK2)
PWM4: J18.5, U4.6 (4_BCLK2)
PWM5: J18.6, U4.7 (5_IN2)
PWM6: J20.5, U4.8 (6_OUT1D)
PWM7: J20.6, U4.9 (7_RX2_OUT1A)
PWM8: J1.47, U4.10 (8_TX2_IN1)
PWM9: J1.41, U4.11 (9_OUT1C)
SPI_CS1: J9.3, U4.12 (10_CS_MQSR)
SPI_MISO: J9.9, U4.14 (12_MISO_MQSL)
SPI_MOSI: J9.6, U4.13 (11_MOSI_CTX1)
SPI_SCK: J9.7, U4.35 (13_SCK_LED)
UART_RX1: J8.1, U4.26 (34_RX8)
UART_RX2: J1.33, R2.2, U4.20 (28_RX7)
UART_RX3: J1.27, U4.17 (25_A11_RX6_SDA2)
UART_TX1: J8.2, U4.27 (35_TX8)
UART_TX2: J1.31, R1.2, U4.21 (29_TX7)
UART_TX3: J1.25, U4.16 (24_A10_TX6_SCL2)
xD0: J10.1, U1.10 (GP0)
xD1: J10.2, U1.11 (GP1)
xD2: J10.3, U1.12 (GP2)
xD3: J10.4, U1.13 (GP3)
xD4: J10.5, U1.14 (GP4)
xD5: J10.6, U1.15 (GP5)
xD6: J1.34, U1.16 (GP6)
xD7: J1.30, U1.17 (GP7)

Notes on the sheet:
UART Main Teensy Comms
Switches
Display Interface
Power Management Interface
For Sonar
Teensy 4.1
Thrusters
Arm
Center leak detector to be mounted on lower board
ESCs Temp
Intermediate Signals
Battery sampling
Lights
Power Management
Lights Daisy Chain
Peripheral Interfaces
Power Distrbution Interface
Integrated BME280
Display
GPIO Expander
Extra I2C
Power
Note: light power supply must come from unregulated high voltage line
I2C @ 0x76 when SDO low I2C @ 0x77 when SDO high
Bulkhead Interface
Low Speed
Sampling
Leak Sensor
Pixhawk IN
Orin/IMU Temp
External LEDs
I2C @ 0x18 format: 0011(A2)(A1)(A0)
I2C @ 0x19 format: 0011(A2)(A1)(A0)
Power In
Thruster Interface
Analog Inputs Sonar Localization
Interrupts
Downstream pull-up
UART Main
CTD Comms
GPIO Expander
Power Management Interface
I2C @ 0x20 format: 0100(A2)(A1)(A0)
UART CTD
0x76
Main I2C Bus
Integrated MCP9808 #1
Orin Passthrough
LEDs
Integrated MCP9808 #2
UART Arm
through the bottom plate
FET Temp
Analog Inputs
Towards the bulkhead
2.2" TFT Screen
Depth Sensor

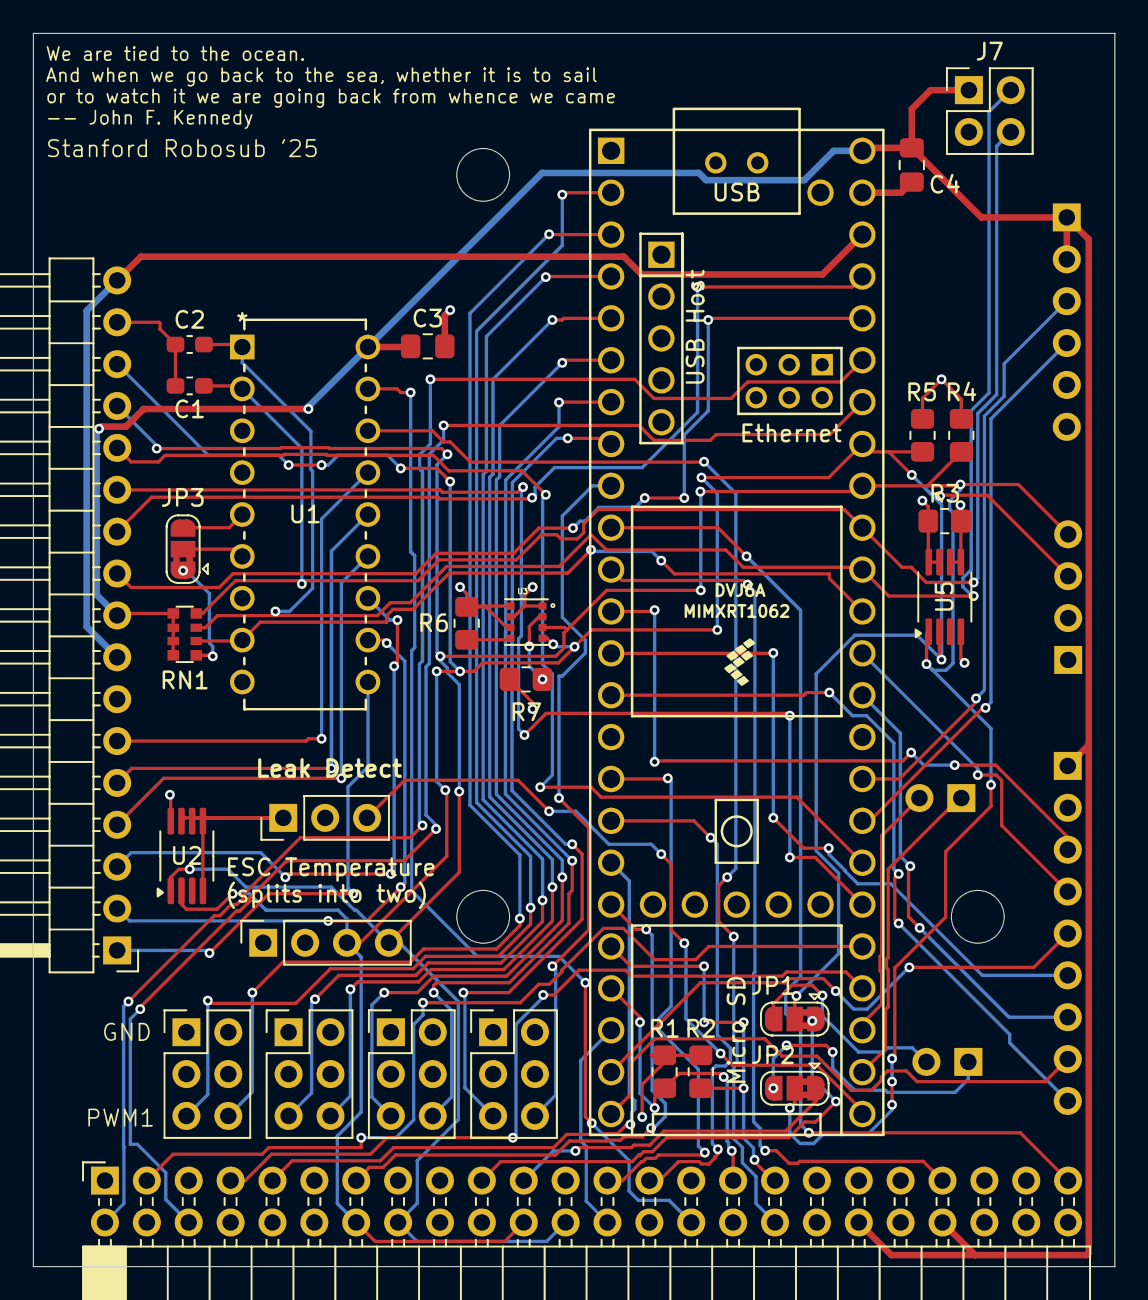
[picture p72: board MLU_Breakout.kicad_pcb from above]

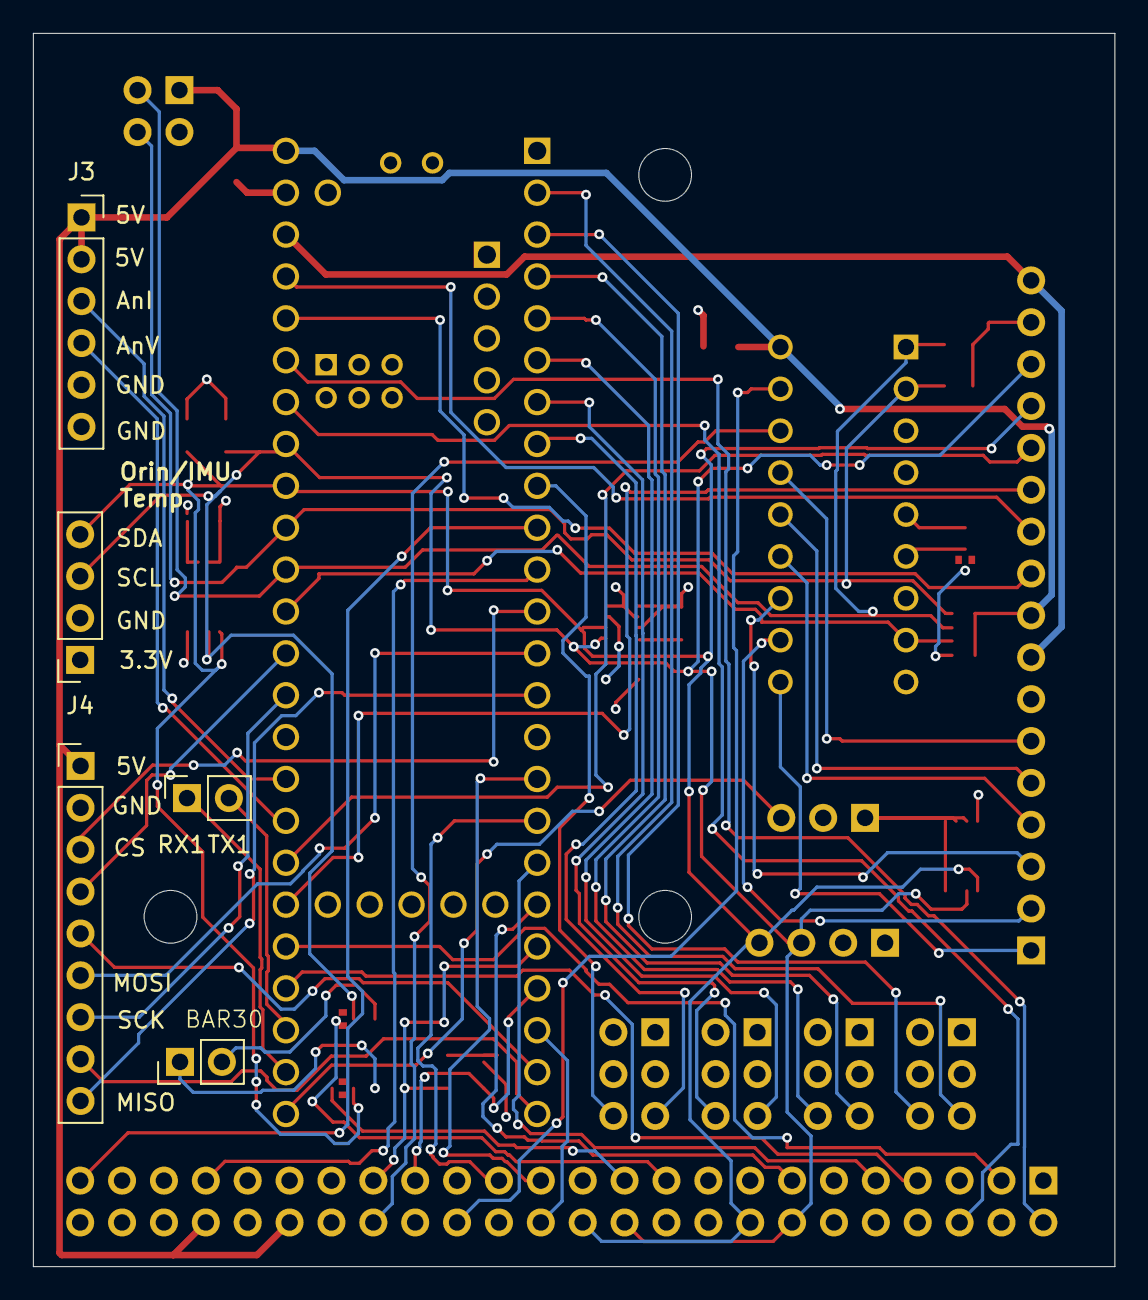
[picture p73: board MLU_Breakout.kicad_pcb from below]

Board: 4 copper layers, 65.6 x 74.8 mm, 37 parts (5 on the bottom side), 61 nets.
