ryos17/robosub-ee/gen2/PCBs/Power_ManagementV2/Power_ManagementV2.kicad_pcb

## KiCad design gen2/PCBs/Power_ManagementV2/Power_ManagementV2.kicad_pcb (2026-02-21, an earlier design)

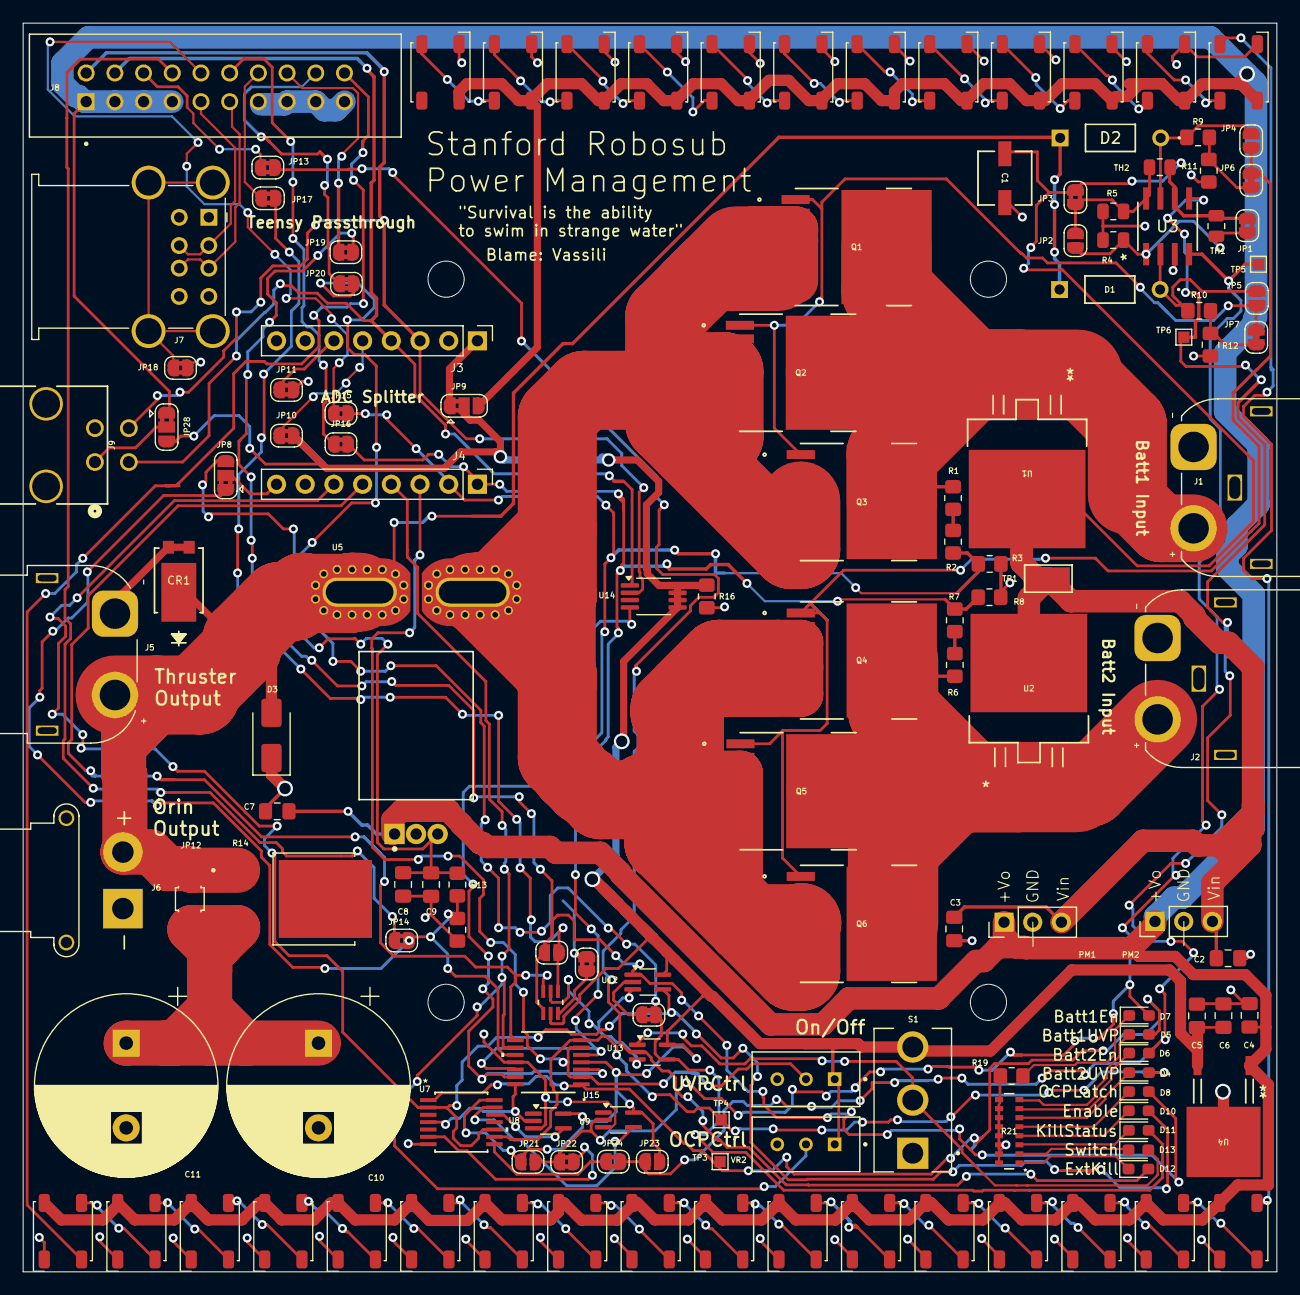
[picture p74: board Power_ManagementV2.kicad_pcb from above]

Board: 2 copper layers, 110.9 x 110.5 mm, 143 parts (0 on the bottom side), 98 nets.

Parts:
C1: 10uF; CAP_EEE-1CA100SR_PAN
C2, C3, C4, C5: 10uF; C_0805_2012Metric_Pad1.18x1.45mm_HandSolder
C6: 1uF; C_0805_2012Metric_Pad1.18x1.45mm_HandSolder
C7: 0.1u; C_0805_2012Metric_Pad1.18x1.45mm_HandSolder
C8: 100nF; C_0805_2012Metric_Pad1.18x1.45mm_HandSolder
C9: 1µF; C_0805_2012Metric_Pad1.18x1.45mm_HandSolder
C10, C11: 10,000uF; CP_Radial_D16.0mm_P7.50mm
CR1: SBRT15U50SP5-13; POWERDI5_DIO
D1, D2: D_Zener; 1N5242B
D3: TVS; D_SMA
D4, D5, D6, D7, D8, D10, D11, D12, D13: GreenLED; LED_0603_1608Metric_Pad1.05x0.95mm_HandSolder
H1, H2, H3, H4: MountingHole; MountingHole_3.2mm_M3
J1, J2: Conn_01x02_Pin; AMASS_XT60IPW-M_1x03_P7.20mm_Horizontal
J3, J4: Conn_01x08; PinHeader_1x08_P2.54mm_Vertical
J5: Conn_01x02_Pin; AMASS_XT60PW-F_1x02_P7.20mm_Horizontal
J6: Conn_01x02_Pin; AMASS_XT30PW-F_1x02_P2.50mm_Horizontal
J7: USB_A_Stacked; USB_A_Wuerth_61400826021_Horizontal_Stacked
J8: SBH11-PBPC-D10-ST-BK; SULLINS_SBH11-PBPC-D10-ST-BK
J9: Conn_01x04_Pin; CONN_SD-43045-008_04_MOL
JP1, JP3: SolderJumper_2_Bridged; SolderJumper-2_P1.3mm_Bridged2Bar_RoundedPad1.0x1.5mm
JP2: SolderJumper_2_Open; SolderJumper-2_P1.3mm_Open_RoundedPad1.0x1.5mm
JP4, JP5, JP21, JP23, JP26: Jumper_2_Open; SolderJumper-2_P1.3mm_Open_RoundedPad1.0x1.5mm
JP6, JP7: Jumper_2_Bridged; SolderJumper-2_P1.3mm_Bridged_RoundedPad1.0x1.5mm
JP8, JP9, JP28: Jumper_3_Bridged12; SolderJumper-3_P1.3mm_Bridged2Bar12_RoundedPad1.0x1.5mm
JP10, JP11, JP13, JP14, JP15, JP16, JP17, JP18, JP19, JP20, JP22, JP24, JP25, JP27: Jumper_2_Bridged; SolderJumper-2_P1.3mm_Bridged2Bar_RoundedPad1.0x1.5mm
JP12: Jumper_2_Open; KEYSTONE_5102
LED1, LED2, LED3, LED4, LED5, LED6, LED7, LED8, LED9, LED10, LED11, LED12, LED13, LED14, LED15, LED16, LED17, LED18, LED19, LED20, LED21, LED22, LED23, LED24, LED25, LED26, LED27, LED28, LED29: 1655; LED_LiteOn_LTST-E563C_PLCC4_5.0x5.0mm_P3.2mm_HandSoldering
PM1, PM2: LMS78
Q1, Q2, Q3, Q4, Q5, Q6: MCTL160N15Y-TP; TOLL-8L_MCC
R1, R6: 50k; R_0805_2012Metric_Pad1.20x1.40mm_HandSolder
R2, R3, R7, R8, R16: 10k; R_0805_2012Metric_Pad1.20x1.40mm_HandSolder
R4, R5: 100k; R_0805_2012Metric
R9, R10: 12k; R_0805_2012Metric_Pad1.20x1.40mm_HandSolder
R11, R12: 86.6k; R_0805_2012Metric_Pad1.20x1.40mm_HandSolder
R13: 2.2k; R_0805_2012Metric_Pad1.20x1.40mm_HandSolder
R14: 0.5 Ohm 25W; TO508P1229X317-3N
R15: 3.9k; R_0805_2012Metric_Pad1.20x1.40mm_HandSolder
R19: 100; R_0805_2012Metric_Pad1.20x1.40mm_HandSolder
R21: 100 Ohm; 2506_8x_Resistor_Array
S1: 100SP1T1B4M2QE; SW_100SP1T1B4M2QE
TH1, TH2: Thermistor_US; R_0805_2012Metric
TP1: DiodeRegSupply; TestPoint_Keystone_5019_Minature
TP3, TP4, TP5, TP6: TestPoint; TestPoint_Pad_1.0x1.0mm
U1, U2: STPS5045SG-TR; D2PAK_STM
U3: LTC1255CS8-PBF; LTC1255
U4: BA033CC0FP-E2; TO252-3_ROM
U5: ACS758LCB-100U-PFF-T; Allegro_MicroSystems,_LLC-CB-5-PFF-0-0-MFG
U7: 74VHC21FT; TSSOP14B
U8, U9: 74AHC1G04; SOT-353_SC-70-5_Handsoldering
U11: SN74LVC1G373DCKR; SN74LVC
U12, U13: 74LVC1G08; SOT-353_SC-70-5_Handsoldering
U14: MCP9808_MSOP; MSOP-8_3x3mm_P0.65mm
U15: TSX634AIPT; TSSOP14_STM
VR1, VR2: 3296W-1-103RLF; TRIM_3296W-1-103RLF

Connections:
+3.3V: C5.1, C6.1, JP9.2 (C), JP10.2 (B), JP21.2 (B), JP23.2 (B), JP28.3 (B), R16.1, S1.3, U4.3 (OUT), U7.14 (Vcc), U8.5 (VCC), U9.5 (VCC), U11.5 (VCC), U12.5 (VCC), U13.5 (VCC), U14.5 (A2), U14.6 (A1), U14.7 (A0), U14.8 (V_{DD}), U15.4 (VCC+), VR1.1, VR2.1
+5V: C4.1, C7.2, J8.1, J8.3, J8.5, J8.7, JP9.3 (B), JP28.1 (A), LED1.3 (VDD), LED2.3 (VDD), LED3.3 (VDD), LED4.3 (VDD), LED5.3 (VDD), LED6.3 (VDD), LED7.3 (VDD), LED8.3 (VDD), LED9.3 (VDD), LED10.3 (VDD), LED11.3 (VDD), LED12.3 (VDD), LED13.3 (VDD), LED14.3 (VDD), LED15.3 (VDD), LED16.3 (VDD), LED17.3 (VDD), LED18.3 (VDD), LED19.3 (VDD), LED20.3 (VDD), LED21.3 (VDD), LED22.3 (VDD), LED23.3 (VDD), LED24.3 (VDD), LED25.3 (VDD), LED26.3 (VDD), LED27.3 (VDD), LED28.3 (VDD), LED29.3 (VDD), PM1.3, PM2.3, U4.1 (Vcc), U5.1 (VCC)
+BATT: CR1.3, D1.2 (A), D2.2 (A), D3.2 (A), J5.2, J6.2, JP12.2 (B), R14.1, U5.5 (IP-)
+BATT1: J1.2, Q1.9 (D), Q2.9 (D), Q3.9 (D), R1.2, U1.1 (Input), U1.3 (Input)
+BATT2: J2.2, Q4.9 (D), Q5.9 (D), Q6.9 (D), R6.1, U2.1 (Input), U2.3 (Input)
+BATTHall: Q1.2 (S), Q1.3 (S), Q1.4 (S), Q1.5 (S), Q1.6 (S), Q1.7 (S), Q1.8 (S), Q2.2 (S), Q2.3 (S), Q2.4 (S), Q2.5 (S), Q2.6 (S), Q2.7 (S), Q2.8 (S), Q3.2 (S), Q3.3 (S), Q3.4 (S), Q3.5 (S), Q3.6 (S), Q3.7 (S), Q3.8 (S), Q4.2 (S), Q4.3 (S), Q4.4 (S), Q4.5 (S), Q4.6 (S), Q4.7 (S), Q4.8 (S), Q5.2 (S), Q5.3 (S), Q5.4 (S), Q5.5 (S), Q5.6 (S), Q5.7 (S), Q5.8 (S), Q6.2 (S), Q6.3 (S), Q6.4 (S), Q6.5 (S), Q6.6 (S), Q6.7 (S), Q6.8 (S), U5.4 (IP+)
+VregDiode: C1.1, C2.1, C3.1, JP1.2 (B), JP3.2 (B), PM1.1, PM2.1, TH1.1, TH2.1, TP1.1, U1.2 (Output), U2.2 (Output), U3.6 (VS)
-BATT1: C1.2, C2.2, C3.2, C4.2, C5.2, C6.2, C7.1, C8.2, C9.2, C10.2, C11.2, CR1.1, CR1.2, D3.1 (K), J1.1, J2.1, J3.2, J5.1, J6.1, J7.4 (GND1), J7.8 (GND2), J8.13, J8.15, J8.17, J8.19, J9.2, JP11.2 (B), JP18.1 (A), JP25.1 (A), LED1.1 (VSS), LED2.1 (VSS), LED3.1 (VSS), LED4.1 (VSS), LED5.1 (VSS), LED6.1 (VSS), LED7.1 (VSS), LED8.1 (VSS), LED9.1 (VSS), LED10.1 (VSS), LED11.1 (VSS), LED12.1 (VSS), LED13.1 (VSS), LED14.1 (VSS), LED15.1 (VSS), LED16.1 (VSS), LED17.1 (VSS), LED18.1 (VSS), LED19.1 (VSS), LED20.1 (VSS), LED21.1 (VSS), LED22.1 (VSS), LED23.1 (VSS), LED24.1 (VSS), LED25.1 (VSS), LED26.1 (VSS), LED27.1 (VSS), LED28.1 (VSS), LED29.1 (VSS), PM1.2, PM2.2, R3.1, R4.1, R5.1, R8.1, R11.2, R12.2, R15.2, R16.2, R19.2, R21.9, R21.10, R21.11, R21.12, R21.13, R21.14, R21.15, R21.16, S1.1, U3.3 (GND), U4.2 (GND), U5.2 (GND), U7.7 (GND), U8.3 (GND), U9.3 (GND), U11.2 (GND), U12.3 (GND), U13.3 (GND), U14.4 (GND), U15.11 (VCC-), VR1.3, VR2.3
/Battery Control Logic/Batt1>UVP: D5.2 (A), TP3.1, U7.1 (1A), U15.1 (OUT1)
/Battery Control Logic/Batt2>UVP: D4.2 (A), TP4.1, U7.9 (2A), U15.7 (OUT2)
/Battery Control Logic/OCPReference: J4.4, U15.9 (IN3-), VR2.2
/Battery Control Logic/UVPReference: J4.3, U15.2 (IN1-), U15.6 (IN2-), VR1.2
/Battery Control Logic/VBatt1<VBatt2: U7.4 (1C), U8.2, U15.14 (OUT4)
/Battery Control Logic/~GateDisable: D10.2 (A), J4.6, U7.2 (1B), U7.10 (2B), U12.4
/Battery Control Logic/~OCP: J4.5, U11.3 (D), U15.8 (OUT3)
Analog_Current: J8.8, JP14.1 (A)
Analog_Voltage1: J8.10, JP15.1 (A)
Batt1Enable: D7.2 (A), JP21.1 (A), JP22.2 (B), TP5.1, U3.4 (IN1), U9.2
Batt1Gate: JP5.1 (A), JP7.2 (B), Q1.1 (G), Q2.1 (G), Q3.1 (G)
Batt1GatePreDiv: D1.1 (K), JP5.2 (B), R10.1, U3.2 (GATE1)
Batt2Enable: D6.2 (A), JP23.1 (A), JP24.2 (B), TP6.1, U3.5 (IN2)
Batt2Gate: JP4.1 (A), JP6.2 (B), Q4.1 (G), Q5.1 (G), Q6.1 (G)
Batt2GatePreDiv: D2.1 (K), JP4.2 (B), R9.1, U3.7 (GATE2)
COM: J3.6, JP11.1 (A)
Device_D+: J7.3 (D1+), J7.7 (D2+), J8.11
Device_D-: J7.2 (D1-), J7.6 (D2-), J8.9
Dswitch2: J8.6, JP13.1 (A)
D/A20: J8.18, JP20.1 (A)
D/A21: J8.16, JP19.1 (A)
D/A22: J8.14, JP17.1 (A)
D/A23: J8.12, JP16.1 (A)
I2C1_SCL: J3.3, J8.2, J9.4, U14.2 (SCL)
I2C1_SDA: J3.4, J8.4, J9.3, U14.1 (SDA)
ISample3.3V: JP8.1 (A), JP14.2 (B), R13.2, R15.1, U15.10 (IN3+)
ISample5V: C8.1, C9.1, JP8.3 (B), R13.1, U5.3 (VIOUT)
KillSwitch: D12.2 (A), JP13.2 (B), U13.2
LETeensy: JP17.2 (B), JP26.1 (A), U11.1 (LE)
NeoPass1: LED5.4 (DOUT), LED6.2 (DIN)
NeoPass2: LED10.4 (DOUT), LED11.2 (DIN)
NeoPass3: LED15.4 (DOUT), LED16.2 (DIN)
NeoPass4: LED20.4 (DOUT), LED21.2 (DIN)
NeoPass5: LED25.4 (DOUT), LED26.2 (DIN)
unnamed: D7.1 (K), R19.1
unnamed: D13.2 (A), S1.2, U13.1
unnamed: J3.1, JP9.1 (A)
unnamed: J4.8, JP8.2 (C)
unnamed: J7.9 (Shield), JP18.2 (B)
unnamed: J9.1, JP28.2 (C)
unnamed: JP1.1 (A), JP2.1 (A), R4.2, TH1.2, U3.1 (DS1)
unnamed: JP2.2 (B), JP3.1 (A), R5.2, TH2.2, U3.8 (DS2)
unnamed: JP6.1 (A), R9.2, R11.1
unnamed: JP7.1 (A), R10.2, R12.1
unnamed: C10.1, C11.1, JP12.1 (A), R14.2
unnamed: JP22.1 (A), U7.6 (1Y)
unnamed: JP24.1 (A), U7.8 (2Y)
unnamed: JP25.2 (B), U11.6 (*OE)
unnamed: JP27.2 (B), U12.2
unnamed: LED1.4 (DOUT), LED2.2 (DIN)
unnamed: LED2.4 (DOUT), LED3.2 (DIN)
unnamed: LED3.4 (DOUT), LED4.2 (DIN)
unnamed: LED4.4 (DOUT), LED5.2 (DIN)
unnamed: LED6.4 (DOUT), LED7.2 (DIN)
unnamed: LED7.4 (DOUT), LED8.2 (DIN)
unnamed: LED8.4 (DOUT), LED9.2 (DIN)
unnamed: LED9.4 (DOUT), LED10.2 (DIN)
unnamed: LED11.4 (DOUT), LED12.2 (DIN)
unnamed: LED12.4 (DOUT), LED13.2 (DIN)
unnamed: LED13.4 (DOUT), LED14.2 (DIN)
unnamed: LED14.4 (DOUT), LED15.2 (DIN)
unnamed: LED16.4 (DOUT), LED17.2 (DIN)
unnamed: LED17.4 (DOUT), LED18.2 (DIN)
unnamed: LED18.4 (DOUT), LED19.2 (DIN)
unnamed: LED19.4 (DOUT), LED20.2 (DIN)
unnamed: LED21.4 (DOUT), LED22.2 (DIN)
unnamed: LED22.4 (DOUT), LED23.2 (DIN)
unnamed: LED23.4 (DOUT), LED24.2 (DIN)
unnamed: LED24.4 (DOUT), LED25.2 (DIN)
unnamed: LED26.4 (DOUT), LED27.2 (DIN)
unnamed: LED27.4 (DOUT), LED28.2 (DIN)
unnamed: LED28.4 (DOUT), LED29.2 (DIN)
unnamed: R1.1, R2.1
unnamed: R6.2, R7.2
unnamed: U7.12 (2C), U8.4
unnamed: U7.13 (2D), U9.4
RArray1: D12.1 (K), R21.1
RArray2: D13.1 (K), R21.2
RArray3: D11.1 (K), R21.3
RArray4: D10.1 (K), R21.4
RArray5: D8.1 (K), R21.5
RArray6: D4.1 (K), R21.6
RArray7: D6.1 (K), R21.7
RArray8: D5.1 (K), R21.8
REF: J3.5, JP10.1 (A)
VSampleBatt1: J4.2, JP15.2 (B), R2.2, R3.2, U15.3 (IN1+), U15.13 (IN4-)
VSampleBatt2: J4.1, JP16.2 (B), R7.1, R8.2, U15.5 (IN2+), U15.12 (IN4+)
toNEO_CTRL_Orin: J8.20, LED1.2 (DIN)
~OCPLatch: D8.2 (A), JP19.2 (B), JP26.2 (B), U11.4 (Q), U12.1
~SystemKill: D11.2 (A), JP20.2 (B), JP27.1 (A), U13.4
