ryos17/robosub-ee/gen2/PCBs/Power_Management/Power_Management.kicad_pcb

## KiCad design gen2/PCBs/Power_Management/Power_Management.kicad_pcb (2026-02-21, an earlier design)

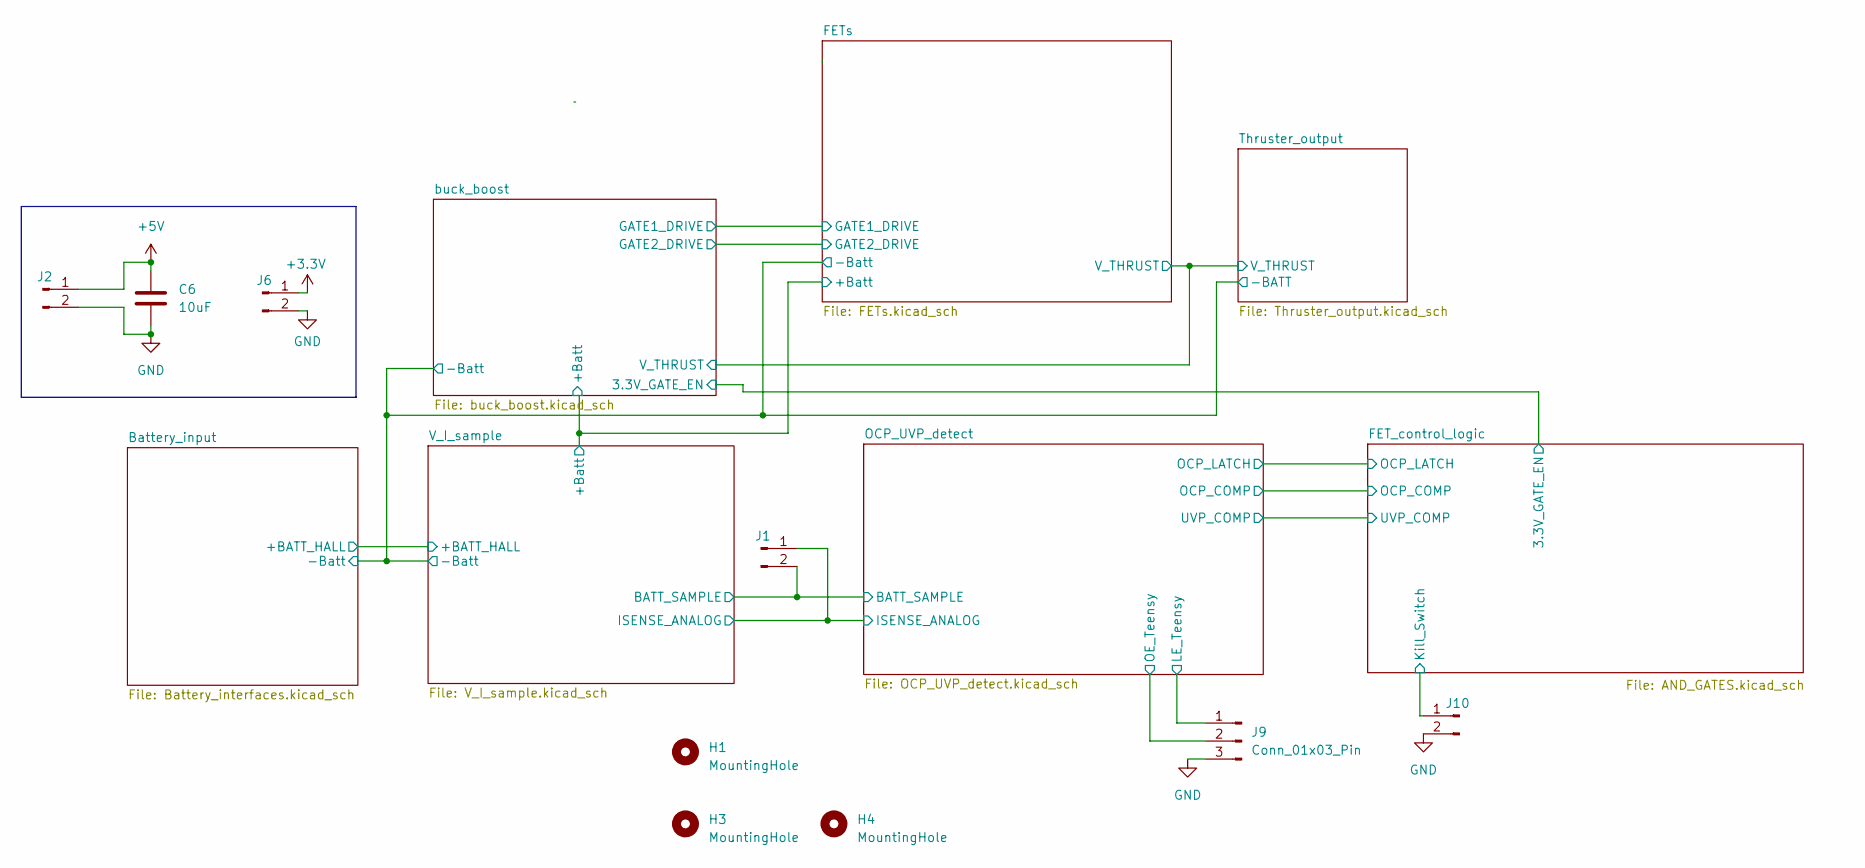
[picture p75: schematic Power_Management.kicad_sch, Test sheet]

Parts:
C6: 10uF; C_0805_2012Metric_Pad1.18x1.45mm_HandSolder
H1, H3, H4: MountingHole; MountingHole_3.2mm_M3
J1, J2, J6, J10: Conn_01x02_Pin; PinHeader_1x02_P2.54mm_Vertical
J9: Conn_01x03_Pin; PinHeader_1x03_P2.54mm_Vertical

Connections:
+3.3V: J6.1; also elsewhere on the board
+5V: C6.1, J2.1; also elsewhere on the board
/FET_control_logic/Kill_Switch: J10.1; also elsewhere on the board
/OCP_UVP_detect/BATT_SAMPLE: J1.2; also elsewhere on the board
/OCP_UVP_detect/ISENSE_ANALOG: J1.1; also elsewhere on the board
/OCP_UVP_detect/LE_Teensy: J9.1; also elsewhere on the board
/OCP_UVP_detect/OE_Teensy: J9.2; also elsewhere on the board
GND: C6.2, J2.2, J6.2, J9.3, J10.2; also elsewhere on the board

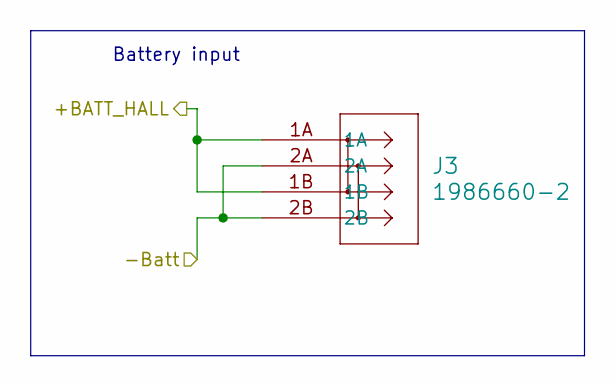
[picture p76: schematic Battery_interfaces.kicad_sch]

Parts:
J3: 1986660-2; CONN2_1986660-2_TEC

Connections:
/Battery_input/+BATT_HALL: J3.1A, J3.1B; also elsewhere on the board
/Battery_input/-Batt: J3.2A, J3.2B; also elsewhere on the board

Notes on the sheet:
Battery input

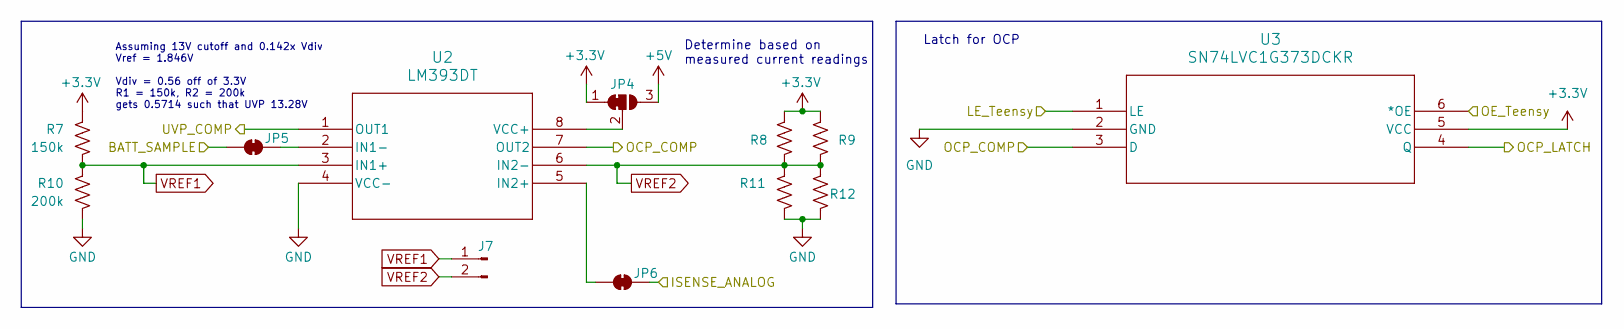
[picture p77: schematic OCP_UVP_detect.kicad_sch]

Parts:
J7: Conn_01x02_Pin; PinHeader_1x02_P2.54mm_Vertical
JP4: SolderJumper_3_Bridged12; SolderJumper-3_P1.3mm_Bridged2Bar12_RoundedPad1.0x1.5mm
JP5, JP6: SolderJumper_2_Bridged; SolderJumper-2_P1.3mm_Bridged_RoundedPad1.0x1.5mm
R7: 150k; R_0805_2012Metric_Pad1.20x1.40mm_HandSolder
R8, R9, R11, R12: R_0805_2012Metric_Pad1.20x1.40mm_HandSolder
R10: 200k; R_0805_2012Metric_Pad1.20x1.40mm_HandSolder
U2: LM393DT
U3: SN74LVC1G373DCKR; SN74LVC

Connections:
+3.3V: JP4.1 (A), R7.1, R8.1, R9.1, U3.5 (VCC); also elsewhere on the board
+5V: JP4.3 (B); also elsewhere on the board
/FET_control_logic/OCP_COMP: U2.7 (OUT2), U3.3 (D); also elsewhere on the board
/FET_control_logic/OCP_LATCH: U3.4 (Q); also elsewhere on the board
/FET_control_logic/UVP_COMP: U2.1 (OUT1); also elsewhere on the board
/OCP_UVP_detect/BATT_SAMPLE: JP5.1 (A); also elsewhere on the board
/OCP_UVP_detect/ISENSE_ANALOG: JP6.2 (B); also elsewhere on the board
/OCP_UVP_detect/LE_Teensy: U3.1 (LE); also elsewhere on the board
/OCP_UVP_detect/OE_Teensy: U3.6 (*OE); also elsewhere on the board
GND: R10.2, R11.2, R12.2, U2.4 (VCC-), U3.2 (GND); also elsewhere on the board
unnamed: JP4.2 (C), U2.8 (VCC+)
unnamed: JP5.2 (B), U2.2 (IN1-)
unnamed: JP6.1 (A), U2.5 (IN2+)
VREF1: J7.1, R7.2, R10.1, U2.3 (IN1+)
VREF2: J7.2, R8.2, R9.2, R11.1, R12.1, U2.6 (IN2-)

Notes on the sheet:
Determine based on measured current readings
Latch for OCP
Assuming 13V cutoff and 0.142x Vdiv Vref = 1.846V Vdiv = 0.56 off of 3.3V R1 = 150k, R2 = 200k gets 0.5714 such that UVP 13.28V

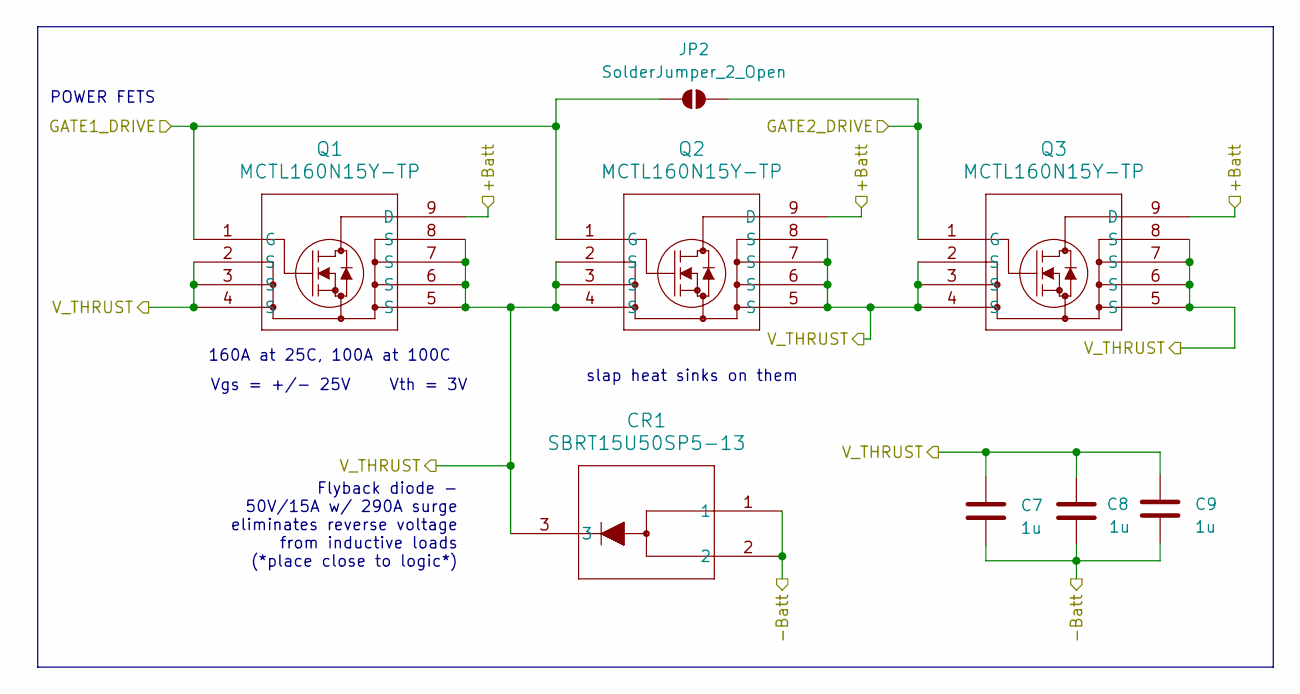
[picture p78: schematic FETs.kicad_sch]

Parts:
C7, C8, C9: 1u; U2-D_NCH
CR1: SBRT15U50SP5-13; POWERDI5_DIO
JP2: SolderJumper_2_Open; SolderJumper-2_P1.3mm_Open_RoundedPad1.0x1.5mm
Q1, Q2, Q3: MCTL160N15Y-TP; TOLL-8L_MCC

Connections:
/Battery_input/-Batt: C7.2, C8.2, C9.2, CR1.1, CR1.2; also elsewhere on the board
/FETs/+Batt: Q1.9 (D), Q2.9 (D), Q3.9 (D); also elsewhere on the board
/FETs/GATE1_DRIVE: JP2.1 (A), Q1.1 (G), Q2.1 (G); also elsewhere on the board
/FETs/GATE2_DRIVE: JP2.2 (B), Q3.1 (G); also elsewhere on the board
/FETs/V_THRUST: C7.1, C8.1, C9.1, CR1.3, Q1.2 (S), Q1.3 (S), Q1.4 (S), Q1.5 (S), Q1.6 (S), Q1.7 (S), Q1.8 (S), Q2.2 (S), Q2.3 (S), Q2.4 (S), Q2.5 (S), Q2.6 (S), Q2.7 (S), Q2.8 (S), Q3.2 (S), Q3.3 (S), Q3.4 (S), Q3.5 (S), Q3.6 (S), Q3.7 (S), Q3.8 (S); also elsewhere on the board

Notes on the sheet:
slap heat sinks on them
POWER FETS
Flyback diode - 50V/15A w/ 290A surge eliminates reverse voltage from inductive loads (*place close to logic*)
160A at 25C, 100A at 100C
Vgs = +/- 25V
Vth = 3V

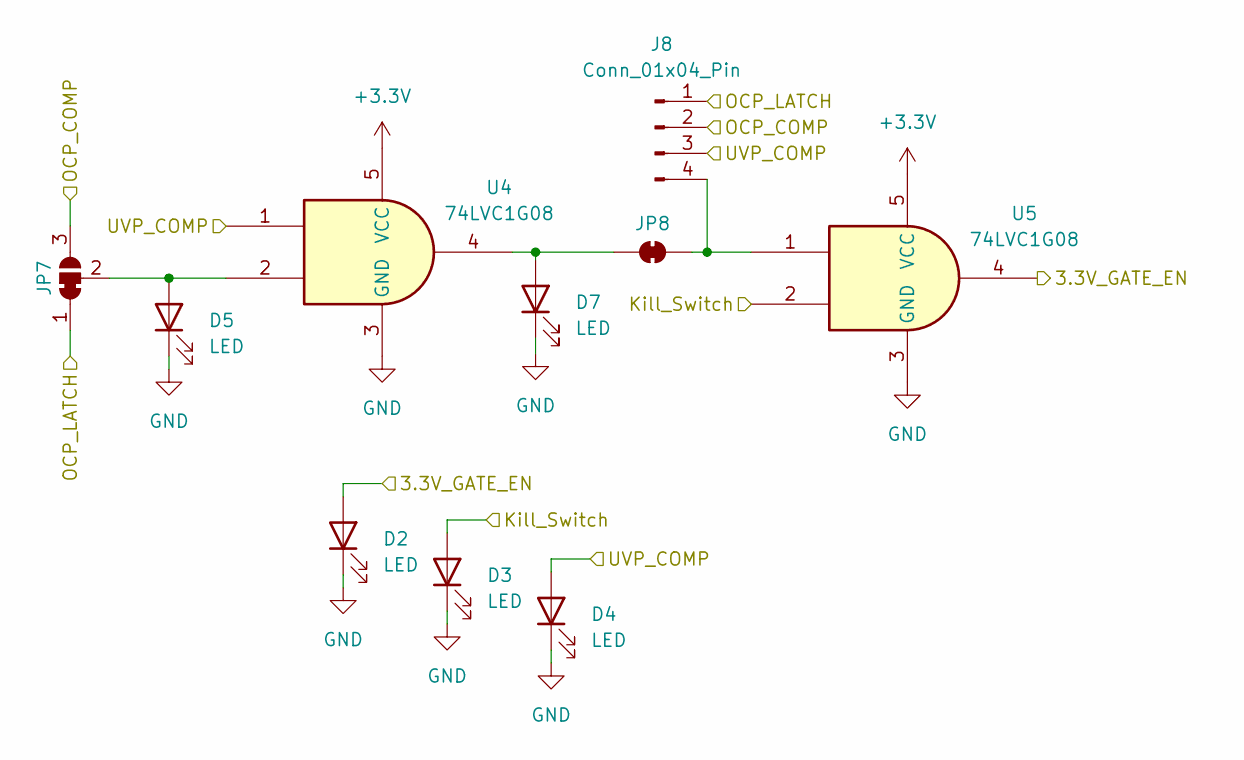
[picture p79: schematic AND_GATES.kicad_sch]

Parts:
D2, D3, D4, D5, D7: LED; LED_0805_2012Metric_Pad1.15x1.40mm_HandSolder
J8: Conn_01x04_Pin; PinHeader_1x04_P2.54mm_Vertical
JP7: SolderJumper_3_Bridged12; SolderJumper-3_P1.3mm_Bridged2Bar12_RoundedPad1.0x1.5mm
JP8: SolderJumper_2_Bridged; SolderJumper-2_P1.3mm_Bridged_RoundedPad1.0x1.5mm
U4, U5: 74LVC1G08; SOT-353_SC-70-5_Handsoldering

Connections:
+3.3V: U4.5 (VCC), U5.5 (VCC); also elsewhere on the board
/FET_control_logic/3.3V_GATE_EN: D2.2 (A), U5.4; also elsewhere on the board
/FET_control_logic/Kill_Switch: D3.2 (A), U5.2; also elsewhere on the board
/FET_control_logic/OCP_COMP: J8.2, JP7.3 (B); also elsewhere on the board
/FET_control_logic/OCP_LATCH: J8.1, JP7.1 (A); also elsewhere on the board
/FET_control_logic/UVP_COMP: D4.2 (A), J8.3, U4.1; also elsewhere on the board
GND: D2.1 (K), D3.1 (K), D4.1 (K), D5.1 (K), D7.1 (K), U4.3 (GND), U5.3 (GND); also elsewhere on the board
unnamed: D5.2 (A), JP7.2 (C), U4.2
unnamed: D7.2 (A), JP8.1 (A), U4.4
unnamed: J8.4, JP8.2 (B), U5.1

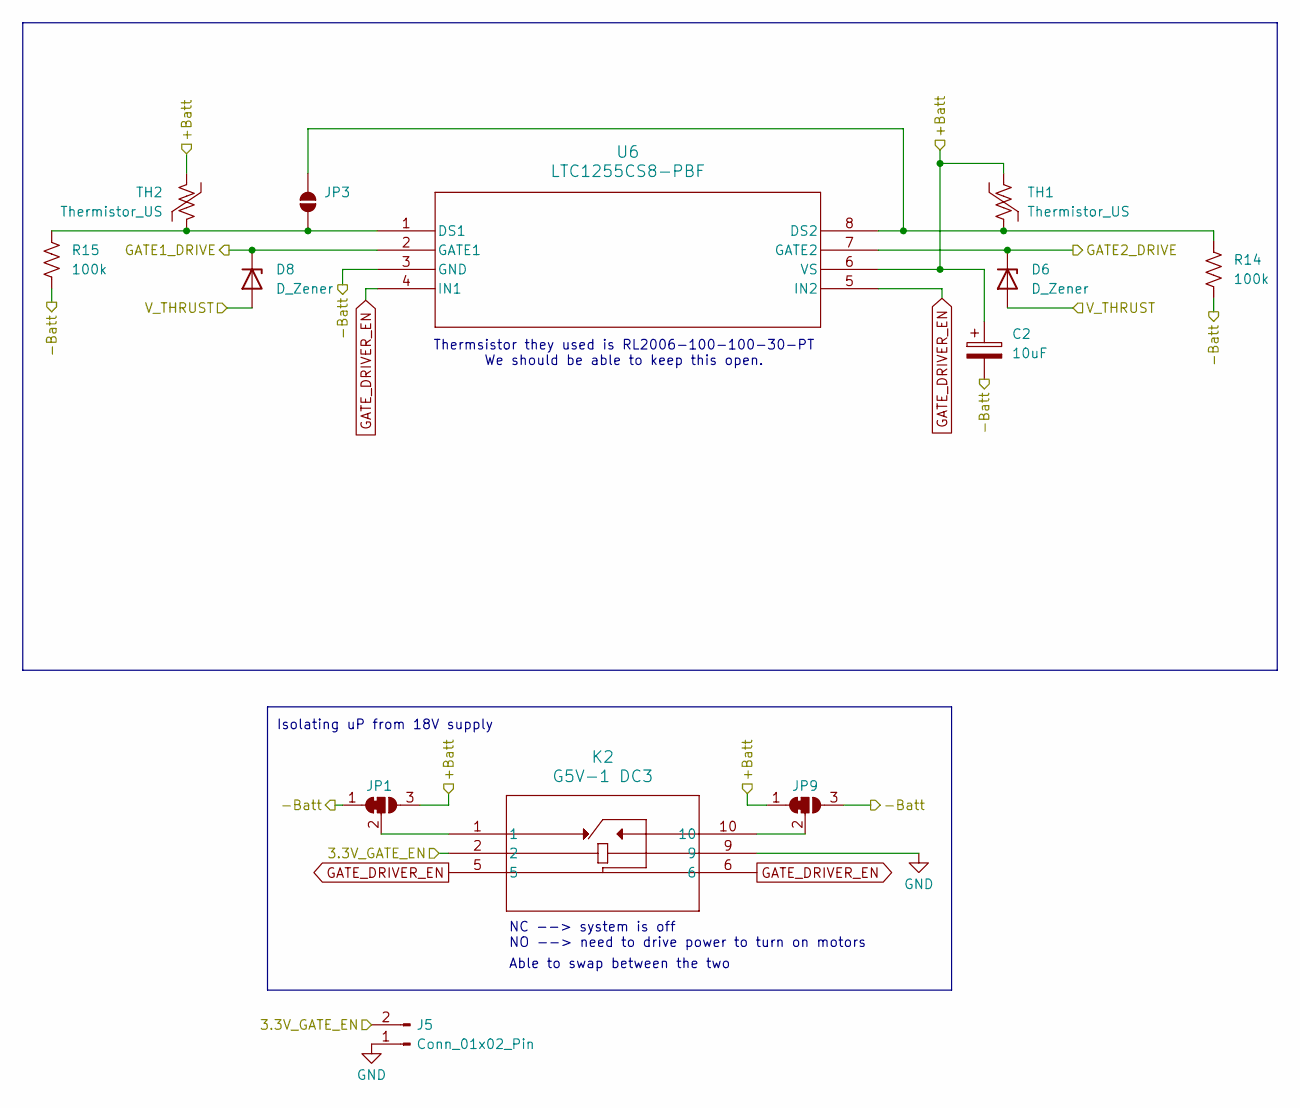
[picture p80: schematic buck_boost.kicad_sch]

Parts:
C2: 10uF; CAP_EEE-1CA100SR_PAN
D6, D8: D_Zener; 1N5242B
J5: Conn_01x02_Pin; PinHeader_1x02_P2.54mm_Vertical
JP1, JP9: SolderJumper_3_Bridged12; SolderJumper-3_P1.3mm_Bridged2Bar12_RoundedPad1.0x1.5mm
JP3: SolderJumper_2_Open; SolderJumper-2_P1.3mm_Open_RoundedPad1.0x1.5mm
K2: G5V-1 DC3; RELAY_G5V-1_OMR
R14, R15: 100k; R_0805_2012Metric
TH1, TH2: Thermistor_US; R_0805_2012Metric
U6: LTC1255CS8-PBF; LTC1255

Connections:
/Battery_input/-Batt: C2.2, JP1.1 (A), JP9.3 (B), R14.1, R15.1, U6.3 (GND); also elsewhere on the board
/FET_control_logic/3.3V_GATE_EN: J5.2, K2.2; also elsewhere on the board
/FETs/+Batt: C2.1, JP1.3 (B), JP9.1 (A), TH1.1, TH2.1, U6.6 (VS); also elsewhere on the board
/FETs/GATE1_DRIVE: D8.1 (K), U6.2 (GATE1); also elsewhere on the board
/FETs/GATE2_DRIVE: D6.1 (K), U6.7 (GATE2); also elsewhere on the board
/FETs/V_THRUST: D6.2 (A), D8.2 (A); also elsewhere on the board
GATE_DRIVER_EN: K2.5, K2.6, U6.4 (IN1), U6.5 (IN2)
GND: J5.1, K2.9; also elsewhere on the board
unnamed: JP1.2 (C), K2.1
unnamed: JP3.1 (A), R15.2, TH2.2, U6.1 (DS1)
unnamed: JP3.2 (B), R14.2, TH1.2, U6.8 (DS2)
unnamed: JP9.2 (C), K2.10

Notes on the sheet:
Able to swap between the two
Isolating uP from 18V supply
Thermsistor they used is RL2006-100-100-30-PT We should be able to keep this open.
NC --> system is off NO --> need to drive power to turn on motors

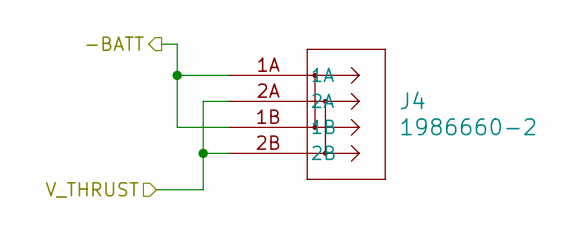
[picture p81: schematic Thruster_output.kicad_sch]

Parts:
J4: 1986660-2; CONN2_1986660-2_TEC

Connections:
/Battery_input/-Batt: J4.1A, J4.1B; also elsewhere on the board
/FETs/V_THRUST: J4.2A, J4.2B; also elsewhere on the board

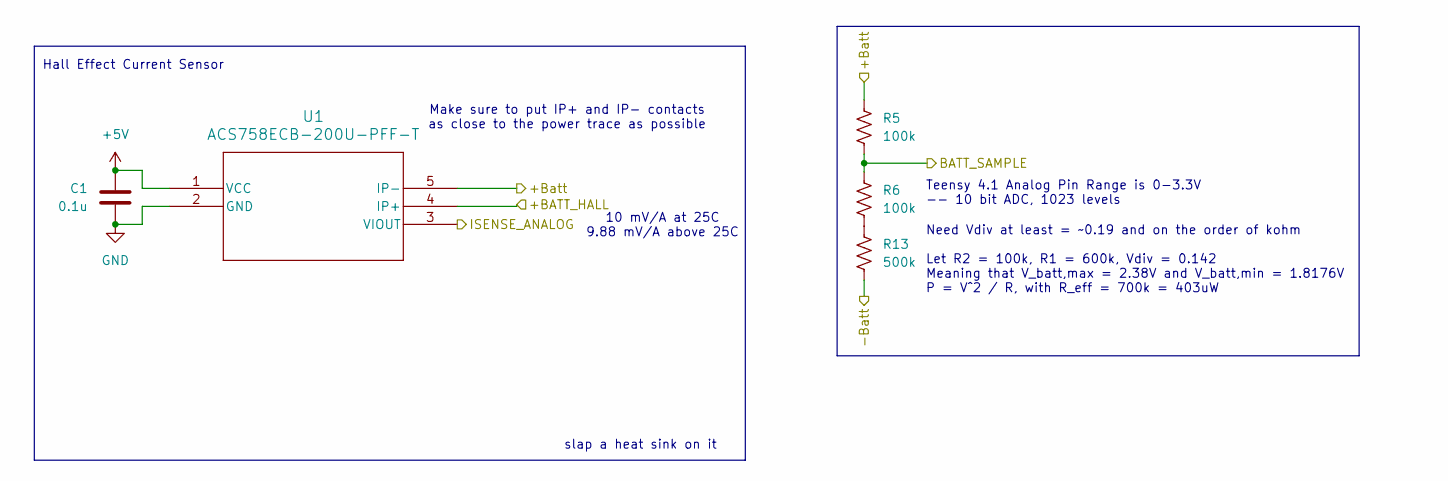
[picture p82: schematic V_I_sample.kicad_sch]

Parts:
C1: 0.1u; C_0805_2012Metric_Pad1.18x1.45mm_HandSolder
R5, R6: 100k; R_0805_2012Metric_Pad1.20x1.40mm_HandSolder
R13: 500k; R_0805_2012Metric_Pad1.20x1.40mm_HandSolder
U1: ACS758ECB-200U-PFF-T; Allegro_MicroSystems,_LLC-CB-5-PFF-0-0-MFG

Connections:
+5V: C1.2, U1.1 (VCC); also elsewhere on the board
/Battery_input/+BATT_HALL: U1.4 (IP+); also elsewhere on the board
/Battery_input/-Batt: R13.2; also elsewhere on the board
/FETs/+Batt: R5.1, U1.5 (IP-); also elsewhere on the board
/OCP_UVP_detect/BATT_SAMPLE: R5.2, R6.1; also elsewhere on the board
/OCP_UVP_detect/ISENSE_ANALOG: U1.3 (VIOUT); also elsewhere on the board
GND: C1.1, U1.2 (GND); also elsewhere on the board
unnamed: R6.2, R13.1

Notes on the sheet:
Need Vdiv at least = ~0.19 and on the order of kohm Let R2 = 100k, R1 = 600k, Vdiv = 0.142 Meaning that V_batt,max = 2.38V and V_batt,min = 1.8176V P = V^2 / R, with R_eff = 700k = 403uW
Hall Effect Current Sensor
Teensy 4.1 Analog Pin Range is 0-3.3V -- 10 bit ADC, 1023 levels
10 mV/A at 25C 9.88 mV/A above 25C
Make sure to put IP+ and IP- contacts as close to the power trace as possible
slap a heat sink on it

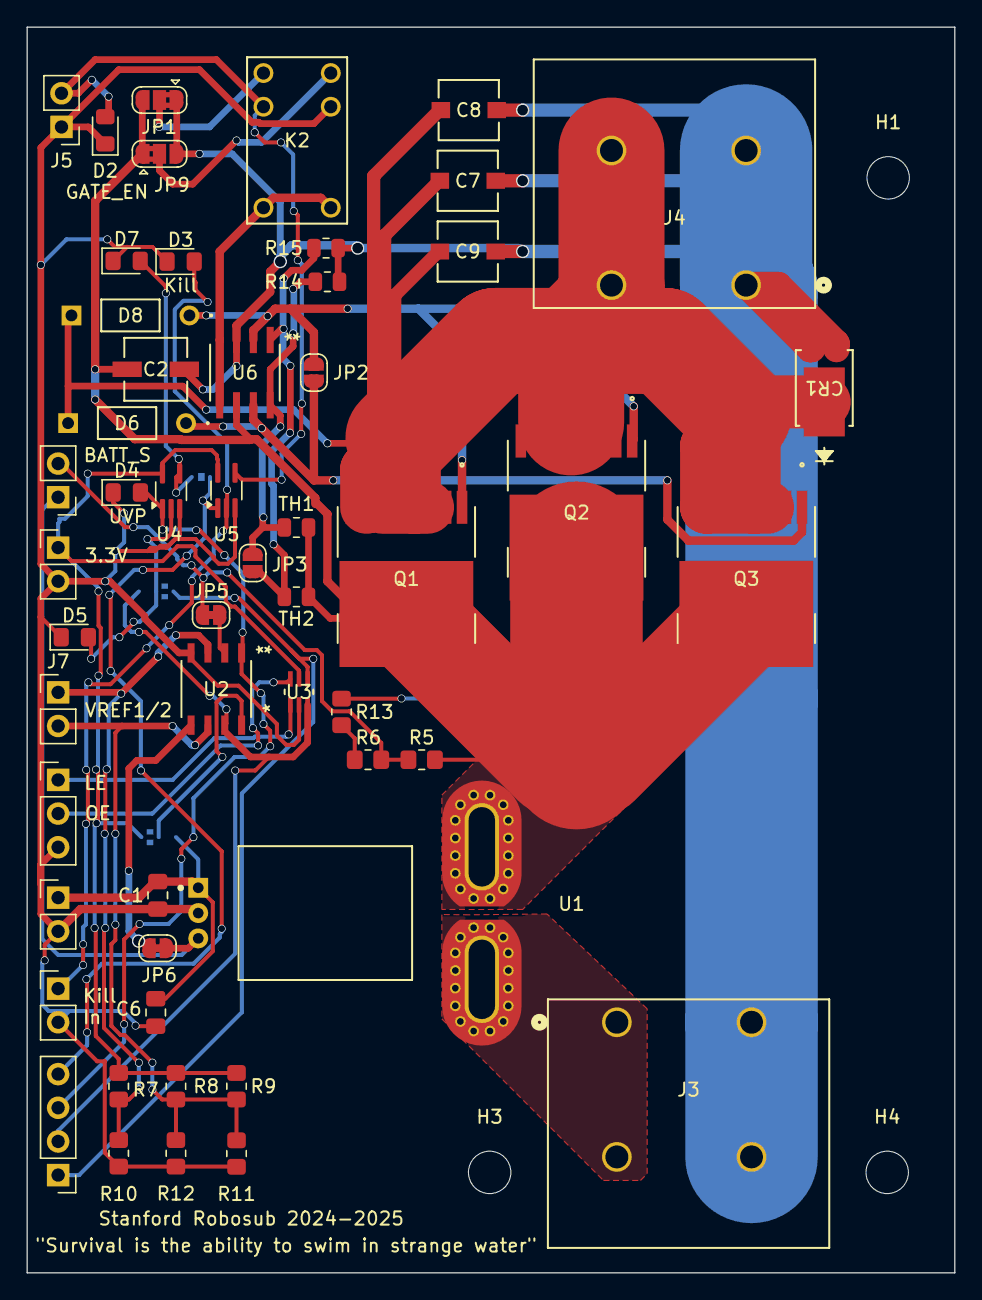
[picture p83: board Power_Management.kicad_pcb from above]

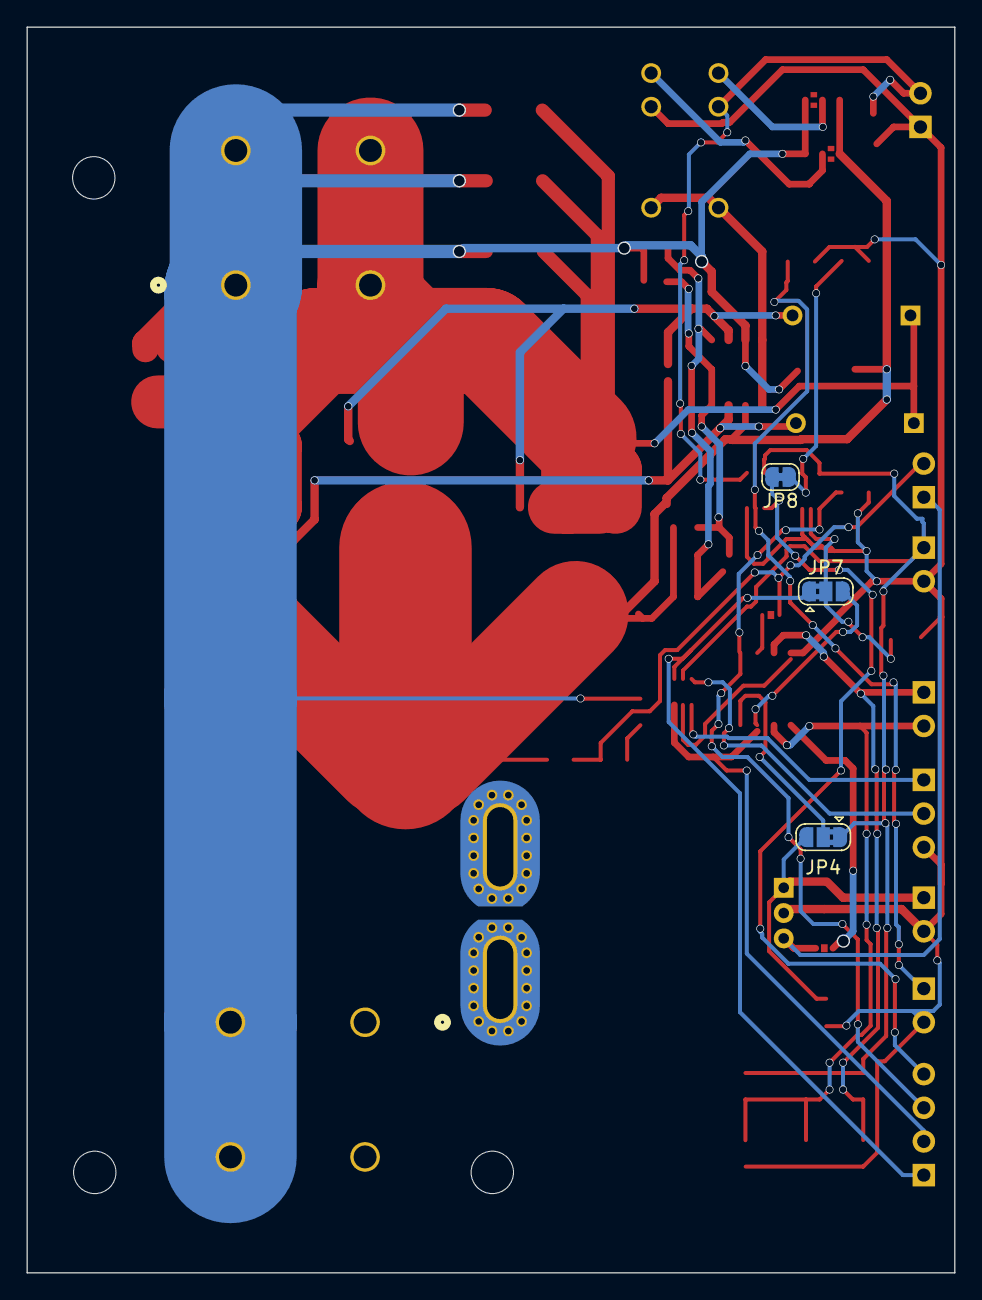
[picture p84: board Power_Management.kicad_pcb from below]

Board: 2 copper layers, 70.0 x 94.0 mm, 59 parts (3 on the bottom side), 32 nets.
