ryos17/robosub-ee/gen2/PCBs/Battery_hot_swap_top/Battery_hot_swap_top.kicad_pcb

## KiCad design gen2/PCBs/Battery_hot_swap_top/Battery_hot_swap_top.kicad_pcb (2026-02-21, an earlier design)

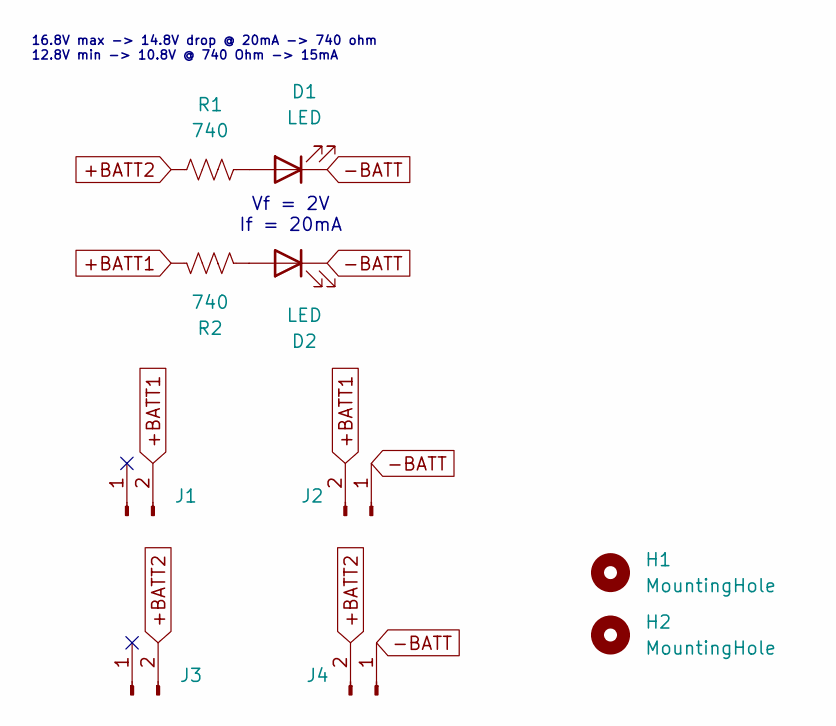
[picture p85: schematic Battery_hot_swap_top.kicad_sch]

Parts:
D1, D2: LED; LED_D4.0mm
H1, H2: MountingHole; MountingHole_3.2mm_M3
J1, J3: Conn_01x02_Pin; AMASS_XT60-M_1x02_P7.20mm_Vertical
J2, J4: Conn_01x02_Pin; AMASS_XT60-F_1x02_P7.20mm_Vertical
R1, R2: 740; R_0805_2012Metric_Pad1.20x1.40mm_HandSolder

Connections:
+BATT1: J1.2, J2.2, R2.1
+BATT2: J3.2, J4.2, R1.1
-BATT: D1.1 (K), D2.1 (K), J2.1, J4.1
unnamed: D1.2 (A), R1.2
unnamed: D2.2 (A), R2.2

Notes on the sheet:
16.8V max -> 14.8V drop @ 20mA -> 740 ohm 12.8V min -> 10.8V @ 740 Ohm -> 15mA
Vf = 2V If = 20mA

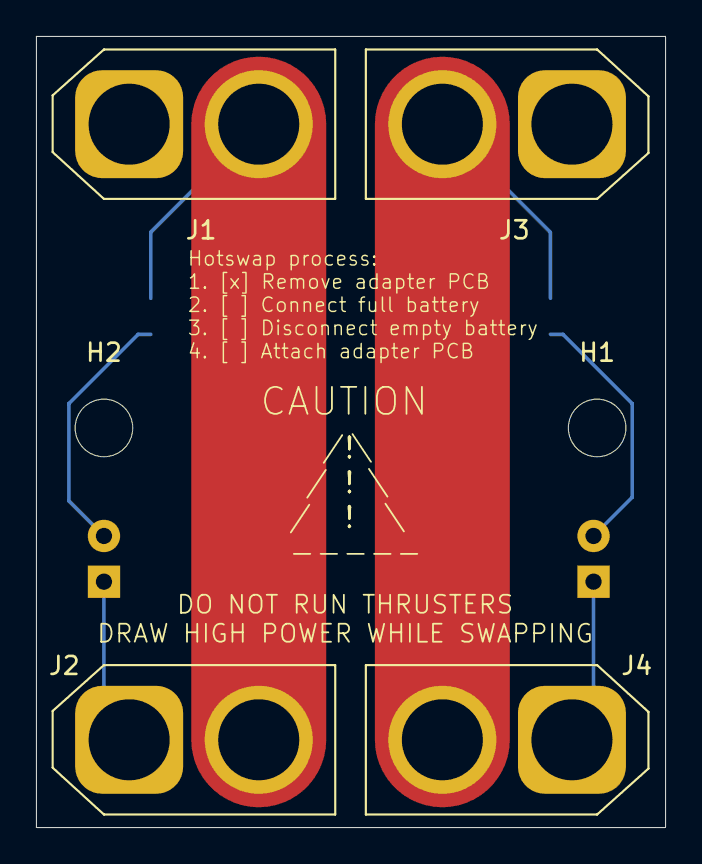
[picture p86: board Battery_hot_swap_top.kicad_pcb from above]

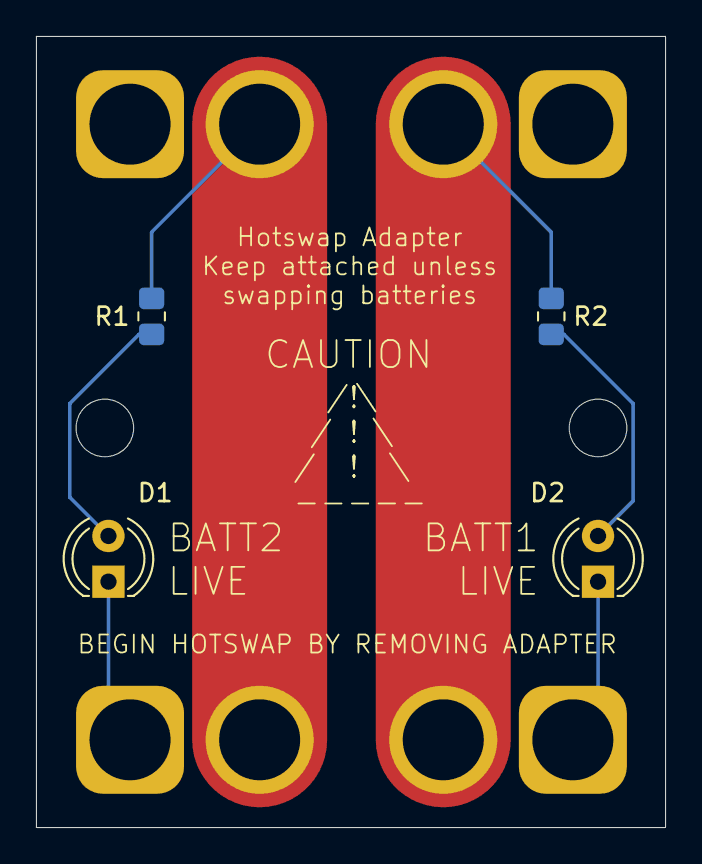
[picture p87: board Battery_hot_swap_top.kicad_pcb from below]

Board: 2 copper layers, 34.9 x 43.9 mm, 10 parts (4 on the bottom side), 5 nets.
