ryos17/robosub-ee/(commit log)

2025-11-12 added internal temperature to STABLE
2026-02-21 refractored code
    [09.03201.02.STEP, 100SP1T1B4M2QE.step, 1017503.step, 1135333.step, 1986660.step, 3296W-1-103RLF.STEP, 430450201.stp, 430450228.stp]
2026-02-21 added gen3 board
    [09.03201.02.STEP, 1017503.step, 1986660.step, 430450201.stp, 430450228.stp, 430450422.stp, 430450426.stp, 430450821.stp]
2026-02-21 reformated and refactored micro pcb board
    [09.03201.02.STEP, 1017503.step, 1986660.step, 430450201.stp, 430450228.stp, 430450422.stp, 430450426.stp, 430450821.stp]
2026-02-21 adding Battery_Boards directory
    [09.03201.02.STEP, 100SP1T1B4M2QE.step, 1017503.step, 1986660.step, 3296W-1-103RLF.STEP, 430450201.stp, 430450228.stp, 430450422.stp]
2026-02-21 Add shared robosub KiCad libraries, importorted 5v regulator, made some changes to battery management board
    [Power_ManagementV3_diode.kicad_pcb, Power_ManagementV3_diode.kicad_sch, TO-252-2_L6.5-W6.1-P4.58-LS10.0-TL.step, robosub_jlc_parts_log.csv]
2026-02-21 power dist fixes 1
2026-02-21 power distttt
2026-02-21 initial designs
    [Micro_Breakout.kicad_sch, SBH11-PBPC-D05-ST-BK.step, peripherals.kicad_sch]
2026-02-22 schematics of microboard done
    [GPIO_Expander.kicad_sch, Micro_Breakout.kicad_sch, NEOs.kicad_sch, Power_management.kicad_sch, SOT-223_L6.5-W3.5-P2.30-LS7.0-BR.step, peripherals.kicad_sch, sensors.kicad_sch]
2026-02-22 fixed up the battery board. should be good to order soon
    [SOIC-16_L9.9-W3.9-P1.27-LS6.0-BL.step, robosub_jlc_parts_log.csv]
2026-02-22 added caps to micro breakout
    [Micro_Breakout.kicad_sch, Power_ManagementV3_diode.kicad_pcb, Power_ManagementV3_diode.kicad_sch]
2026-02-22 added back 5V regulator footprints
    [robosub_jlc_parts_log.csv]
2026-02-22 microcontroller breakout board completed!!
    [430450212.stp, 430450412.stp, 430450612.stp, Micro_Breakout.kicad_pcb, Micro_Breakout.kicad_sch, XT30PW-F.stp, XT60PW FEMALE.STEP]
2026-02-22 power dist board
    [Power_Distribution.kicad_sch]
2026-02-22 bms board finished
    [Power_ManagementV3_diode.kicad_pcb, Power_ManagementV3_diode.kicad_sch, bom.csv, designators.csv, positions.csv]
2026-02-25 power dist final?
    [Power_Distribution.kicad_pcb, TBL008V-1000-04BE.step]
2026-02-25 added to_order
    [Power_ManagementV3_diode.kicad_pcb, to_order.kicad_pcb, to_order.kicad_sch]
2026-02-25 fixed pinout for ribbon
    [Micro_Breakout.kicad_pcb, Micro_Breakout.kicad_sch]
2026-02-25 fixed GND plane
    [Micro_Breakout.kicad_pcb]
2026-02-27 to_order has the 3 main pcbs consolidated. pcbs have been put into production
    [Power_ManagementV3_eli.kicad_pcb, bom.csv, designators.csv, positions.csv, to_order.kicad_pcb]
2026-04-08 connected missing SDA SCL connection on gen 3 micro board
    [Micro_Breakout.kicad_pcb, Micro_Breakout.kicad_sch]
2026-04-15 added all custom in robosub_3d_models
    [09.03201.02.STEP, 1017503.step, 1986660.step, 430450201.stp, 430450212.stp, 430450228.stp, 430450412.stp, 430450422.stp]
2026-04-15 no errors for updating symbol
    [Micro_Breakout.kicad_pcb, Micro_Breakout.kicad_sch]
2026-04-15 jlc_to_robosub working, and all parts are updated.
    [MSOP-8_L3.0-W3.0-P0.65-LS4.9-BL.step, Micro_Breakout.kicad_pcb, Micro_Breakout.kicad_sch, robosub_jlc_parts_log.csv]
2026-04-15 updated parts to include jlcpcb as library path
    [Micro_Breakout.kicad_sch, robosub_jlc_parts_log.csv]
2026-04-15 deleted and renamed unnecessary step and footprints
    [09.03201.02.STEP, 1017503.step, 1986660.step, 430450201.stp, 430450212.stp, 430450228.stp, 430450412.stp, 430450422.stp]
2026-04-15 jlc_to_robosub is completely working
    [BME280.step, PMEG2020AEA_115.step, robosub_jlc_parts_log.csv]
2026-04-15 edited spreadsheet
    [robosub_jlc_parts_log.csv]
2026-04-15 Updated the whole schematic to now include 3d model
    [Micro_Breakout.kicad_pcb, Micro_Breakout.kicad_sch]
2026-04-21 wired correctly gen3 sub
    [Micro_Breakout.kicad_pcb, Micro_Breakout.kicad_sch]
2026-04-22 some notes to self in new board
2026-04-29 fixed cap on microbreakout
    [Micro_Breakout.kicad_pcb, Micro_Breakout.kicad_sch]
2026-05-20 power distribution board updates
    [Power_Distribution.kicad_pcb, Power_Distribution.kicad_sch]
2026-07-12 changed battery notification voltage to 14.5V
2026-07-13 kill switch implemented
2026-07-14 updated dev to match current stable
2026-07-14 feat(firmware): button-free flashing + raw audio streamer
    - serial_library: built-in reboot->DFU command, non-blocking Init;
    every program polls it so make flash works without BOOT/RESET
    - Makefile: flash target (reboot over serial, then dfu-util; handles
    board already in DFU, refuses multi-board ambiguity)
    - stream_audio: 96k->16k PCM streamer over USB CDC for whisper IVC
    (host side in research/whisper_ivc)
    - README: document every file
2026-07-14 added clear button
2026-07-14 added clear model button
2026-07-15 stream ui is fixed
    [stream_transcribe.py]
2026-07-16 updated base threshold and import issues
    [stream_transcribe.py]
2026-07-20 updated dev firmware to include internal pressure
2026-07-20 Move gen1 PCB boards into gen1/PCBs/
    Relocate Compute_Power_Board, Power_Distribution_Board, and Teensy_Board
    from gen1/ into a gen1/PCBs/ subfolder to match the gen2/gen3 layout.
    [1135333.step, AUIR3241STR.step, Compute_Power_Board.kicad_pcb, Compute_Power_Board.kicad_sch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]
2026-07-26 fixed script and added this toshiba part
    [2SK208-Y(TE85L_F).step, robosub_jlc_parts_log.csv]
2026-07-27 added quarter inch
    [PJ-609BA.step, robosub_jlc_parts_log.csv]
2026-07-27 added 50k pot
    [PTV09A-4015F-B503.step, robosub_jlc_parts_log.csv]
2026-07-27 added dpdt
    [robosub_jlc_parts_log.csv]
2026-07-27 added barrel jack
    [DC-005_5_5-2_0MM.step, robosub_jlc_parts_log.csv]
2026-10-20 analogue circuit plus structuring plus some work on io expanders
2026-10-20 Revert "analogue circuit plus structuring plus some work on io expanders"
    This reverts commit a216e16c9190a96f01bf1cfd183a4e95cc51c464.
2026-11-08 README: add Jetson clock fix and eduroam login instructions
